JasMoH/Photoacoustic/lock_in_amplifier/photos/20171104_151610.jpg

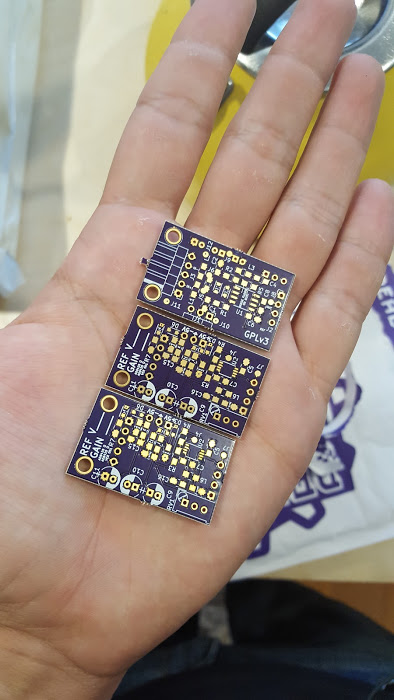
lock_in_amplifier/photos/20171104_151610.jpg
