JasMoH/Photoacoustic/lock_in_amplifier/photos/20171107_141212.jpg

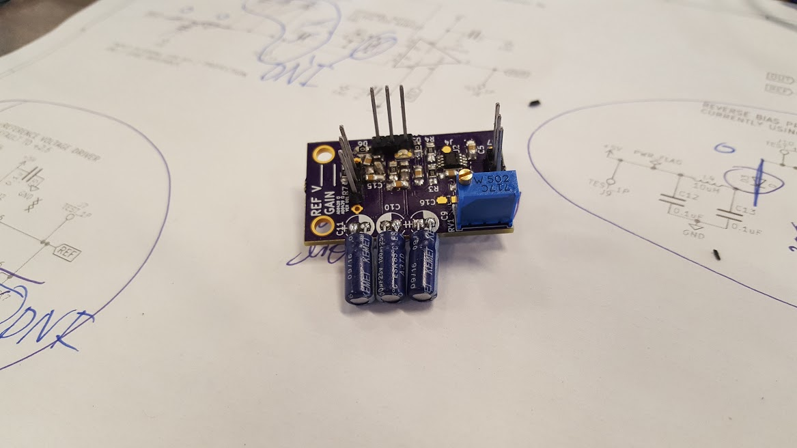
lock_in_amplifier/photos/20171107_141212.jpg
