JasMoH/Photoacoustic/lock_in_amplifier/papers/mosfet_noise.pdf

Noise sources in a MOSFET transistor, 25-01-99, JDS

NIKHEF, Amsterdam.

1. Noise sources in MOSFET transistors.

The noise sources in a MOS transistor are:
thermal noise in the channel,
1/f noise,
Noise in the resistive poly gate,
noise due to the distributed substrate resistance,
shotnoise associated with the leakage current of the drain source reverse diodes.
For normal use, only the first two items are important. The other noise sources must be taken into account for very low noise applications.
1.1. Channel thermal noise.

A MOSFET has in normal working order an inverse resistive channel between the drain and the source. The gate voltage forms with minority carriers the channel. In the extreme case when the drain source voltage
= 0 VDS , the channel can be treated as a homogeneous resistor. The noise in the channel is:

0

2

i | 4 k T g d = ⋅ ⋅ ⋅ | Equation 1.
k | Boltzman constant,
T | Absolute temperature
g0 | channel conductance at zero drain-source voltage.
Normally however the voltage | ≠ 0 VDS | . The VGS is higher as the VGD .
Therefor the channel is more conductive nearby the source, compared to the drain. Conclusion is the channel is not a homogeneous resistor anymore. To calculate the noise it must be split into small parts ( Δx ). The noise must be calculated in every one of those parts and then integrated along the whole channel.
The formula is:
Q (V )dV
L I

W i k T

VDS

n
DS
d | ∫
⋅
⋅

⋅
= ⋅ ⋅ ⋅

0

2
2

2 2
2
4

m
Equation 2.
W | Channel width,
L | Channel length,
μ | Effective channel mobility,
IDS | Drain source current.
The formula for Q (x) n
is:
Q (x) C (V | V (x) V(x)) n | = ox
⋅ GS − T | − | Equation 3.

Cox gate oxide capacitance per unit area,
VT(x) Threshold voltage at position x,
V(x) Channel potential.

In general is the Voltage VT(x) position or channel potential depending. By neglecting this dependency the integral in equation 1 becomes:
( | ) | ( | )
( | )
⋅ | − | −
⋅ | − | ⋅ | − ⋅ | − | −
= ⋅ ⋅ ⋅ ⋅ | ⋅ ⋅
GS | T | DS
GS | T | DS | GS | T | DS
d | ox | V | V | V
V | V V | V | V | V
L
W i | k T | C
2
3 | 3
3

2
4

2 2
2

m

Equation 4.

With the MOSFET we have 3 operation areas: linear region (VDS<VGS-VT), saturation point (VDS=VGS-VT) and saturation region (VDS>VGS-VT).
In the linear region is equation 4 the same as equation 1.
At the saturation point we can simplify the equation to:
( | ) d | ox | GS | T | m V | V | k T | g
L
W i = ⋅k ⋅T ⋅ ⋅ ⋅C ⋅ ⋅ | − | = ⋅ ⋅ ⋅ ⋅
| | 3

2
4
3

2
4

2

m | Equation 5.
gm | The transconductance of the MOSFET.

In the saturation region theoretically its not allowed to use equation 5, however experimentally has been found out that it’s a good approximation, as long as the device shows a good saturation. The reason for this is the fact that the cut-off region nearby the drain is much smaller then the resistive reverse channel which is responsible for the noise.
The expression in equation 5 predicts the thermal noise in the channel without the substrate effect. In practice the thermal noise is higher. This is due to the fact, that VT is depending on the channel potential V(x).
The integral in equation 2 is now hard to solve. In short the result is:
d | m

i = 4⋅ k ⋅T ⋅g ⋅ g
2
Equation 6.

The factor g is a complex function of the basic transistor parameters and bias conditions. To give g a value a numerical approach is required.
For modern CMOS processes with oxide thickness tox in the order of 50 nm and with a lower substrate doping Nb of about 10¹⁵ - 10¹⁶ cm⁻³ the factor g is between 0.67 and 1.

The current noise in the channel also generates noise in the gate through the gate-channel capacitance CoxWL. The gate noise is due to the capacitative coupling frequency depending. (f

2
).The gate noise is about:

( )

2
2 | 2
5
2 | 4
5

1
4
⋅ ⋅ ⋅ | ≈ ⋅ ⋅ ⋅ | ⋅
⋅

≈ ⋅ ⋅

T

m

m

g
f
g | f
f | k T
g
i | k T | p
CGS | gate-source capacitance.

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
The cut off frequency of the MOSFET.

When we compare the gate noise with the drain current noise the only time the gate current noise is important is when the frequency f>fT. Therefore in most practical situations this noise can be neglected.

1.2. 1/f Noise in MOS Transistors.

1/f noise has been observed in all kind of devices, from homogeneous metal film resistors and different kind of resistors to semiconductor devices and even in chemical concentrated cells. Because 1/f noise is well spread over the components, people think that there a fundamental physical mechanism is behind it. Till now such a mechanism is not yet found.
There is a lot of experimental evidence that several mechanisms are involved in generating 1/f noise.
The MOS transistor has the highest 1/f noise of all active semiconductors, due to their surface conduction mechanism.
The result is: several theory's and physical models competing together to explain the 1/f noise in a MOSFET. These theory's and models differ in detail but are all based on the mobility fluctuation model expressed by the Hooge empirical relation, and the carrier density or number fluctuation model first introduced by McWhorter.
1.2.1. The Mobility Fluctuation Model.

When we use the Mobility Fluctuation model we refer to the 1/f noise as Δμ-1/f noise. The model is described by the Hooge empirical equation:

I | N f
i | l
f
⋅

=

a

2

2
Equation 7.
The parameter al is called the Hooge 1/f noise parameter. N is the total number of free carriers in the device and I the short circuit current through the device.
The equation has been checked experimentally with several homogeneous metals and semiconductors (Si and GaAs) and proved to be OK. With all the samples a value of about 2*10⁻³ for al is found. The fact that al almost constant indicates that the Δμ-1/f noise is a fundamental phenomenon.
Theoretical you can derive from Equation 7 the assumption that 1/f noise is caused by N independent free carriers, each generating 1/f noise due to mobility fluctuation.
Experiments proved that only photon scattering rises the 1/f noise.
If in one particular device, for example a MOSFET more than one scattering mechanism exist, impurity scattering, surface scattering, the Hooge 1/f noise parameter a/ should be reduced to:

2
= ⋅

l

eff
l
m

m
a a | Equation 8.

ml is the mobility when only lattice scattering is present and meff is the effective mobility of the device according to Matthiessen's theorem:

= +∑

n

eff | l | i | i

i
m | m | | m
1 | | | 1
Equation 9.

In equation 9 n is the total number of different scattering processes.

Important is the fact, that the Hooge equation is only valid for homogeneous devices. A not homogeneous device the differential form of the equation must be used.

When a MOSFET is used in the linear region, VDS << VSAT = VGS - VT, the inverse channel is almost a homogeneous resistor.

Under strong inversion condition the total number N if the free charge in the inversion channel is given by:

( | ) N Cox W L VGS | VT
q ⋅ = | ⋅ ⋅ ⋅ | − | Equation 10.

The drain source current IDS for very small drain source voltages UDS is:

DS

eff
DS | V
L
q | N
I | ⋅
⋅ | ⋅
= | 2

m
Equation 11.

When we fill these two equations into the Hooge equation (7) the result is:

L f

q I V
i
eff | DS | DS

l

eff
f l
⋅
⋅ | ⋅ | ⋅
⋅
= | 2

2
2

m
m

m
a | Equation 12.

When we check equation 12 with the reality we find a deviation of an order of 10³

- 10⁴
| . Therefore the conclusion is that the Hooge equation is
not valid for the MOS inversion channel.

For a MOSFET in the saturation region, with the drain source voltage VDS is larger than the saturation voltage, the channel is, even in the x direction, not a homogeneous layer. To solve this we divide the channel into a number of small sections Δx. For each section the Hooge equation can be used. By integrating these over the whole channel the total 1/f noise power spectrum can be calculated:
( )

L f

q | V | V I
i
f | GS | T | DS
f | l
⋅
⋅ | − | ⋅
= ⋅
2

2

m
a | Equation 13.

The transconductance of a MOS transistor is related to IDS by:

m | eff | ox | DS I
L

W
g = 2⋅m ⋅C ⋅ ⋅ | Equation 14.

The equivalent input 1/f noise voltage spectrum density is then:

According to equation 15 is the 1/f noise proportional to VGS - VT, and inversely proportional to the gate oxide capacitance per unit area Cox and the gate area WL, provided that meff and mf do not change with to VGS - VT. These proportionalities have been seen in some experiments, the majority of experiments however show a different outcome. These experiments can be declared with the number fluctuation model.
1.2.2. The number fluctuation model.

In the number fluctuation model we call the 1/f noise Δn-1/f noise.
It is believed to be caused by the random trapping and detrapping of the mobile carriers in the trap located at Si-SiO2 interface and within the gate oxide. This causes a signal with a Lorentzian or generation-recombination spectrum. Superposition or a large number of these signals with the proper time constant result in a 1/f-noise spectrum.
According to this model, the Δn-1/f noise is proportional with the effective trap density near the quasi-Fermi level of the inverse carriers. This has been verified by a large number of experiments.
Also explained by this model is the 1/f noise in the weak inversion region. It is observed that the relative 1/f noise current 2 2
i I f

has a
plateau in this region, which can be explained in the model.

In the interface between Si-SiO2 and in the gate oxide (oxide traps) additional energy states exist. These states and traps communicate randomly with the free charges in the channel. This mechanism obeys the Schokley Read Hall statistics. By using this statistics the mean square fluctuation dnt in the number of trapped carriers in a volume DV = (Wdxdy) at a specific position is given by:
nt

⋅ Nt

⋅ f
t

⋅ f

pt ⋅ΔV
+ ⋅

⋅
= | 2 | 2
1

4
w t

t
d | Equation 16

t = trapping time constant [s].
Nt= trap density [cm⁻³].

k T

t | Et Ft
e

f
⋅

−
+
= | ( | )
1

1
= Fraction of filled traps under steady state condition.

Et = trap energy level [eV].
Ft = trap quasi-Fermi level [eV].

The fluctuation dnt causes fluctuations in the channel free carriers dN that in its turn causes fluctuation in the channel current dIDS.
In strong inversion it is shown that dN = dnt.

( )

C W L f

q | V | V
v
eff | ox
f | GS | T
f | l
⋅ | ⋅ | ⋅ ⋅ ⋅
⋅ ⋅ | −
= ⋅
m

m
a
2

2
Equation 15.

The number of free carriers N is:
( ) | ( | ( ))
∫ | ∫
⋅ = ⋅ | = | ⋅ | ⋅ | − −

L

ox | GS | T

L
q N | q n x dx | W C | V | V V x dx
0 | 0

Equation 17.

The drain source current is given by:
( )

( )
dx

dV x
I | q n x DS = ⋅ | ⋅ m ⋅ | Equation 18.

For the fluctuation of the drain current due to fluctuation in trapped carriers in an elementary volume DV is:
( )
( ) | ( | ( ))

( ) 2

2

2
2

2
2
t
ox | SAT
DS | DS
d

n
dx

dV x
L W C | V | V x

q I
N
L n x

I
i f | d

m
d | d | ⋅
⋅ ⋅ | ⋅ | −

⋅
⋅ =
⋅

=

Equation 19.

To calculate the total 1/f noise we have to integrate equation 19 along the channel, over the energy band gap and into the oxide. The general expression is given in equation 20

Equation 20

To evaluate this integral we must first determinate the distribution of Nt(E,y), t(y,E,V) and the function ft(E,V).
When we have a single trap with an uniform distribution into the oxide, Nt(Et,y) = Nt(Et). The distribution of trapping time constant t(y,E,V) based on the SRH statistics and the tunnelling model of McWorter:
( )
y
y e

⋅
= ⋅

a
t | t 0
with | ( | ) 1
0

1
c n n ⋅

s +

t = | Equation 21
α | = 10⁸
cm

-1
, | McWorter tunnelling constant.
( | )
k T

F E
s | i
n | i
n | n e

⋅

−
= ⋅ | The surface carrier concentration.
( | ) k T
F E
i

t i
n n e

⋅

−
= ⋅
1
c | = 10⁻⁸ cm³
/s The electron capture coefficient.

In the practical case t0 = 10⁻¹⁰ s. The traps are distributed into the oxide d = 50 Å, the maximum trapping time constant is tmax = 5 10¹¹
s.
With this information we can work out the integral into the oxide:
( | )
( | )
( ) | [ | ]

( )
f

N E

N E
y E V

y E V

t | t
t | t

d

⋅ ⋅

⋅

⋅ | ⋅ | − | ⋅ | =
⋅
⋅ | ⋅
+ | ⋅

⋅
∫

a

w t | w t
w t | a w

t

4

1

arctan | arctan

1
1 | , ,
4 | , ,
max | 0
0

2 2

( )
( | ( ))
( | )
( | )

N (E y) f (E V ) f (E V )dydEdv y E V

y E V
L C | V | V x

q I
i f
t | t | pt

VDS E

E

d
OX SAT DS
d

c

v

, | , | ,
1 | , ,
4 | , ,
0 | 0
2 | 2

2
2
⋅ | ⋅ | ⋅
+ | ⋅

⋅
⋅
⋅ | ⋅ | −

⋅ ⋅
= ∫ ∫∫ | w t
m | t

for

max | 0

2

1
2

1
p t | | | ⋅p ⋅t

< <
⋅ ⋅
f | Equation 22.

Under the condition of a constant space trap distribution a pure 1/f-noise spectrum is obtained in the frequency range of 10⁻¹³ < f < 10⁹
Hz.
Normally the space trap distribution is not constant, the spectrum shows an 1/fα
spectrum with α <> 1.

The next integral to solve is the integral over the trap distribution in the band gap. The exact trap distribution Nt(E) is of minor importance. The only traps that are effective in noise generation, are the traps around the electron quasi-Fermi level Fn. Therefor a good approximation for the integral over the energy band is given by:
( ) ( ) ( ) | ( ) ( ) ( ) t | pt | t | n | t | n | pt | n

E

E

Nt E f E V f E V dE k T N F f F f F

c

v

⋅ | = ⋅ ⋅ ⋅ | ⋅ | ⋅

∫
, | , | 4

Equation 23.

After solving these integrals equation 20 is reduced to:
( )
( ( ))

N (F ) f (F ) f (F )dV
f | V | V x

k T
L C

q I
i f
t | n | t | n | pt | n

V

OX | SAT

DS
d

DS
⋅ | ⋅ | ⋅
⋅ | −

⋅
⋅
⋅

⋅ ⋅
= | ∫
| 0

2

2
2 | 1
a

m

Equation 24.

The quasi-Fermi level is not a constant along the channel. Due to this the function ftfpt varies as well. The expression using SRH statistics is:
( ) ( )
( | )
2 2 | 2

4

2 s i

s
t | n | pt | n
n | n

n
f F f F
⋅ +
⋅ | = | Equation 25

ns(x) is the surface density of the inversion electrons in the channel which is according to the elementary MOS theory related to the channel potential:
( )

SAT

SAT
s s
V
V | V x
n | n

−
= | ⋅
0 | Equation 26

With the equations 25 and 26 the integral in equation 24 can be solved, provided that Nt(Fn) is known. For the simplest case where Nt(Fn) is uniformly distributed in the energy band or at least around Fn the integral is given by:

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
= 2 | 2 | 2

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
SAT DS

t

ox

DS
d
n

n
V
f | V | V

k T N
L C

q I
i f
a

m

Equation 27

The solution in equation 27 is valid under the conditions that:

The traps are uniformly distributed in the space and energy band, or at least around the electron quasi-Fermi level Fn.

The working area for this formula is the linear region till the saturation point VDS>VSAT=VGS-VT.

In the saturation (VDS>VSAT) area the channel thermal noise saturates as well. If in equation 27 VDS<<VSAT , the second term in the denominator in the ln-function can be ignored. The drain current noise increases with the increase of the drain source voltage. The equation reduces to:
( )
C L f

K I
n

n
f

k T N
L C

q I
i f

ox

F DS

i

t | so

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
= 2 | 2

2
2 | 2
ln
16

1
a

m
Equation 28.

The value of KF is constant if Nt(Fn) and nso do not change that much with the bias condition.

Combining equation 28 with equation 14 gives:

1.2.3. Comparing equation 15 and equation 29, we see two discrepancies between the two models (Δμ-1/f and Δn-1/f).

1)In equation 29 the noise is independent of any dc bias condition, while in equation 15 it is directly proportional to the effective gate voltage (Vgs-VT).

2)In equation 29 the noise is inversely proportional to Cox

2
, while
according to equation 15 it is proportional to Cox.

The two discrepancies between the two models don't mean that one of the models is incorrect. Other parameters like the effective mobility μ may affect the noise dependency on the dc bias condition and the oxide thickness.

Many experiments however show a strong dependence of the 1/f noise in a MOSFET on the state density. They can be fitted in equation 29.

( )
C W L f

K
C W L f

K
v f

ox

f

ox

F
f
⋅ ⋅ ⋅

=
⋅ ⋅ | ⋅ ⋅ ⋅
= | 2 | 2
2
2 m

Equation 29

1.3.Additional Noise Sources.

In very low noise applications some other noise sources can get important. These sources are:
1) the thermal noise associated with the resistive poly-gate Rg,
2) Thermal noise due to the resistive substrate Rb,
3) the shot noise associated with the leakage current of the drain-source inverse diodes.
Because the leakage current is always much smaller then the drain current IDS, it's effect is always negligible. On the other hand, if you don't take special precautions in the layout, the noise due to Rg and Rb can prevail over the channel thermal noise.
1.3.1. Resistive Poly-gate Noise.

To calculate the noise due to the poly-gate we use the same procedures as for calculating the MOS channel thermal noise.

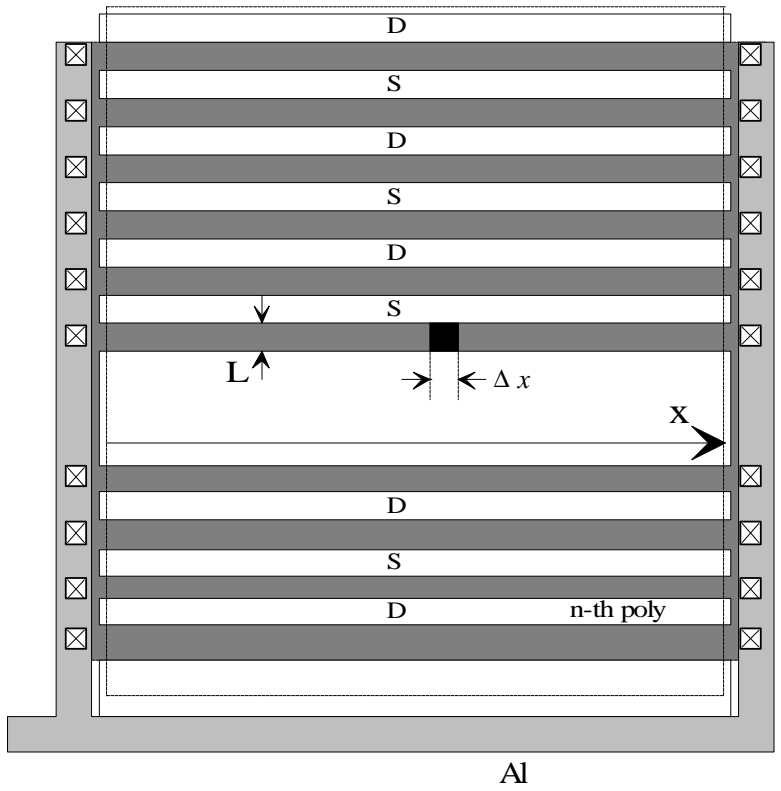
[picture p10: figure]
n-th poly

Figure 1: The finger structure of a MOS transistor.

In practice the finger structure is the most used for a MOS-FET with a large W/L ratio. The advantages of this structure are:
1) Lower CBS and CBD capacitance.
2) More useful in layout to realise.
The total channel width W in this structure is divided into n poly stripes with an equal width of WI = W / n. Both ends of the stripes are connected to aluminium (Al) strips for low noise reasons. The sheet resistance of Al is about 0.05 Ω/sq. and of poly the value is about 25 Ω/sq. The noise contribution of the Al is negligible compared with the contribution of the poly.

The thermal noise of the section Dx is, according to the Nyquist theorem:

L

x
Vx

k T
sq

Δ
Δ = 4⋅ ⋅ ⋅ r ⋅ | Equation 30

rsq is the sheet resistance of the poly gate. The voltage fluctuation dV (x) in the I-th stripe is given by:
( ) | ( ) | x

i

V
W

x
dV x = dV 0 − | ⋅Δ for 0 < x < x0. | Equation 31
( ) | ( ) | x

i

i | V
W

W x
V x | V W | ⋅Δ

−
= −
1
d | d | for x0 < x < wi. | Equation 32

Both ends of a stripe are short-circuited via Al, so dV (0) = dV (Wi). The drain current fluctuations due to the noise voltage are given by:
( ) | ( )
( | )
x | mi

i

W
d | mi | V g
W | x
i | V x g x dx

i

d | d | d | ⋅Δ ⋅d −
Δ | = | ⋅ | = ∫
| | | 2 2 0
| 0

Equation 33

The term dgmi(x) is the transconductance per unit length at position x. We assume that it's constant over the whole stripe Wi.
The drain noise current per stripe is given by:

2

0

2 | 2
12
4 | mi

i

W
d | d | g R
i | i | k T

i
Δ = Δ | | = ⋅ ⋅ ⋅ ⋅

∫
d | Equation 34

In this formula
L

W
R

i

i | sq = r ⋅ | is the resistance and gmi | gmi Wi = d ⋅ is the

transconductance of the i-th stripe. The total noise current is given by simply multiply the expression by n.

2
2
2 | 2
12

4
12
4 | m

g
mi

i
d | g
n

R
g k T

R
i | k T n | ⋅
⋅
Δ = ⋅ ⋅ ⋅ ⋅ ⋅ | = ⋅ ⋅ ⋅ | Equation 35

Rg = nRI is the total gate resistance and gm = ngmi is the total transconductance of the MOSFET.

When we observe equation 35 it's clear that in order to minimise the noise due to the resistive gate the number n should be as large as possible.
A second remark is that if in the finger structure only one side of the gate is connected together with Al, the noise increases with a factor 4.

1.3.2. Substrate resistance noise.

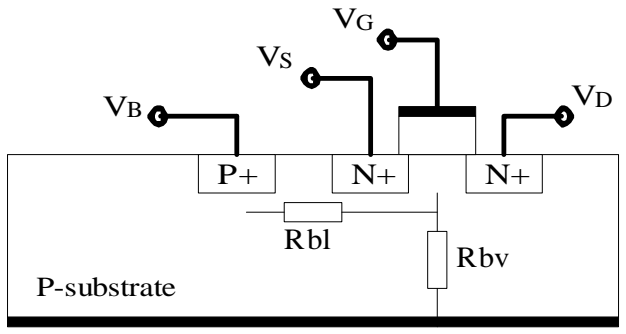
[picture p11: figure]
Rbl; Rbv; P-substrate

Figure 2: The substrate resistors in a nMOS transistor.

In figure 2 the substrate resistors in a nMOS transistor are drawn. The calculation of the noise due to these resistors is more complicated as from the poly gate, because of the distributed nature of the resistors. When we compare both resistors we see that the value of Rbv is much larger as Rbl. Due to this for noise calculations we can neglect Rbv.

The resistor Rbv is proportional to the distance between the bulk contact and the channel and with 1/Wi. The result of the noise in the resistor is the modulation of the channel current due to the bulk transconductance.

f | BS
mb | m
V

K
g g
⋅ ⋅Φ +

= ⋅
2 2
2 | Equation 36.

In this formula K2 is defined before. FF is the difference between the quasi-Fermi level and the intrinsic level.
The total current noise due to the bulk resistor is there for:|
2 | 2 | 2
4 | 4 mbi | mbi

i

dB | g
W

b
g k T B
W

b
i = ⋅ k ⋅T ⋅ n⋅B⋅ ⋅ | = ⋅ ⋅ ⋅ ⋅ | ⋅ | Equation 37.

The only way to reduce the bulk noise is by biasing the bulk to minimise the noise.

Reference: Low-Noise Wide-Band Amplifiers in Bipolar and CMOS Technologies, Zhong Yuan Chang and Willy M.C. Sansen.
