JasMoH/Photoacoustic/lock_in_amplifier/instrumentation amp bob/inst_amp_v1_render.png

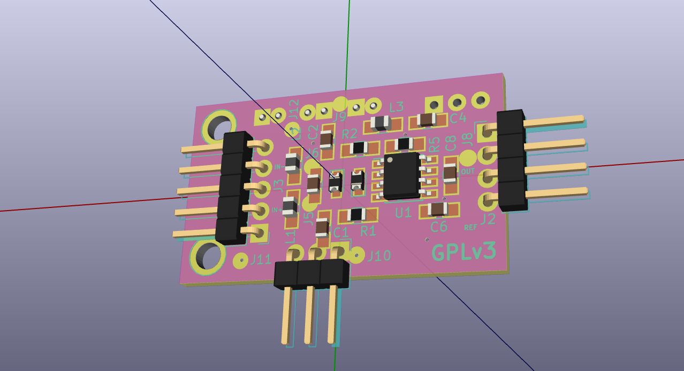
lock_in_amplifier/instrumentation amp bob/inst_amp_v1_render.png
