JasMoH/Photoacoustic/lock_in_amplifier/LIA_Build/dr1 images/lia-design-review.png

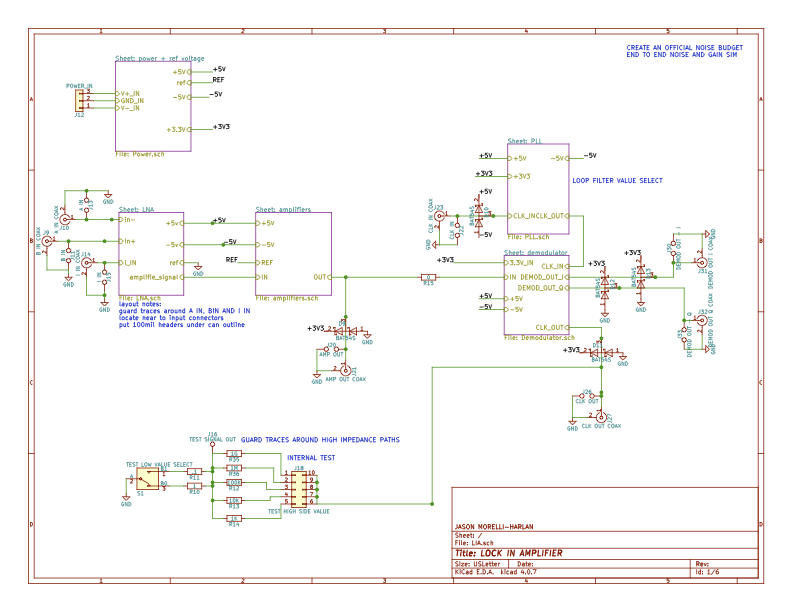
lock_in_amplifier/LIA_Build/dr1 images/lia-design-review.png
