JasMoH/Photoacoustic/lock_in_amplifier/photos/20171109_171020.jpg

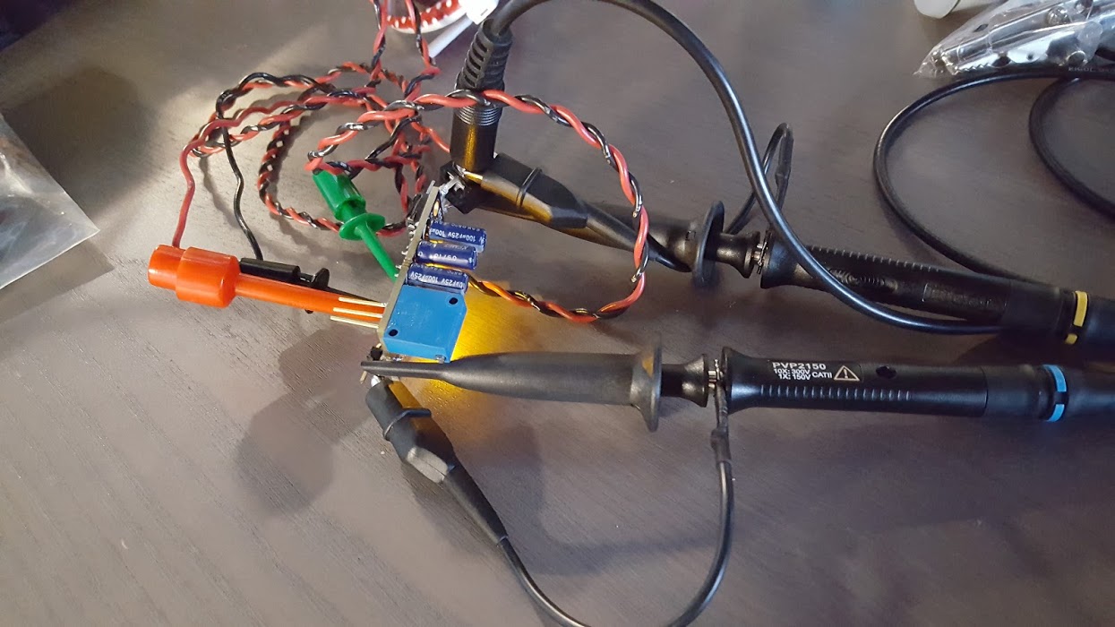
lock_in_amplifier/photos/20171109_171020.jpg
