JasMoH/Photoacoustic/lock_in_amplifier/papers/a_low_noise_laboratory-grade_measurement_preamplifer/low_noise_lab_preamp_BOM_r3.xls

Designator | Quantity | Part Type | Footprint | Description | Manufacturer | Manufacturer Part Number | Mouser Part Number | Comment
C101, C301 | 2 | 1 uF | radial 15 mm | Polypropylene Film Capacitor | Panasonic | ECW-F2105JA | 667-ECW-F2105JA
C102, C108, C109, C202, C203 | 5 | 10 uF | 1206 | Ceramic Capacitor X7R, 25 V | Murata | GRM31CR71E106KA12L | 81-GRM31CR71E106KA12
C103 | 1 | 150 pF | 0805 | Ceramic Capacitor C0G, 50 V | Murata | GRM2165C1H151JA01D | 81-GRM40C151J50D
C104, C107, C303, C304 | 4 | 100 nF | 0805 | Ceramic Capacitor X7R, 50 V | Murata | GCM21BR71H104KA37K | 81-GCM21BR71H104KA37
C105 | 1 | 15 pF | 0805 | Ceramic Capacitor | Murata | GRM2165C1H150JZ01D | 81-GRM40C150J50D
C106 | 1 | 22 pF | 0805 | Ceramic Capacitor | Murata | GRM2165C1H220JZ01D | 81-GRM2165C1H220JZ
C201 | 1 | 220 uF | radial 3.5 mm | Electrolytic Capacitor, 35 V | Panasonic | EEU-FM1V221L | 667-EEU-FM1V221L
C302 | 1 | 1 pF | 0805 | Ceramic Capacitor C0G, 50 V | Murata | GRM2165C1H1R0CD01D | 81-GRM40C010C50D
D101, D202, D203, D204, D205, D301, D302 | 7 | 3.3 V | SOD-123 | Zener Diode | Vishay | BZT52C3V3-V-GS18 | 625-BZT52C3V3-VGS18
D102, D201, D206, D207, D208, D209, D210, D211 | 8 | 1N4148W | SOD-123 | Diode | Vishay | 1N4148W-V-GS18 | 78-1N4148W-VGS18
D212 | 1 |  |  | Light Emitting Diode |  |  |  | Mounted off-board; pick your favourite LED type...
D303, D304 | 2 | 1N4004 | axial 10 mm | Diode | Fairchild Semiconductor | 1N4004 | 512-1N4004
F301, F302 | 2 |  | 1206 | Resettable Fuse, 160 mA | Littelfuse | 1206L016WR | 576-1206L016WR
J101 | 1 |  | 3.81 mm | Connector, 2 Contacts | Phoenix Contact | 1727010 | 651-1727010
J102 | 1 |  | 3.81 mm | Connector, 5 Contacts | Phoenix Contact | 1727049 | 651-1727049
J301 | 1 |  | 3.81 mm | Connector, 3 Contacts | Phoenix Contact | 1727023 | 651-1727023
L101, L102, L103, L104, L105, L106, L107, L108, L109 | 9 | 200 nH | 0805 | Ferrite Bead | Murata | BLM21AG121SH1D | 81-BLM21AG121SH1D
Q101, Q102, Q103, Q104, Q105, Q106, Q107, Q108, Q109 | 9/25 | BF862 | SOT-23 | N-Channel JFET | NXP Semiconductors | BF862,235 | 771-BF862-T/R | Match Q102-Q109 for Vgs @ Id = 1 mA; buy 25 pice
Q301 | 0 | BF862 | SOT-23 | N-Channel JFET |  |  |  | Don't fit; pads used to match Q102-Q109
Q201, Q202, Q205, Q207 | 4 | 2SA1312 | SOT-23 | PNP BJT | Toshiba | 2SA1312GRTE85LF | 757-2SA1312GRTE85LF
Q203 | 1 | MMBF5462 | SOT-23 | P-Channel JFET | Fairchild Semiconductor | MMBF5462 | 512-MMBF5462
Q204, Q206 | 2 | BC850C | SOT-23 | NPN BJT | Fairchild Semiconductor | BC850CMTF | 512-BC850CMTF
R101 | 1 | 10M | MiniMELF | Thin Film Resistor, 1% | Vishay Beyschlag | MMA02040C1005FB300 | 594-MMA02040C1005FB3
R102, R307 | 2 | 15k | MiniMELF | Thin Film Resistor, 1% | Vishay Beyschlag | MMA02040C1502FB300 | 594-MMA02040C1502FB3
R103, R121, R303 | 3 | 100r | MiniMELF | Thin Film Resistor, 1% | Vishay Beyschlag | MMA02040C1000FB300 | 594-MMA02040C1000FB3
R104 | 1 | 200M | axial 15 mm | Metal Oxide Resistor, 1% | Vishay Dale | RNX038200MFKEL | 71-RNX038200MFKEL
R105 | 1 | 1k | MiniMELF | Thin Film Resistor, 0.1% | Vishay Draloric | SMM02040D1001BB300 | 71-SMM02040D1001BB30
R106 | 0 | DNF | MiniMELF | Thin Film Resistor, 1% |  |  |  | Don't fit; used for optional high-accuracy gain trim
R107, R108, R109, R110, R111, R112, R113, R114, R115, R116 | 10 | 10r | 0805 | Thin Film Resistor, 0.1% | Bourns | CRT0805-BY-10R0ELF | 652-CRT0805BY10R0ELF
R117 | 1 | 91r | MiniMELF | Thin Film Resistor, 1% | Vishay Beyschlag | MMA02040C9109FB300 |  | Not stocked by Mouser, order e.g. from Distrelec (713049) or use replacement
R118, R119, R120 | 3 | 51r | MiniMELF | Thin Film Resistor, 1% | Vishay Beyschlag | MMA02040C5109FB300 | 594-MMA02040C5109FB3
R122, R123, R218 | 3 | 10r | MiniMELF | Thin Film Resistor, 1% | Vishay Beyschlag | MMA02040C1009FB300 | 594-MMA02040C1009FB3
R201, R202, R203, R204, R205, R206, R207, R208, R209, R210 | 10 | 130r | MiniMELF | Thin Film Resistor, 1% | Vishay Beyschlag | MMA02040C1300FB300 |  | Not stocked by Mouser, order e.g. from Distrelec (713053) or use replacement
R211, R305 | 2 | 1k5 | MiniMELF | Thin Film Resistor, 1% | Vishay Beyschlag | MMA02040C1501FB300 | 594-MMA02040C1501FB3
R212, R213 | 2 | 10k | MiniMELF | Thin Film Resistor, 1% | Vishay Beyschlag | MMA02040C1002FB300 | 594-MMA02040C1002FB3
R214 | 1 | 110k | MiniMELF | Thin Film Resistor, 1% | Vishay Beyschlag | MMA02040C1103FB300 |  | Not stocked by Mouser, order e.g. from Distrelec (713123) or use replacement
R215 | 1 | 100k | MiniMELF | Thin Film Resistor, 1% | Vishay Beyschlag | MMA02040C1003FB300 | 594-MMA02040C1003FB3
R216 | 1 | 11k | MiniMELF | Thin Film Resistor, 1% | Vishay Beyschlag | MMA02040C1102FB300 | 594-MMA02040C1102FB3
R217 | 1 | 2k7 | MiniMELF | Thin Film Resistor, 1% | Vishay Beyschlag | MMA02040C2701FB300 | 594-MMA02040C2701FB3
R301 | 1 | 1M | MiniMELF | Thin Film Resistor, 1% | Vishay Beyschlag | MMA02040C1004FB300 | 594-MMA02040C1004FB3
R302 | 1 | 750k | MiniMELF | Thin Film Resistor, 1% | Vishay Beyschlag | MMA02040C7503FB300 |  | Not stocked by Mouser, order e.g. from Distrelec (713143) or use replacement
R304 | 1 | 100k | 2.54 mm | Cermet Trimmer | Bourns | 3296Y-1-104LF | 652-3296Y-1-104LF
R306 | 1 | 12k | MiniMELF | Thin Film Resistor, 1% | Vishay Beyschlag | MMA02040C1202FB300 | 594-MMA02040C1202FB3
U101 | 1 | NE5534A | SOIC-8 | Low-Noise Operational Amplifier | Texas Instruments | NE5534AD | 595-NE5534AD
U301 | 1 | TL071 | SOIC-8 | JFET Operational Amplifier | Texas Instruments | TL071CDR | 595-TL071CDR
