JasMoH/Photoacoustic/lock_in_amplifier/LIA_Build/dr1 images/high gain amp.png

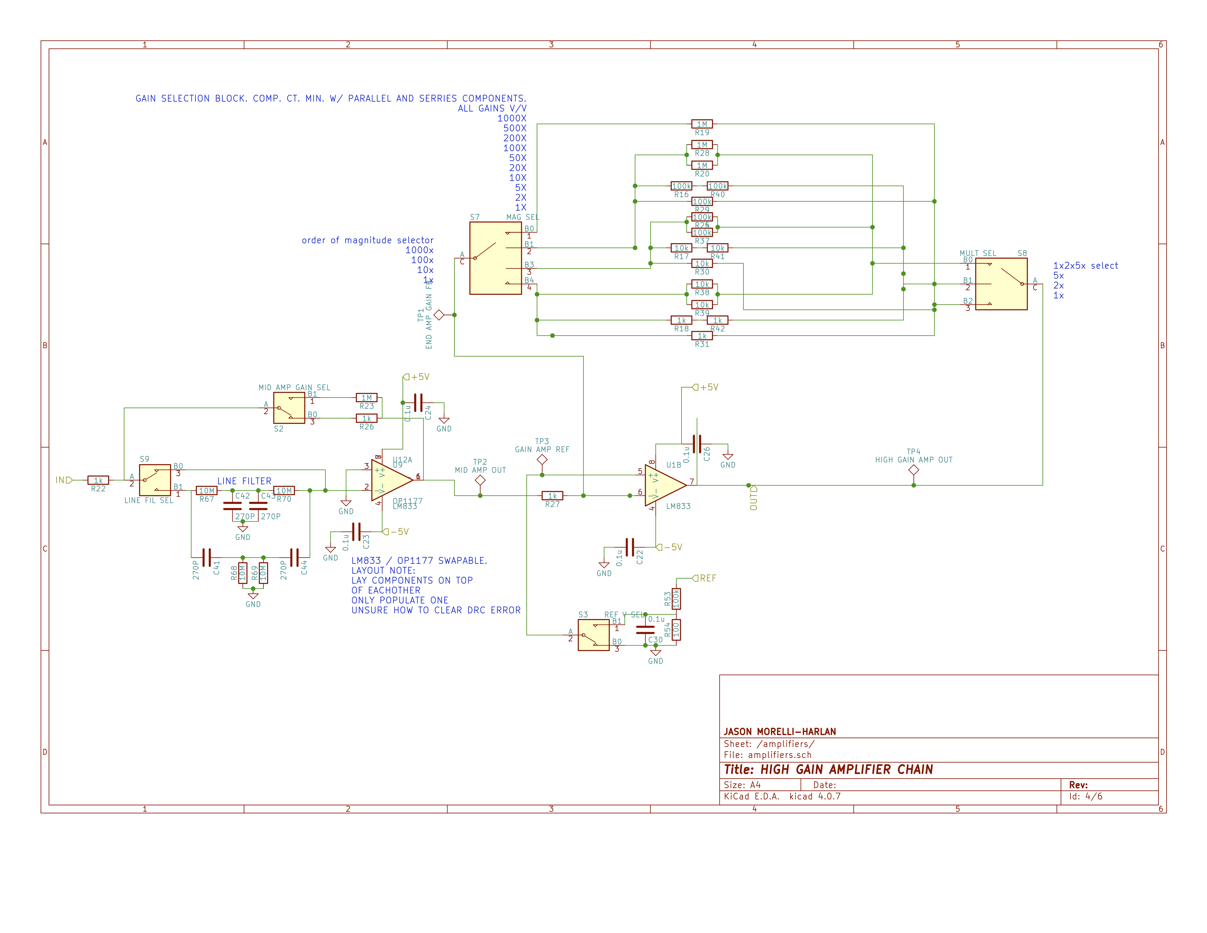
lock_in_amplifier/LIA_Build/dr1 images/high gain amp.png
