JasMoH/Photoacoustic/lock_in_amplifier/LIA_Build/dr1 images/pll.png

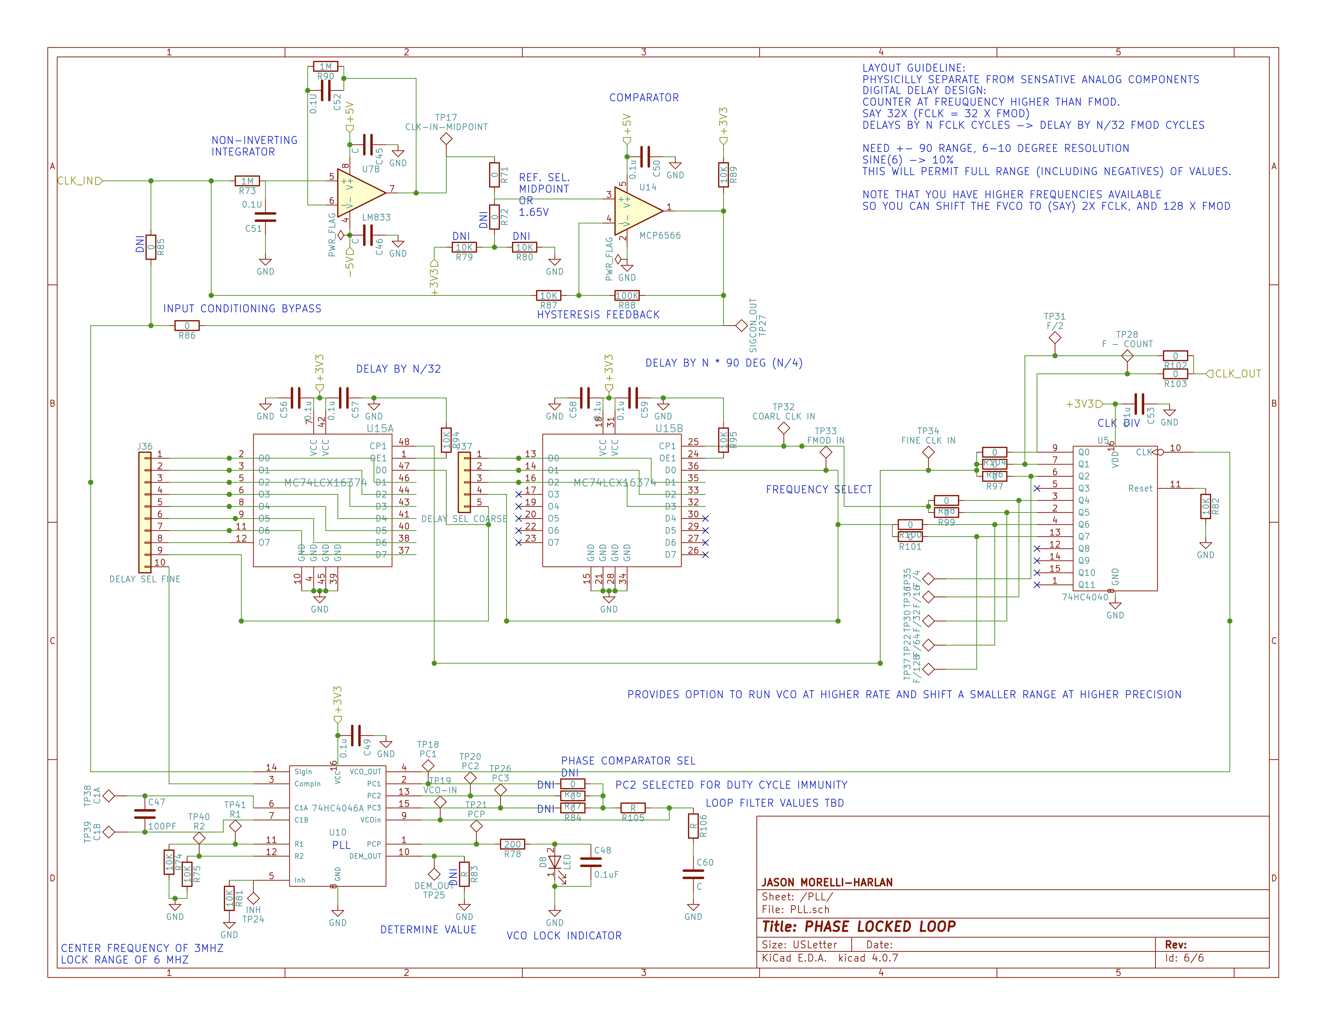
lock_in_amplifier/LIA_Build/dr1 images/pll.png
