JasMoH/Photoacoustic/lock_in_amplifier/LIA_Build/dr1 images/power.png

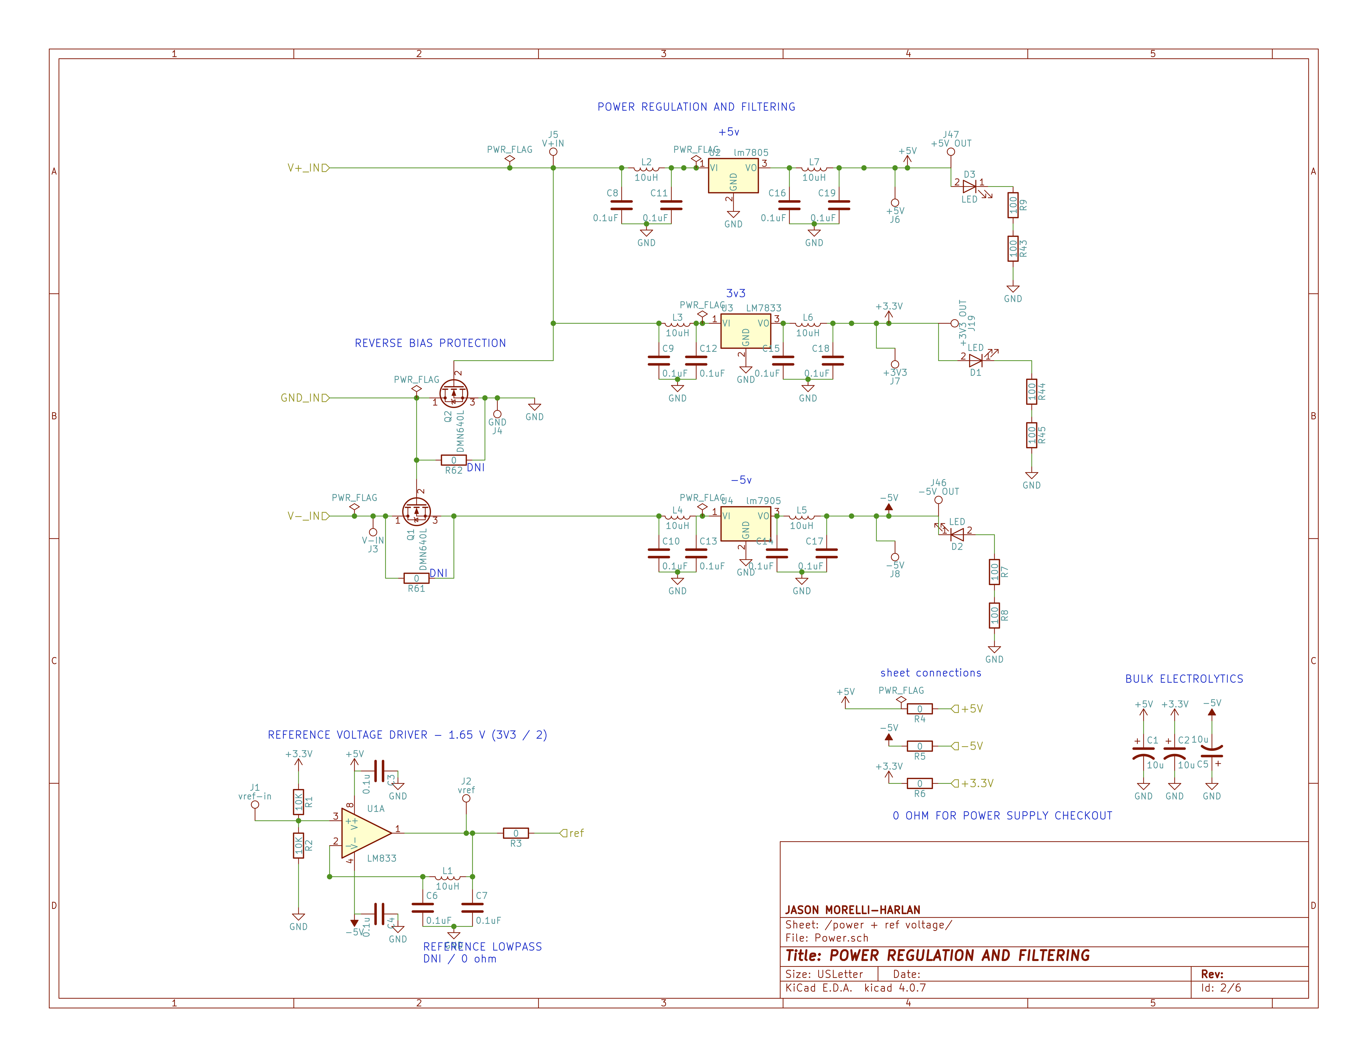
lock_in_amplifier/LIA_Build/dr1 images/power.png
