JasMoH/Photoacoustic/lock_in_amplifier/photos/DS1Z_QuickPrint1.png

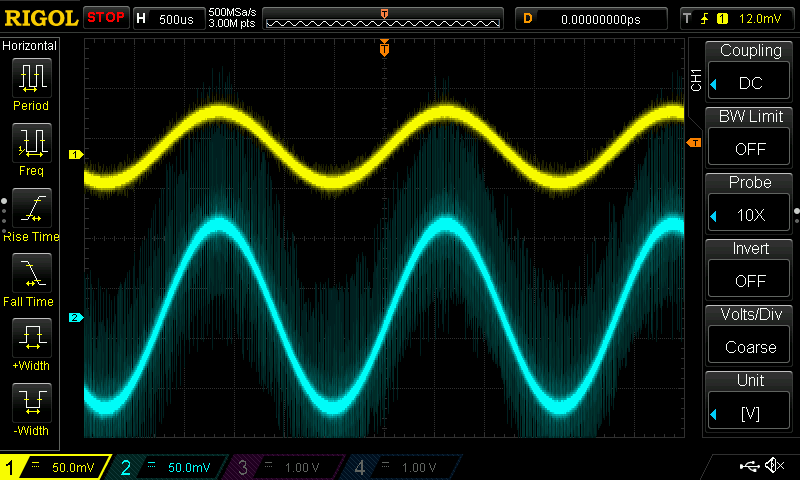
lock_in_amplifier/photos/DS1Z_QuickPrint1.png
