JasMoH/Photoacoustic/(threads)

Thread 1 (2017-12-10):

Sheet 2 - B2

aoberste, 2017-12-10:
Don't put a FET on the ground pin.  It can float your ground relative to system ground due to the voltage loss over the FED substrate diode.

JasMoH, 2017-12-29:
I'll go back to the good old fashioned serries diode for reverse bias protection.

I was pulling from here: http://www.ti.com/lit/an/slva139/slva139.pdf
of course floating your ground wouldn't be an issue for a battery powered device. that's what I get for paying attention.

Thread 2 (2017-12-10):

Sheet 2 - All Regulators

aoberste, 2017-12-10:
Inductors typically aren't required on the inputs/outputs of linear regulators.  The datasheets do not call for them.  I would be wary of including these without simulating, could affect stability.  The linear regulators in use already have noise levels in the uV range, there isn't much benefit to be gained from further filtering.

JasMoH, 2018-01-09:
Marked DNI/0 ohm jumpers, leaving footprint on for now in case I need to tweak.

Pull off of version 2 if unused.

Closed 2018-01-09.

Thread 3 (2017-12-10):

Reference Voltage

aoberste, 2017-12-10:
Your reference voltage will vary with R1 and R2 over initial tolerance and temperature swings.  Why use an op amp?  Can just drop in an linear regulator made for 1.65 reference gen for ~$1.

Thread 4 (2017-12-10):

Check LED current

aoberste, 2017-12-10:
You're using the same series resistance for 3.3V and 5V LEDs.  Without a parts list (using PDF), I can't tell if that's appropriate.  Check currents to prevent damage.

Thread 5 (2017-12-10):

RF Split

aoberste, 2017-12-10:
On sheet 3, it looks like you are splitting an RF input into two demodulators by simply "tee-ing" the trace, or tapping along the way.  This will cause issue.  Research a Wilkinson divider, it can generally be implemented with a few passives.

JasMoH, 2018-01-09:
I'm targeting sub 10 MHz for an initial design, and I'm honestly expecting to be sub 100 kHz for most of it. That's analog, not digital clock rate, so I'm not super concerned with harmonics.

Thanks for the tip though, that's a great design, and I have a soft spot for distributed microwave circuitry.

Closed 2018-01-09.

Thread 7 (2017-12-10):

Demod Outputs

aoberste, 2017-12-10:
On one demod, you've used the positive output.  On the Q you used the negative.  Is this right?

Also, you may need to terminate the unused leg.  Check the datasheet, it depends what type of driver is in the IC.

aoberste, 2017-12-10:
Correction, datasheet says to leave unused outputs floating.  However, it does say to decouple unused inputs to mid voltage.  Look into that.
