JasMoH/Photoacoustic/lock_in_amplifier/LIA_Build/lia-design-review.pdf

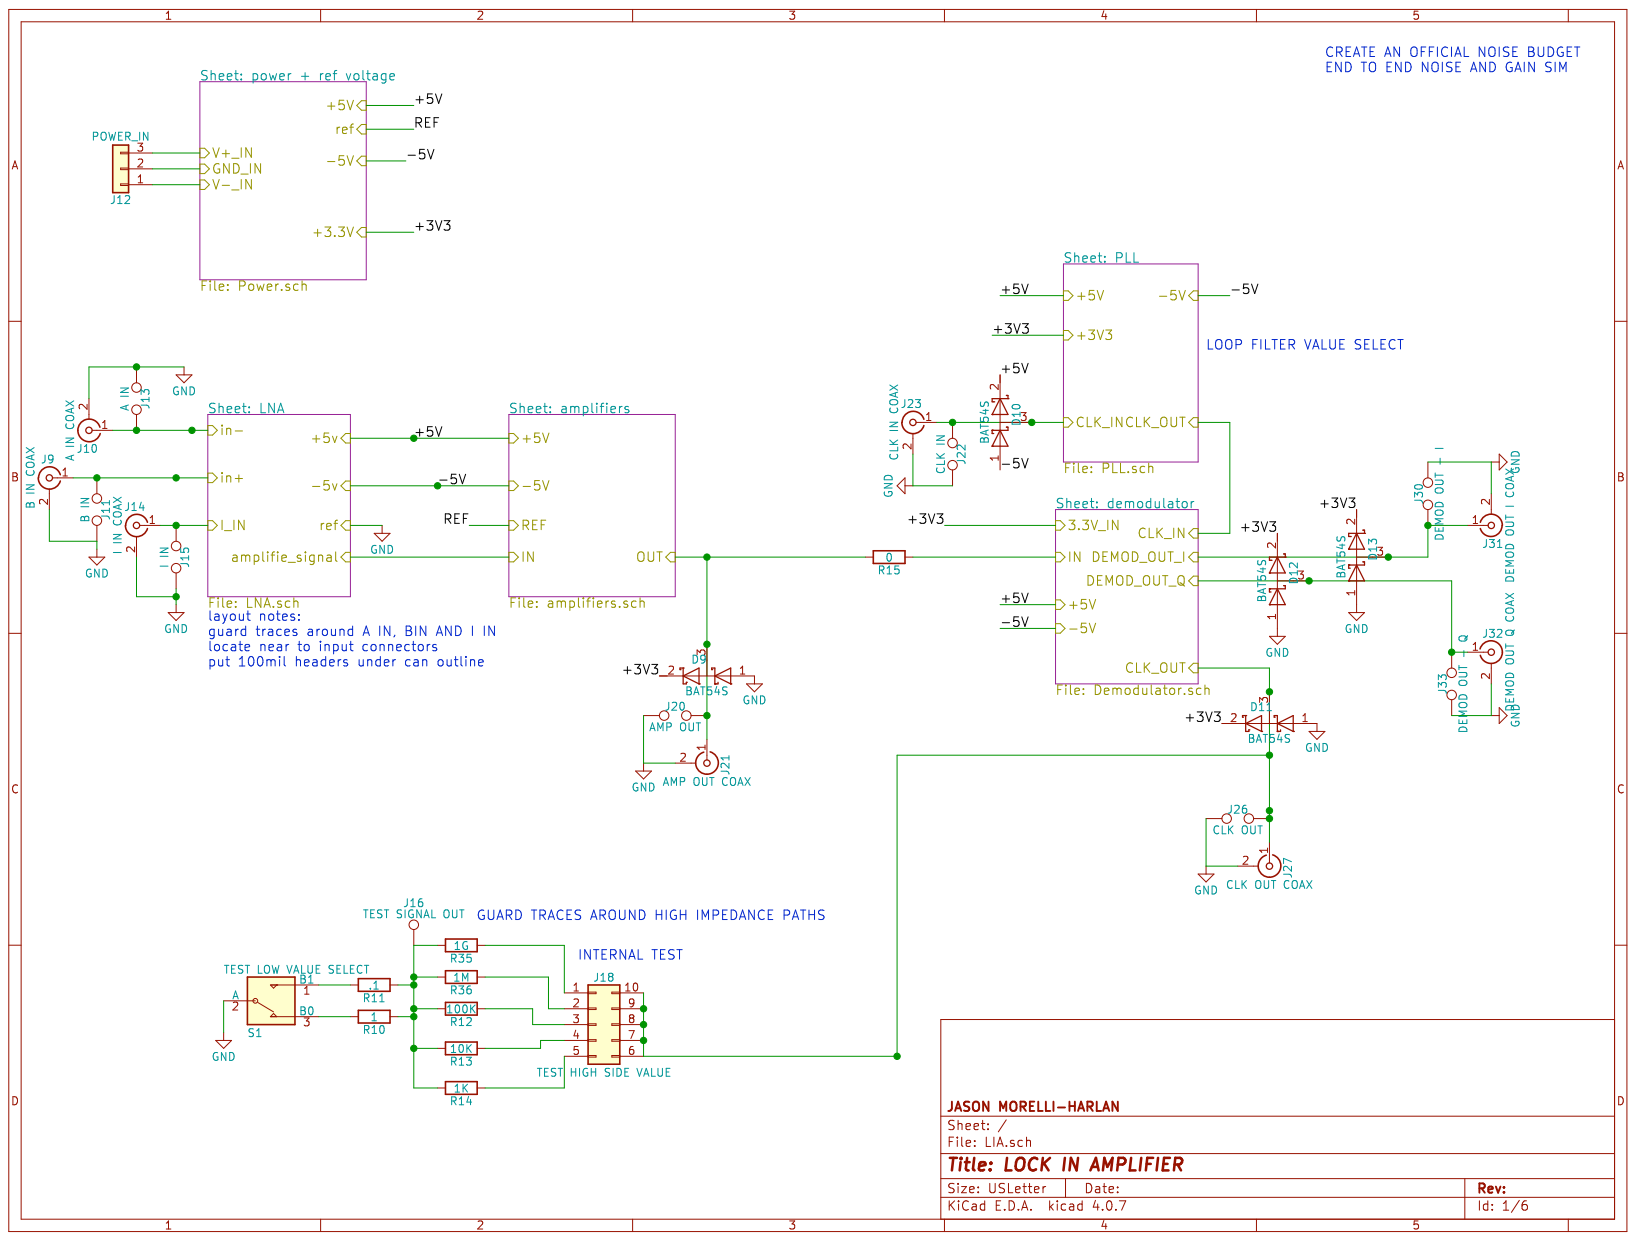
[picture p22: page 1]

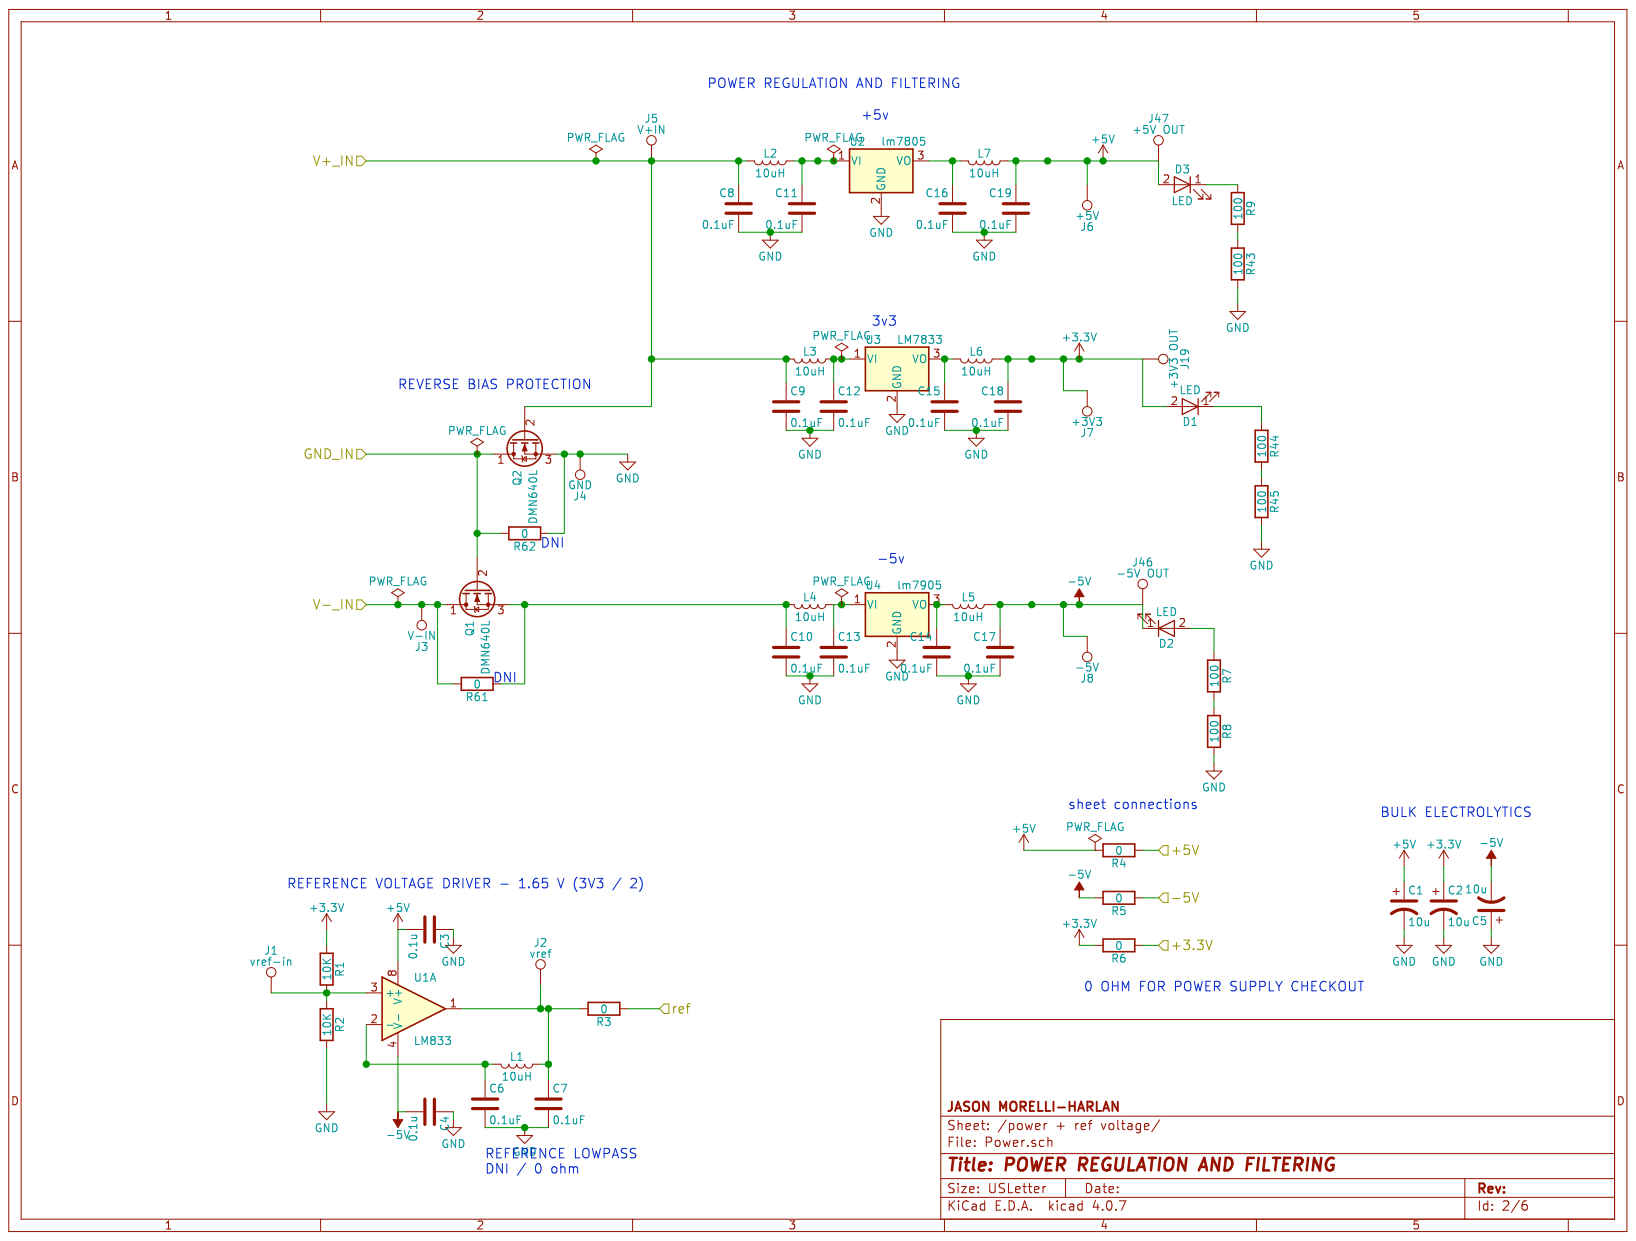
[picture p23: page 2]

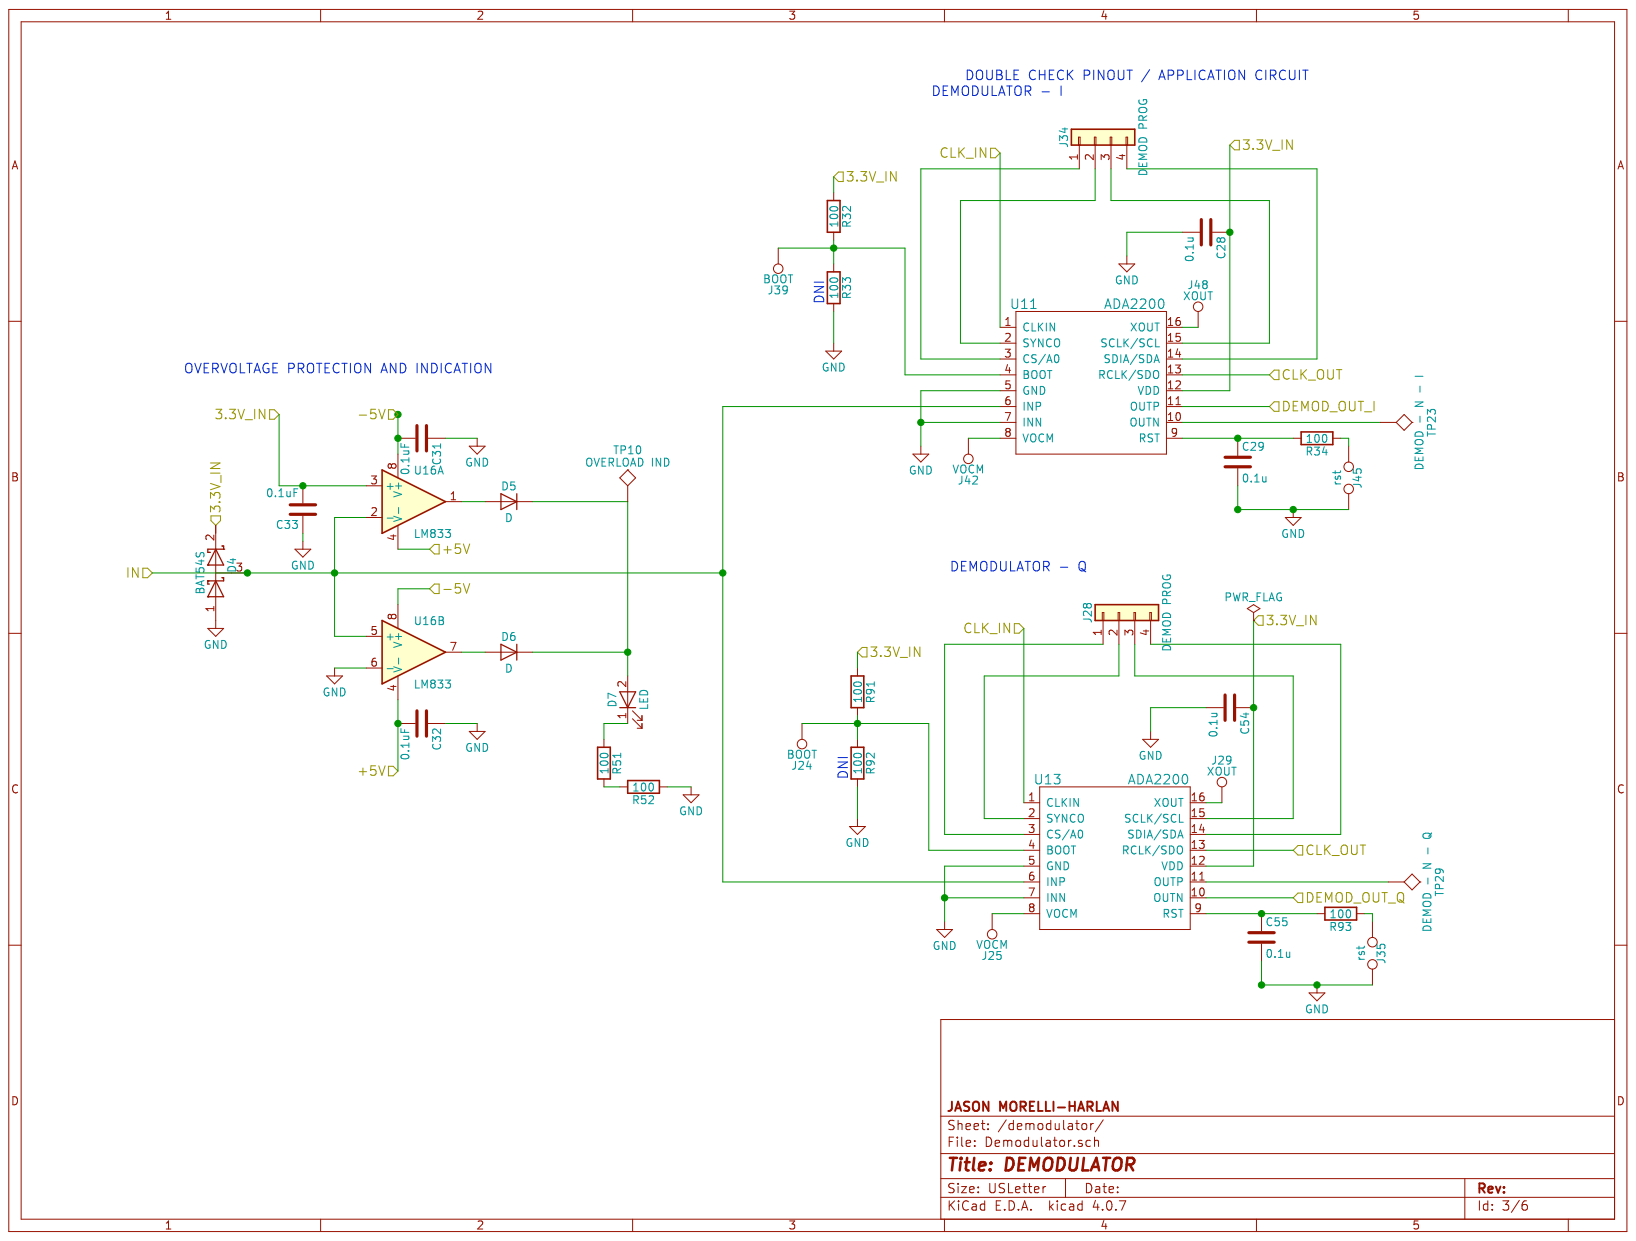
[picture p24: page 3]

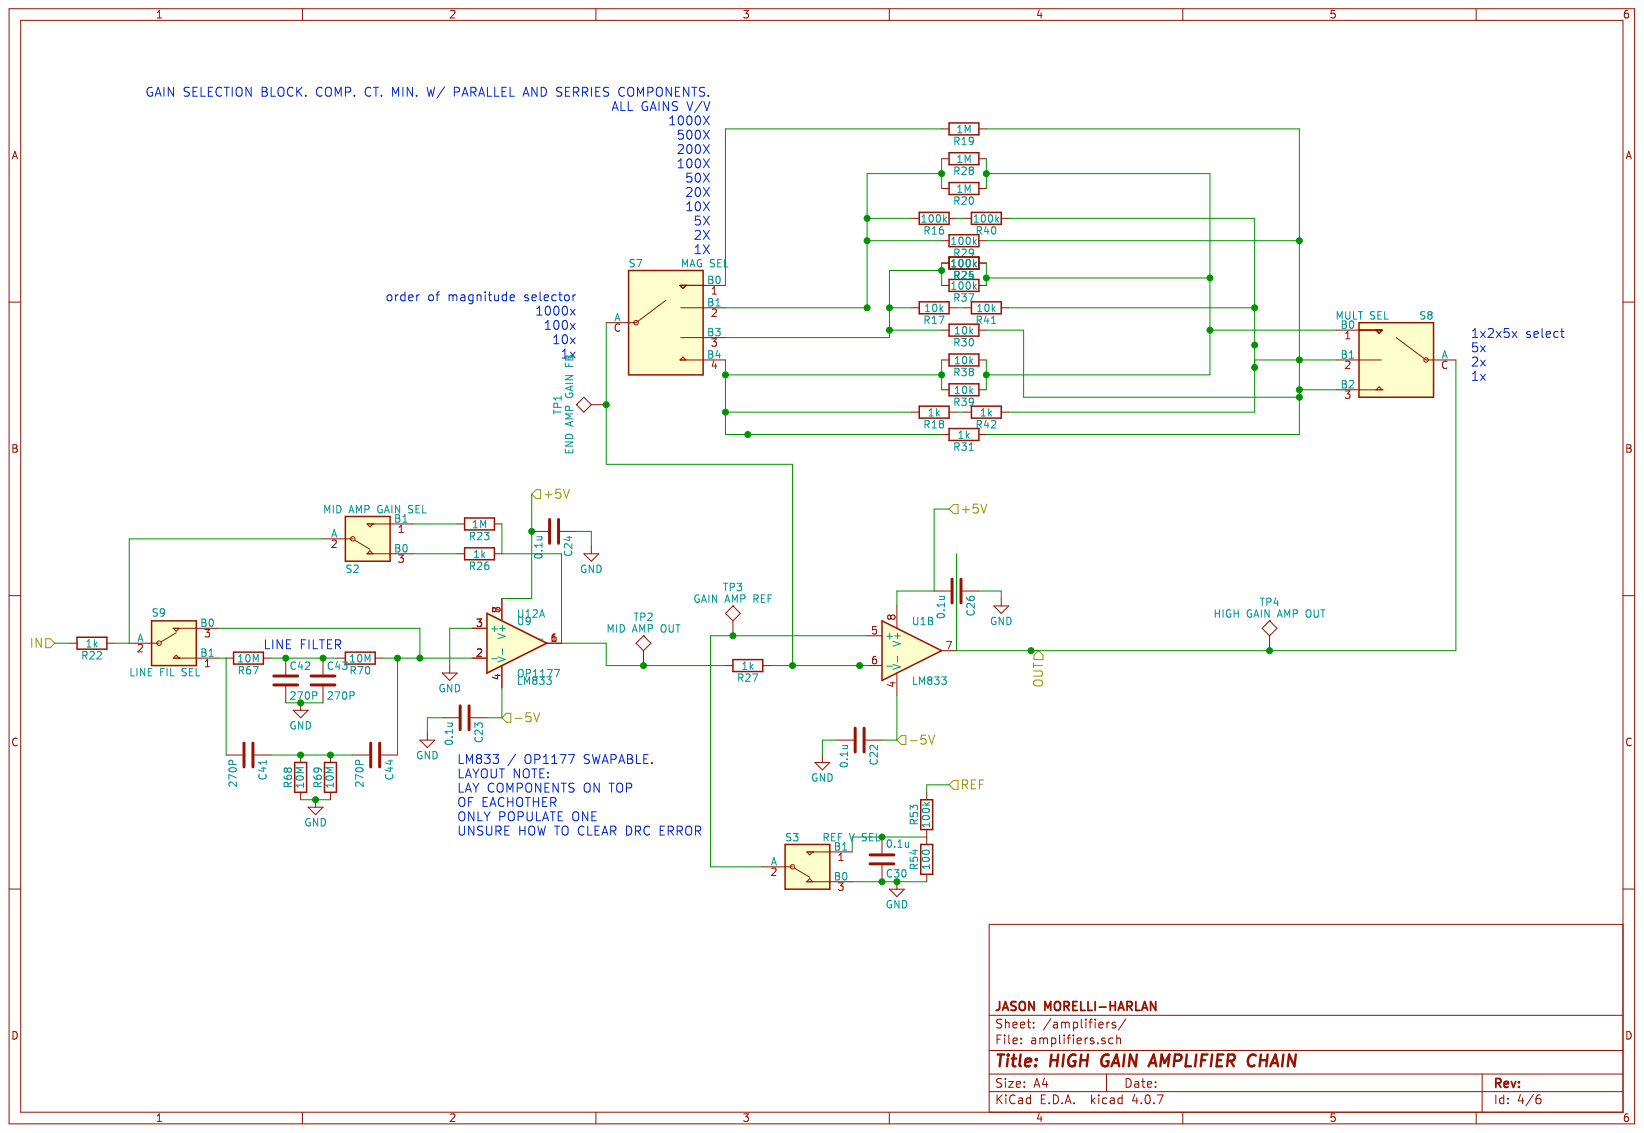
[picture p25: page 4]

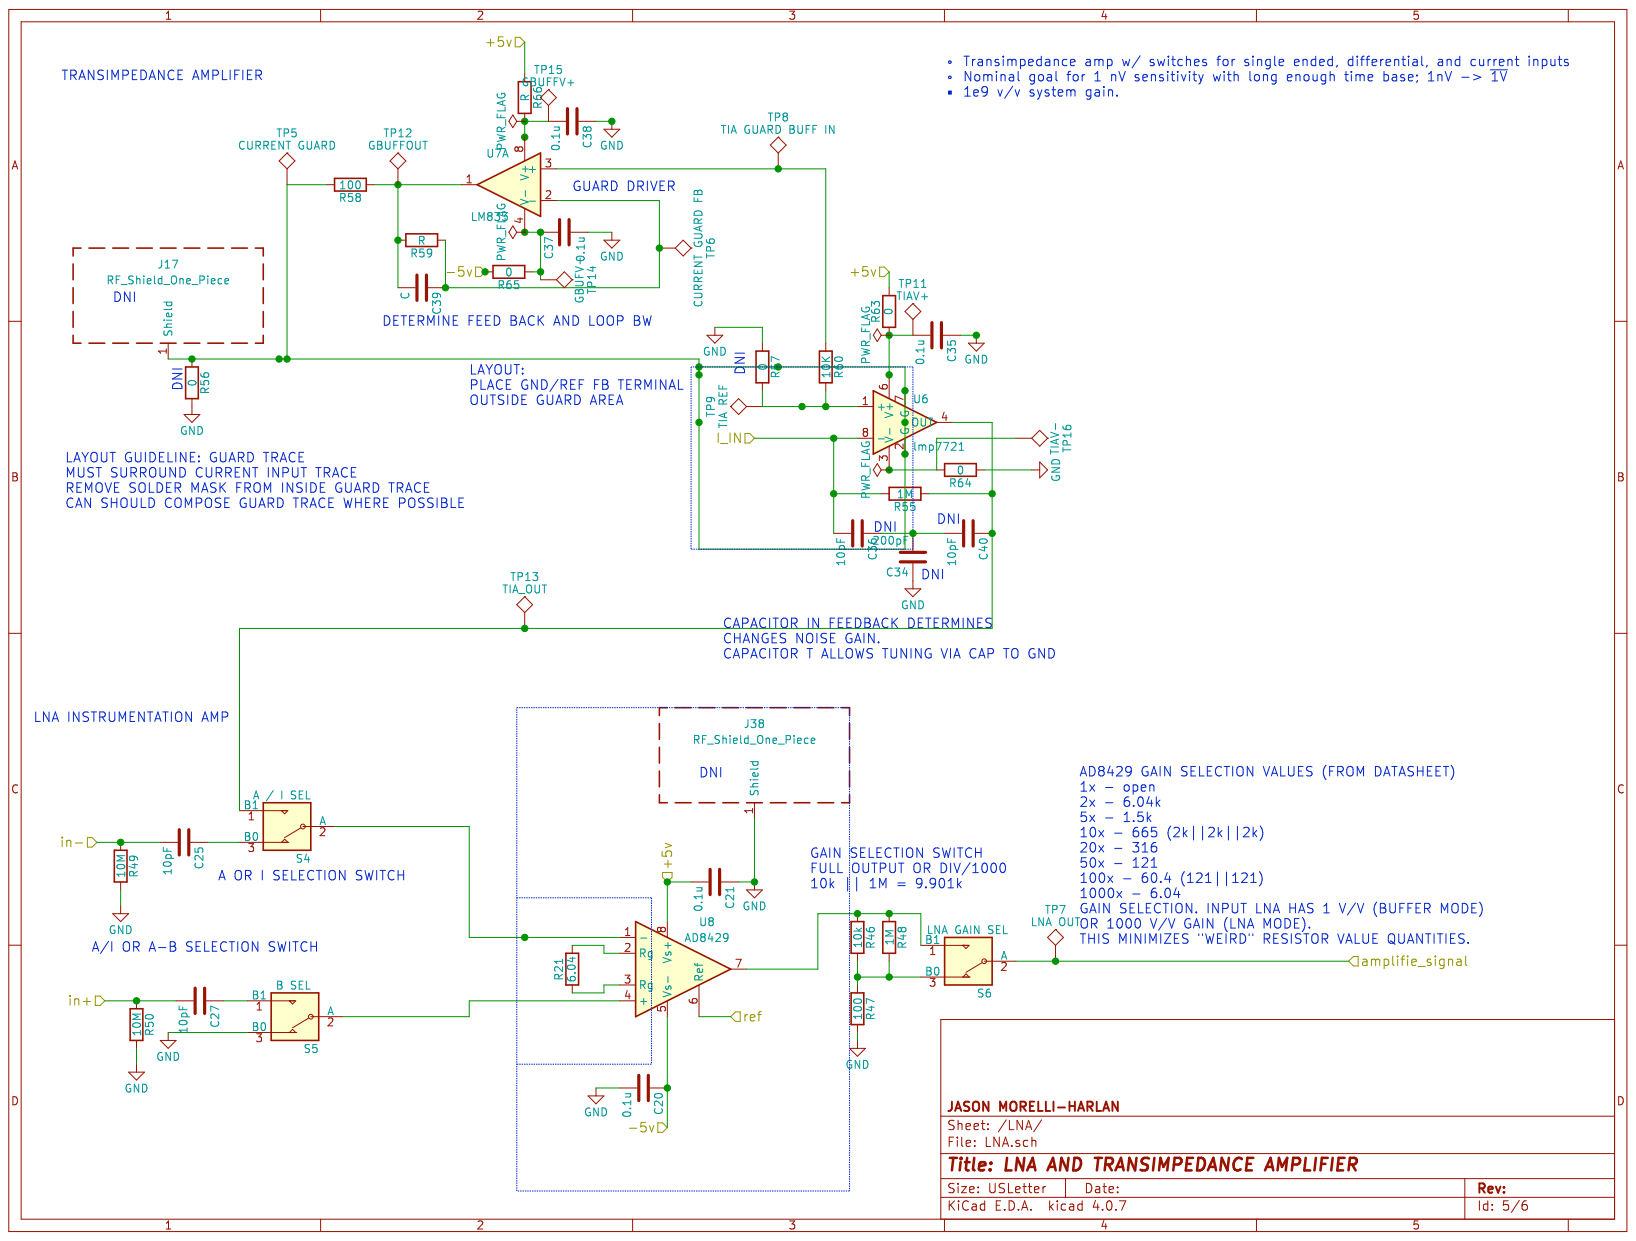
[picture p26: page 5]

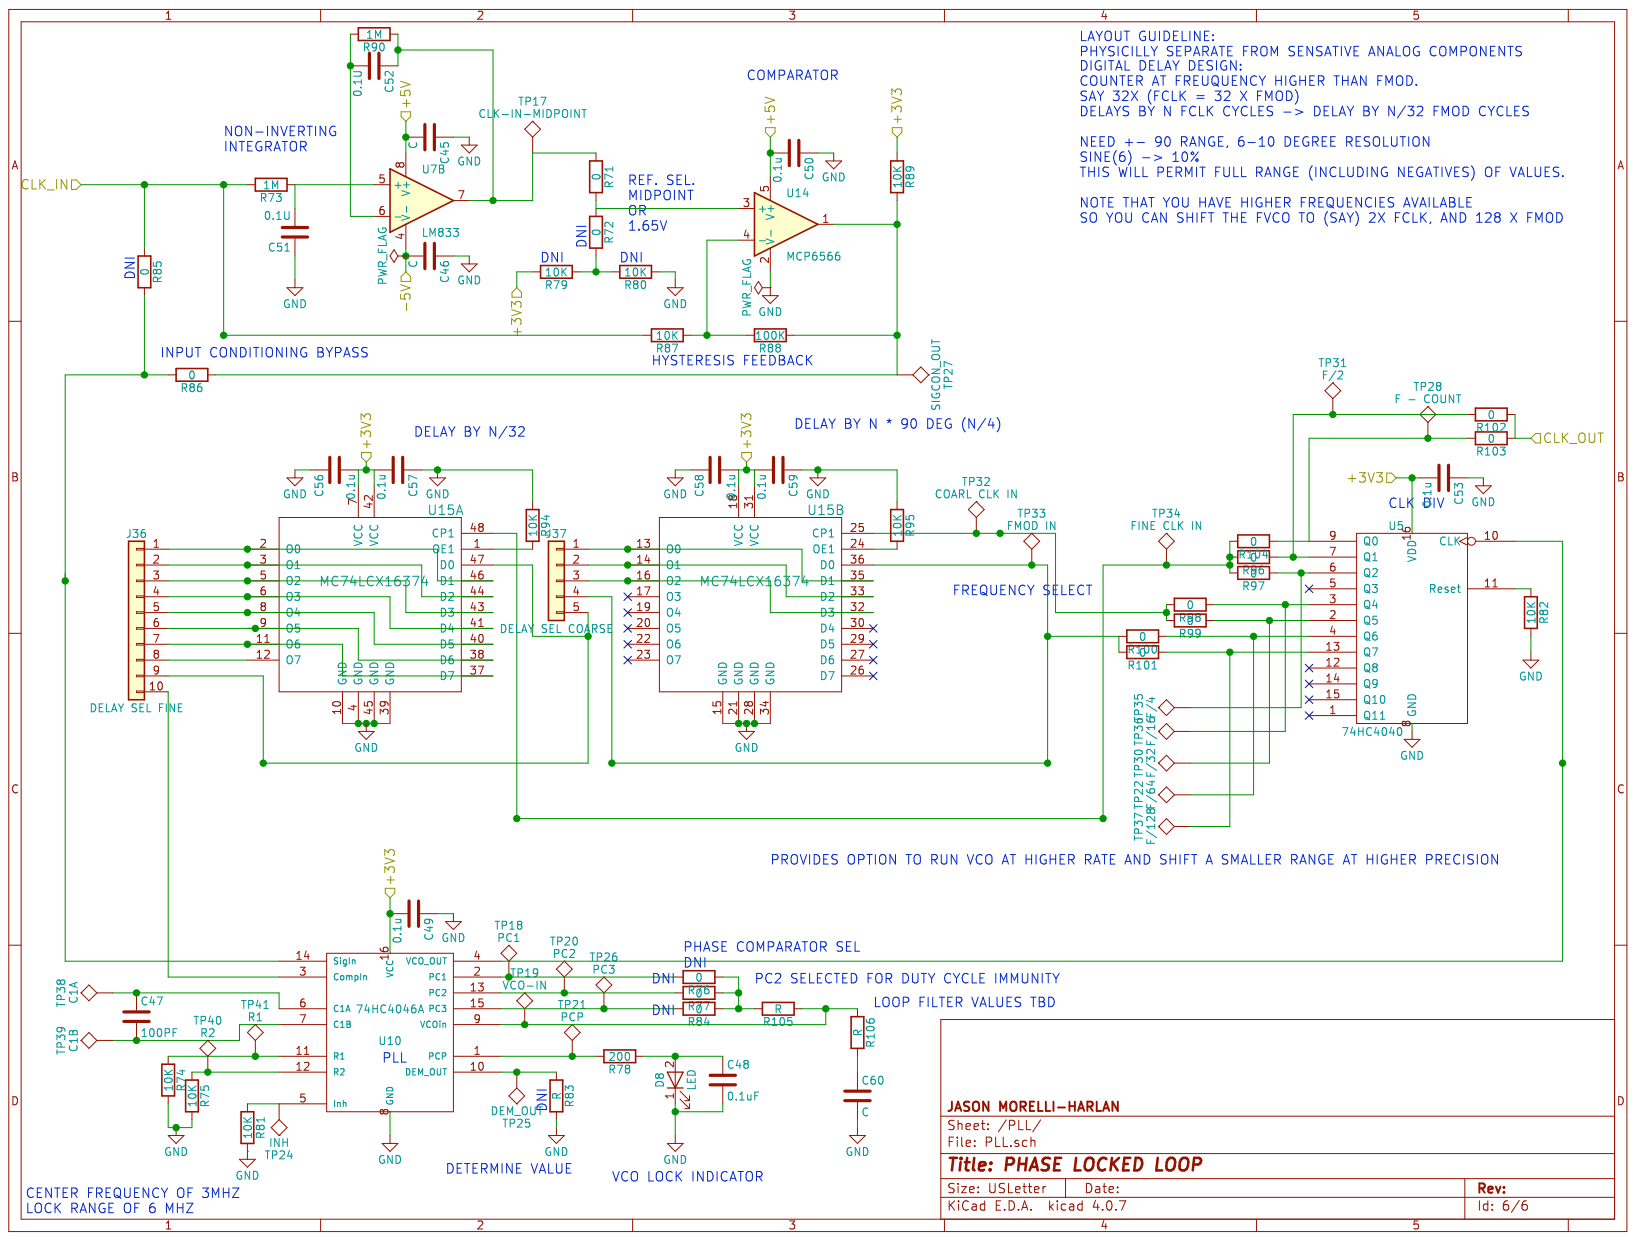
[picture p27: page 6]
