JasMoH/Photoacoustic/lock_in_amplifier/spice/integrating_schmidt.asc

C1: cap; 0.1µ
C2: cap; 0.1µ
R1: res; 1meg
R2: res; 1meg
R3: res; 10K
U1: OP07
U4: OP07
V1: voltage; -5
V2: voltage; 5
V3: voltage; 15
V4: voltage; -15
V5: voltage; 1
V6: voltage; SINE(0 1 {F})
V7: voltage; SINE(0 .33 300)
V8: voltage; SINE(0 0.5 500)
Named nets: +5, -5, 0, +15, -15, VOUT, vin
supply rails
.TRAN 0.1 0.2 0.1
.param f=100
