JasMoH/Photoacoustic/lock_in_amplifier/spice/line_Filter.asc

C1: cap; 540p
C2: cap; 270p
C3: cap; 270p
R1: res; 10K
R2: res; 10meg
R3: res; 10meg
R4: res; 5meg
R5: res; 1meg
R6: res; 1k
R7: res; {r}
R8: res; {r2}
U1: OP07
V1: voltage; -5
V2: voltage; 5
V3: voltage; 15
V4: voltage; -15
V6: voltage; ac 1
Named nets: +5, -5, 0, +15, -15, VOUT, vin
supply rails
.ac dec 1k 1 100k
.step param r list 1e-10 1e30
.step param r2 list 1e-10 1e30
