JasMoH/Photoacoustic/lock_in_amplifier/spice/PLL_CONDITIONING.asc

C1: cap; 0.1µ
C2: cap; 0.1µ
D1: diode; 1N4148
D2: diode; 1N4148
R1: res; 1MEG
R2: res; 1MEG
R3: res; 10K
R4: res; 10meg
R5: res; 10meg
U1: OP07
U2: OP07
U3: OP07
U4: OP07
U5: OP07
V1: voltage; -5
V2: voltage; 5
V3: voltage; 15
V4: voltage; -15
V5: voltage; 0.5
V6: voltage; SINE(0 1 {F})
V7: voltage; SINE(0 .33 3*{F})
V8: voltage; SINE(0 0.2 5*{F})
Named nets: +5, -5, 0, +15, -15, VMID, VPH, VPL, VIN, VOUT
supply rails
.TRAN 0.1 0.15 0.1
.param f=100
