JasMoH/Photoacoustic/lock_in_amplifier/spice/power_pi.asc

C1: cap; 0.1µ
C2: cap; 0.1µ
C3: cap; 100µ
L1: ind; 10µ
R1: res; 100
R2: res; 1
U1: LT1086-5
V1: voltage; ac 1
V2: voltage; 8
Named nets: 0
.ac dec 1k 1 100Meg
