JasMoH/Photoacoustic/lock_in_amplifier/SWITCHTEST/SWTEST.kicad_pcb

## KiCad design lock_in_amplifier/SWITCHTEST/SWTEST.kicad_pcb (2018-01-04)

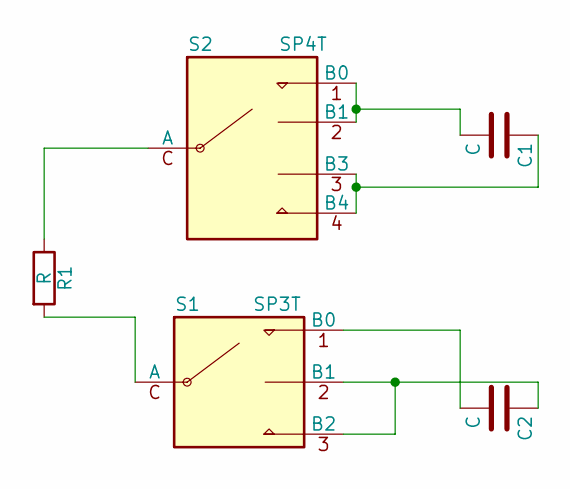
[picture p28: schematic SWTEST.sch]

Parts:
C1, C2: C; C_0201
R1: R; R_0201
S1: SP3T; SP3T_CK_SS-14D0839-VG
S2: SP4T; SP4T_C&K_SS-14D0839-VG

Connections:
unnamed: C1.1, S2.3 (B3), S2.4 (B4)
unnamed: C1.2, S2.1 (B0), S2.2 (B1)
unnamed: C2.1, S1.2 (B1), S1.3 (B2)
unnamed: C2.2, S1.1 (B0)
unnamed: R1.1, S2.C (A)
unnamed: R1.2, S1.C (A)

Board: 2 copper layers, 5 parts (0 on the bottom side), 6 nets, no tracks yet.
