JasMoH/Photoacoustic/lock_in_amplifier/LNA_test/LNA_test.kicad_pcb

## KiCad design lock_in_amplifier/LNA_test/LNA_test.kicad_pcb (2018-01-04)

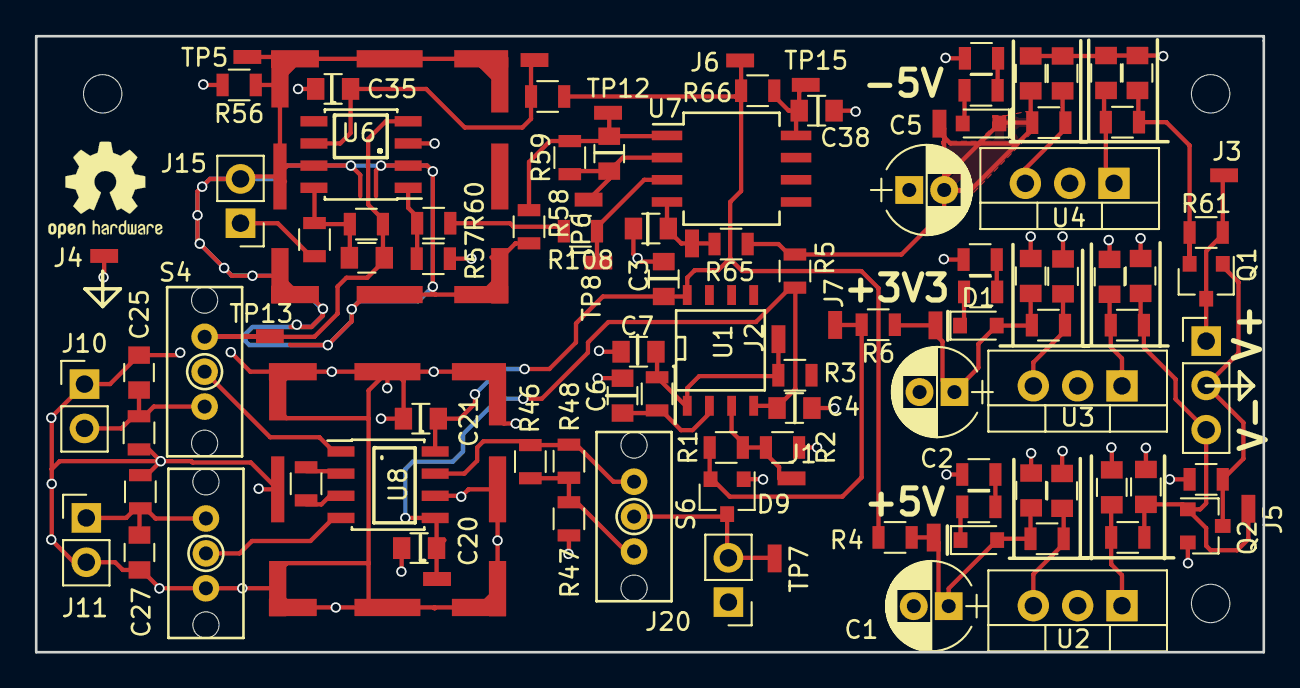
[picture p29: board LNA_test.kicad_pcb from above]

Board: 2 copper layers, 70.4 x 35.3 mm, 109 parts (0 on the bottom side), 44 nets.

Parts:
C1, C2, C5: 10u; CP_Radial_D5.0mm_P2.00mm
C3, C4, C20, C21, C35, C37, C38: 0.1u; C_0805
C6, C7, C8, C9, C10, C11, C12, C13, C14, C15, C16, C17, C18, C19: 0.1uF; C_0805
C25, C27, C36: 10pF; C_0805
C39: C; C_0805
D1, D2, D3: LED; D_0805
D9: BAT54S; SOT-23
J1: vref-in; tyco_RCU_0603_Probe_Pad
J2: vref; tyco_RCU_0603_Probe_Pad
J3: V-IN; tyco_RCU_0603_Probe_Pad
J4: GND; tyco_RCU_0603_Probe_Pad
J5: V+IN; tyco_RCU_0603_Probe_Pad
J6: +5V; tyco_RCU_0603_Probe_Pad
J7: +3V3; tyco_RCU_0603_Probe_Pad
J8: -5V; tyco_RCU_0603_Probe_Pad
J10: A IN; Pin_Header_Straight_1x02_Pitch2.54mm
J11: B IN; Pin_Header_Straight_1x02_Pitch2.54mm
J12: POWER_IN; Pin_Header_Straight_1x03_Pitch2.54mm
J15: I IN; Pin_Header_Straight_1x02_Pitch2.54mm
J17, J38: RF_Shield_One_Piece; SMS-201
J19: +3V3 OUT; tyco_RCU_0603_Probe_Pad
J20: AMP OUT; Pin_Header_Straight_1x02_Pitch2.54mm
J46: -5V OUT; tyco_RCU_0603_Probe_Pad
J47: +5V OUT; tyco_RCU_0603_Probe_Pad
L1, L2, L3, L4, L5, L6, L7: 10uH; L_0805
Q1, Q2: DMN640L; SOT-23
R1, R2, R60: 10K; R_0805
R3, R4, R5, R6, R56, R57, R61, R62, R63, R65, R108: 0; R_0805
R7, R8, R9, R43, R44, R45, R47, R58, R64: 100; R_0805
R21: 6.04; R_0805
R46: 10k; R_0805
R48: 1M; R_0805
R49, R50: 10M; R_0805
R55: 100M; R_0805
R59, R66: R; R_0805
S4: A / I SEL; SPDT_OS102011MS2QN1
S5: B SEL; SPDT_OS102011MS2QN1
S6: LNA GAIN SEL; SPDT_OS102011MS2QN1
TP5: CURRENT GUARD; tyco_RCU_0603_Probe_Pad
TP6: CURRENT GUARD FB; tyco_RCU_0603_Probe_Pad
TP7: LNA OUT; tyco_RCU_0603_Probe_Pad
TP8: TIA GUARD BUFF IN; tyco_RCU_0603_Probe_Pad
TP11: TIAV+; tyco_RCU_0603_Probe_Pad
TP12: GBUFFOUT; tyco_RCU_0603_Probe_Pad
TP13: TIA_OUT; tyco_RCU_0603_Probe_Pad
TP14: GBUFV-; tyco_RCU_0603_Probe_Pad
TP15: GBUFFV+; tyco_RCU_0603_Probe_Pad
U1: LM833; SOIC-8-N
U2: lm7805; TO-220-3_Vertical
U3: LM7833; TO-220-3_Vertical
U4: lm7905; TO-220-3_Vertical
U6: lmp7721; SOIC-8_3.9x4.9mm_Pitch1.27mm
U7: LM833; SO-8_5.3x6.2mm_Pitch1.27mm
U8: AD8429; SOIC-8_3.9x4.9mm_Pitch1.27mm

Connections:
+3V3: C2.1, C18.1, D1.2, D9.2, J7.1, J19.1, L6.2, R1.1, R6.1, R6.2
+5V: C1.1, C3.2, C19.1, C21.2, D3.2, J6.1, J47.1, L7.2, R4.1, R4.2, R63.2, R66.1, U1.8, U8.8
-5V: C4.2, C5.2, C17.1, C20.1, D2.1, J8.1, J46.1, L5.2, R5.1, R5.2, R65.2, U1.4, U8.5
/sheet5A330121/GND_IN: J12.2, Q1.1, Q2.3, R62.2
/sheet5A330121/V+_IN: C8.1, C9.1, J5.1, J12.3, L2.1, L3.2, Q2.1
/sheet5A330121/V-_IN: J3.1, J12.1, Q1.3, R61.2
/sheet5A330123/GUARD: J15.2, J17.1, R56.1, R58.2, TP5.1, U6.2, U6.7
/sheet5A330123/I_IN: J15.1, R64.2
/sheet5A330123/amplifie_signal: D9.3, J20.2, S6.2, TP7.1
/sheet5A330123/in+: C27.2, J11.1, R50.1, S5.1
/sheet5A330123/in-: C25.2, J10.2, R49.1, S4.3
GND: C1.2, C2.2, C3.1, C4.1, C5.1, C6.2, C7.2, C8.2, C9.2, C10.2, C11.2, C12.2, C13.2, C14.2, C15.2, C16.2, C17.2, C18.2, C19.2, C20.2, C21.1, C25.1, C27.1, C35.1, C37.2, C38.1, D9.1, J4.1, J10.1, J11.2, J20.1, J38.1, Q2.2, R2.2, R8.2, R43.2, R45.2, R47.2, R49.2, R50.2, R56.2, R57.1, R62.1, S5.3, U2.2, U3.2, U4.2, U6.3, U8.6
unnamed: C6.1, L1.2, U1.2
unnamed: C7.1, J2.1, L1.1, R3.2, U1.1
unnamed: C10.1, L4.2, Q1.2, R61.1
unnamed: C11.1, L2.2, U2.1
unnamed: C12.1, L3.1, U3.1
unnamed: C13.1, L4.1, U4.1
unnamed: C14.1, L5.1, U4.3
unnamed: C15.1, L6.1, U3.3
unnamed: C16.1, L7.1, U2.3
unnamed: C35.2, R63.1, TP11.1, U6.6
unnamed: C36.1, R55.1, S4.1, TP13.1, U6.4
unnamed: C36.2, R55.2, R64.1, U6.8
unnamed: C37.1, R65.1, TP14.1, U7.4
unnamed: C38.2, R66.2, TP15.1, U7.8
unnamed: C39.1, R59.1, TP6.1, U7.2
unnamed: C39.2, R58.1, R59.2, TP12.1, U7.1
unnamed: D1.1, R44.1
unnamed: D2.2, R7.1
unnamed: D3.1, R9.1
unnamed: J1.1, R1.2, R2.1, U1.3
unnamed: R7.2, R8.1
unnamed: R21.1, U8.3
unnamed: R21.2, U8.2
unnamed: R9.2, R43.1
unnamed: R44.2, R45.1
unnamed: R46.1, R48.1, S6.1, U8.7
unnamed: R46.2, R47.1, R48.2, S6.3
unnamed: R57.2, R60.2, U6.1
unnamed: R108.1, TP8.1, U7.3
unnamed: R60.1, R108.2
unnamed: S4.2, U8.1
unnamed: S5.2, U8.4
