JasMoH/Photoacoustic/lock_in_amplifier/pll_test/pll_test.kicad_pcb

## KiCad design lock_in_amplifier/pll_test/pll_test.kicad_pcb (2018-01-04)

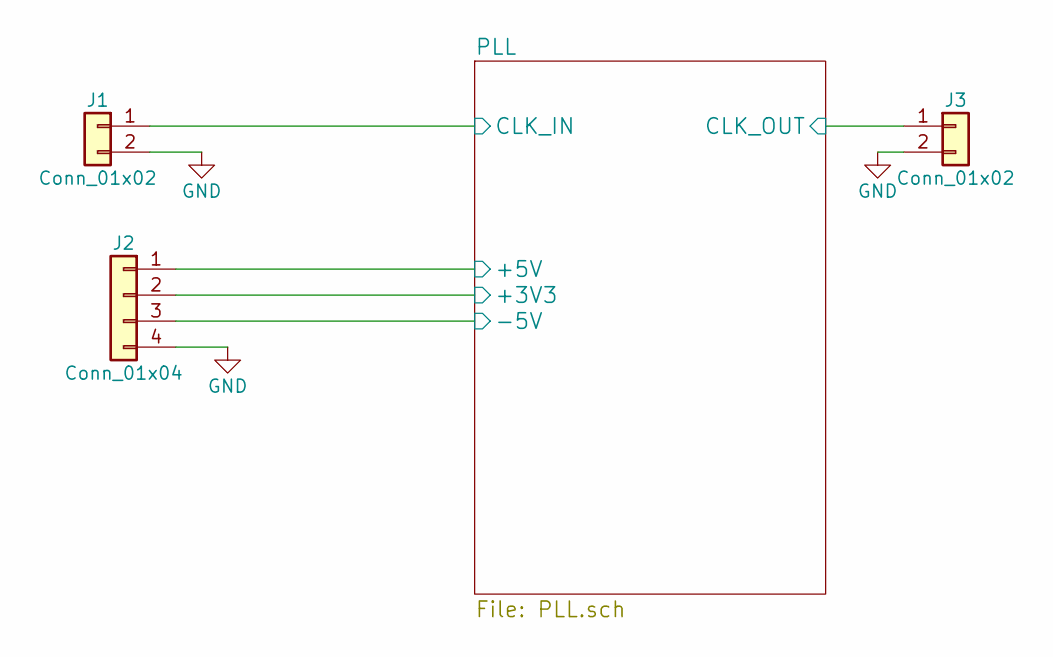
[picture p30: schematic pll_test.sch]

Parts:
J1, J3: Conn_01x02; Pin_Header_Straight_1x02_Pitch2.54mm
J2: Conn_01x04; Pin_Header_Straight_1x04_Pitch2.54mm

Connections:
/PLL/+3V3: J2.2; also elsewhere on the board
/PLL/+5V: J2.1; also elsewhere on the board
/PLL/-5V: J2.3; also elsewhere on the board
/PLL/CLK_IN: J1.1; also elsewhere on the board
/PLL/CLK_OUT: J3.1; also elsewhere on the board
GND: J1.2, J2.4, J3.2; also elsewhere on the board

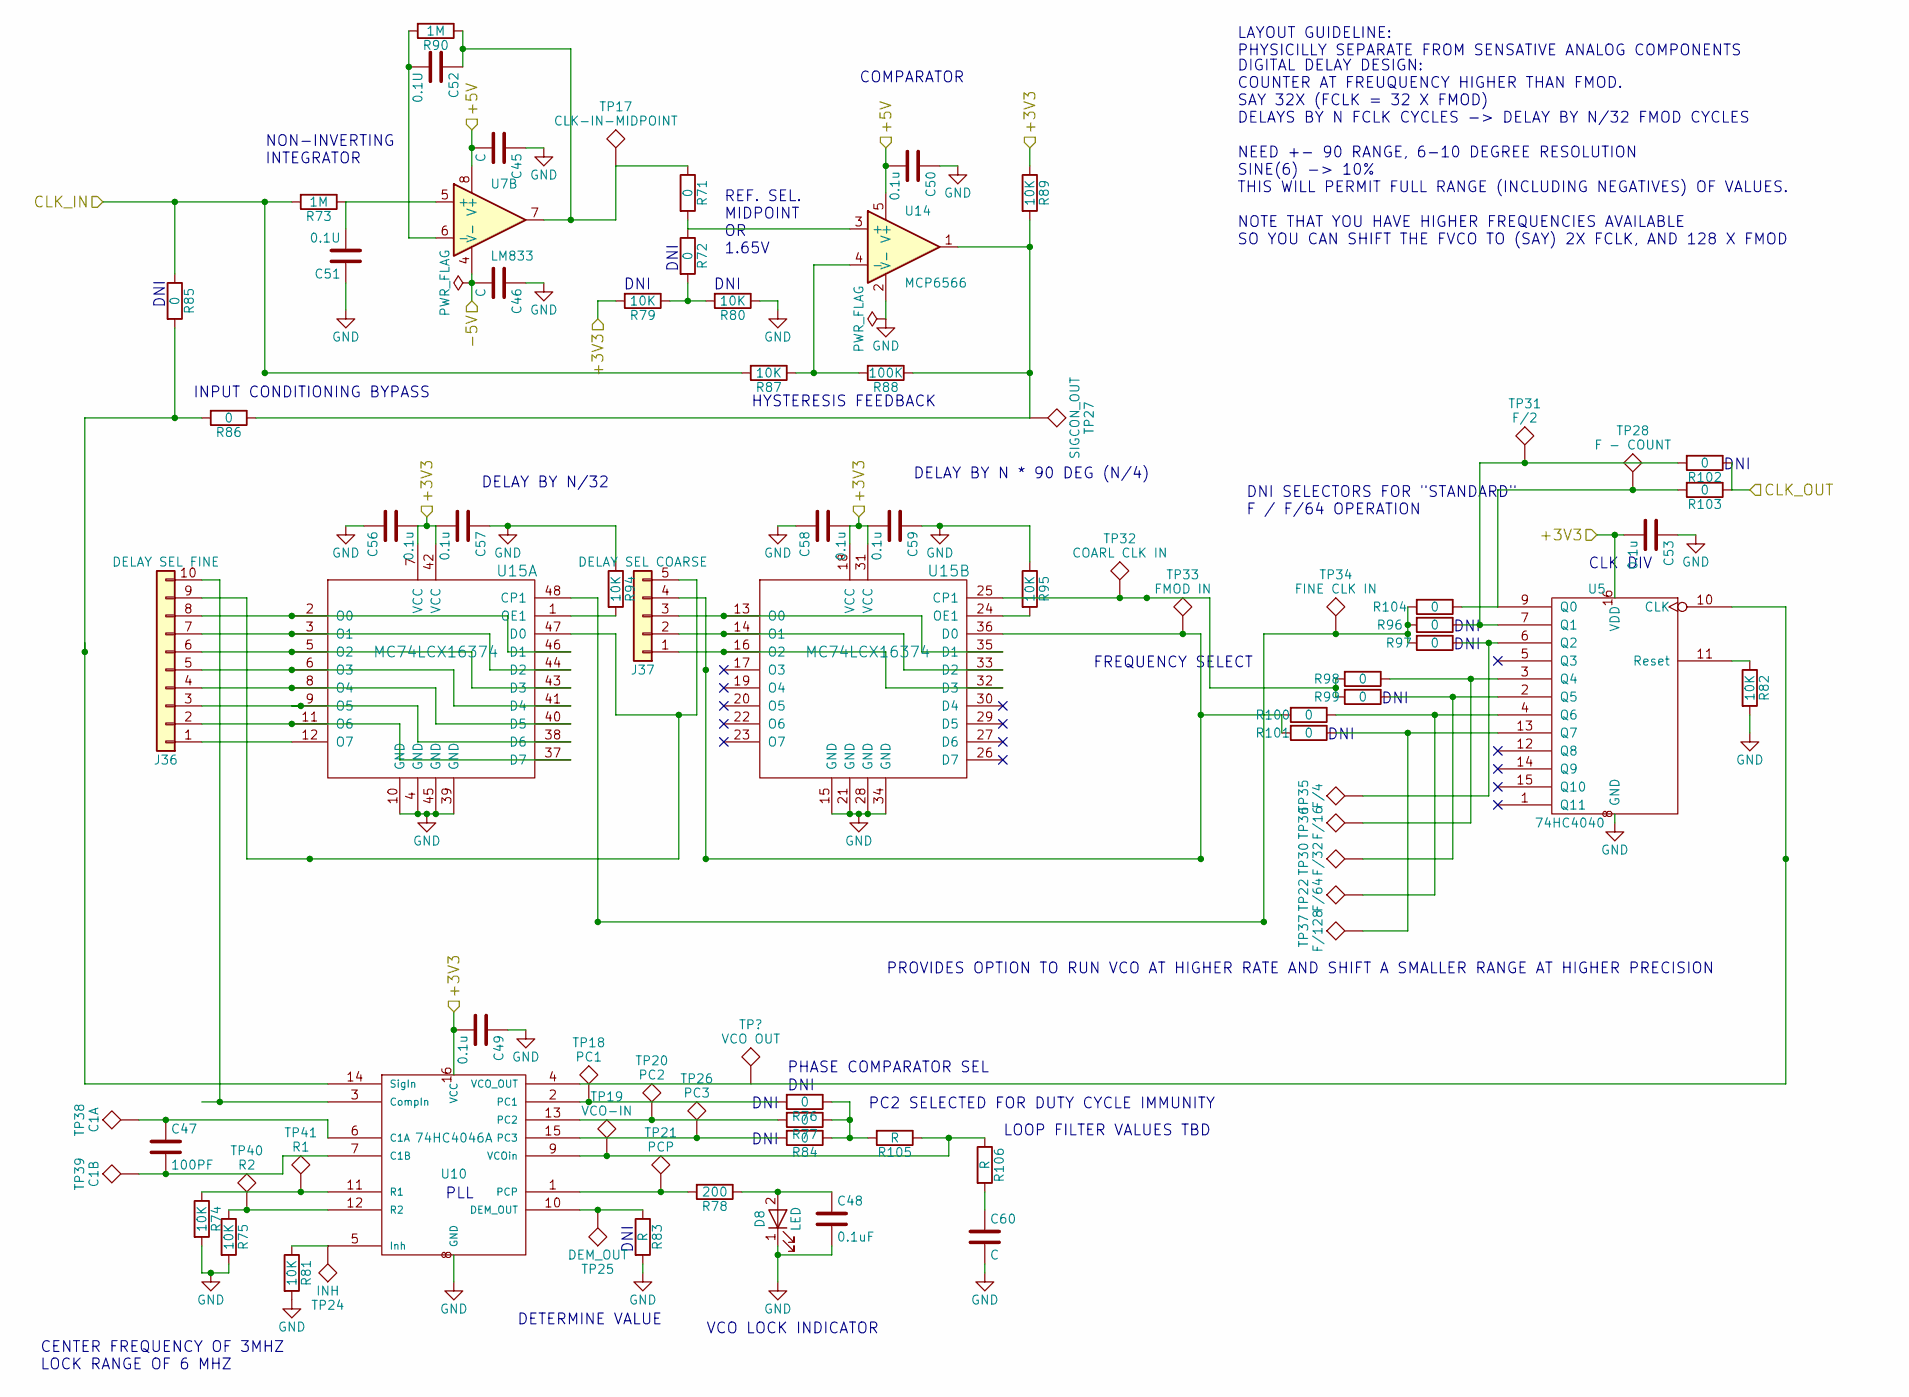
[picture p31: schematic PLL.sch, PHASE LOCKED LOOP]

Parts:
C45, C46, C60: C; C_0805
C47: 100PF; C_0805
C48: 0.1uF; C_0805
C49, C50, C53, C56, C57, C58, C59: 0.1u; C_0805
C51, C52: 0.1U; C_0805
D8: LED; LED_0805
J36: DELAY SEL FINE; Pin_Header_Straight_1x10_Pitch2.54mm
J37: DELAY SEL COARSE; Pin_Header_Straight_1x05_Pitch2.54mm
R71, R72, R76, R77, R84, R85, R86, R96, R97, R98, R99, R100, R101, R102, R103, R104: 0; R_0805
R73, R90: 1M; R_0805
R74, R75, R79, R80, R81, R82, R87, R89, R94, R95: 10K; R_0805
R78: 200; R_0805
R83, R105, R106: R; R_0805
R88: 100K; R_0805
TP17: CLK-IN-MIDPOINT; tyco_RCU_0603_Probe_Pad
TP18: PC1; tyco_RCU_0603_Probe_Pad
TP19: VCO-IN; tyco_RCU_0603_Probe_Pad
TP20: PC2; tyco_RCU_0603_Probe_Pad
TP21: PCP; tyco_RCU_0603_Probe_Pad
TP22: F/64; tyco_RCU_0603_Probe_Pad
TP24: INH; tyco_RCU_0603_Probe_Pad
TP25: DEM_OUT; tyco_RCU_0603_Probe_Pad
TP26: PC3; tyco_RCU_0603_Probe_Pad
TP27: SIGCON_OUT; tyco_RCU_0603_Probe_Pad
TP28: F - COUNT; tyco_RCU_0603_Probe_Pad
TP30: F/32; tyco_RCU_0603_Probe_Pad
TP31: F/2; tyco_RCU_0603_Probe_Pad
TP32: COARL CLK IN; tyco_RCU_0603_Probe_Pad
TP33: FMOD IN; tyco_RCU_0603_Probe_Pad
TP34: FINE CLK IN; tyco_RCU_0603_Probe_Pad
TP35: F/4; tyco_RCU_0603_Probe_Pad
TP36: F/16; tyco_RCU_0603_Probe_Pad
TP37: F/128; tyco_RCU_0603_Probe_Pad
TP38: C1A; tyco_RCU_0603_Probe_Pad
TP39: C1B; tyco_RCU_0603_Probe_Pad
TP40: R2; tyco_RCU_0603_Probe_Pad
TP41: R1; tyco_RCU_0603_Probe_Pad
U5: 74HC4040; TSSOP-16_4.4x5mm_Pitch0.65mm
U7: LM833; SOIC-8_3.9x4.9mm_Pitch1.27mm
U10: 74HC4046A; SOIC-16_3.9x9.9mm_Pitch1.27mm
U14: MCP6566; SOT-23-5
U15: MC74LCX16374; TSSOP-48_6.1x12.5mm_Pitch0.5mm

Connections:
/PLL/+3V3: C49.2, C53.2, C56.2, C57.2, C58.2, C59.2, R79.2, R89.1, U5.16 (VDD), U10.16 (VCC), U15.7 (VCC), U15.18 (VCC), U15.31 (VCC), U15.42 (VCC); also elsewhere on the board
/PLL/+5V: C45.2, C50.2, U7.8 (V+), U14.5 (V+); also elsewhere on the board
/PLL/-5V: C46.2, U7.4 (V-); also elsewhere on the board
/PLL/CLK_IN: R73.2, R85.1, R87.2; also elsewhere on the board
/PLL/CLK_OUT: R102.1, R103.1; also elsewhere on the board
GND: C45.1, C46.1, C48.2, C49.1, C50.1, C51.1, C53.1, C56.1, C57.1, C58.1, C59.1, C60.2, D8.1 (K), R74.2, R75.2, R80.1, R81.2, R82.2, R83.2, R94.1, R95.1, U5.8 (GND), U10.8 (GND), U14.2 (V-), U15.4 (GND), U15.10 (GND), U15.15 (GND), U15.21 (GND), U15.28 (GND), U15.34 (GND), U15.39 (GND), U15.45 (GND); also elsewhere on the board
unnamed: C47.1, TP38.1, U10.6 (C1A)
unnamed: C47.2, TP39.1, U10.7 (C1B)
unnamed: C48.1, D8.2 (A), R78.1
unnamed: C51.2, R73.1, U7.5 (+)
unnamed: C52.1, R71.1, R90.1, TP17.1, U7.7
unnamed: C52.2, R90.2, U7.6 (-)
unnamed: C60.1, R106.2
unnamed: J36.1, U15.12 (O7)
unnamed: J36.2, U15.11 (O6), U15.37 (D7)
unnamed: J36.3, U15.9 (O5), U15.38 (D6)
unnamed: J36.4, U15.8 (O4), U15.40 (D5)
unnamed: J36.5, U15.6 (O3), U15.41 (D4)
unnamed: J36.6, U15.5 (O2), U15.43 (D3)
unnamed: J36.7, U15.3 (O1), U15.44 (D2)
unnamed: J36.8, U15.2 (O0), U15.46 (D1)
unnamed: J36.9, J37.5, U15.47 (D0)
unnamed: J36.10, U10.3 (CompIn)
unnamed: J37.1, U15.16 (O2), U15.32 (D3)
unnamed: J37.2, U15.14 (O1), U15.33 (D2)
unnamed: J37.3, U15.13 (O0), U15.35 (D1)
unnamed: J37.4, R100.2, R101.2, TP33.1, U15.36 (D0)
unnamed: R71.2, R72.1, U14.3 (+)
unnamed: R72.2, R79.1, R80.2
unnamed: R74.1, TP41.1, U10.11 (R1)
unnamed: R75.1, TP40.1, U10.12 (R2)
unnamed: R76.2, TP18.1, U10.2 (PC1)
unnamed: R77.2, TP20.1, U10.13 (PC2)
unnamed: R78.2, TP21.1, U10.1 (PCP)
unnamed: R81.1, TP24.1, U10.5 (Inh)
unnamed: R82.1, U5.11 (Reset)
unnamed: R83.1, TP25.1, U10.10 (DEM_OUT)
unnamed: R84.2, TP26.1, U10.15 (PC3)
unnamed: R85.2, R86.2, U10.14 (SigIn)
unnamed: R86.1, R88.1, R89.2, TP27.1, U14.1
unnamed: R87.1, R88.2, U14.4 (-)
unnamed: R94.2, U15.1 (OE1)
unnamed: R95.2, U15.24 (OE1)
unnamed: R97.1, TP35.1, U5.6 (Q2)
unnamed: R98.1, TP36.1, U5.3 (Q4)
unnamed: R98.2, R99.2, TP32.1, U15.25 (CP1)
unnamed: R99.1, TP30.1, U5.2 (Q5)
unnamed: R100.1, TP22.1, U5.4 (Q6)
unnamed: R101.1, TP37.1, U5.13 (Q7)
unnamed: R96.1, R102.2, TP31.1, U5.7 (Q1)
unnamed: R103.2, R104.1, TP28.1, U5.9 (Q0)
unnamed: R96.2, R97.2, R104.2, TP34.1, U15.48 (CP1)
unnamed: R105.1, R106.1, TP19.1, U10.9 (VCOin)
unnamed: R76.1, R77.1, R84.1, R105.2
unnamed: U5.10 (CLK), U10.4 (VCO_OUT)

Notes on the sheet:
PLL
CLK DIV
LAYOUT GUIDELINE: PHYSICILLY SEPARATE FROM SENSATIVE ANALOG COMPONENTS
NON-INVERTING INTEGRATOR
COMPARATOR
REF. SEL. MIDPOINT OR 1.65V
FREQUENCY SELECT
DNI
PHASE COMPARATOR SEL
VCO LOCK INDICATOR
DETERMINE VALUE
INPUT CONDITIONING BYPASS
HYSTERESIS FEEDBACK
DIGITAL DELAY DESIGN: COUNTER AT FREUQUENCY HIGHER THAN FMOD. SAY 32X (FCLK = 32 X FMOD) DELAYS BY N FCLK CYCLES -> DELAY BY N/32 FMOD CYCLES NEED +- 90 RANGE, 6-10 DEGREE RESOLUTION SINE(6) -> 10% THIS WILL PERMIT FULL RANGE (INCLUDING NEGATIVES) OF VALUES. NOTE THAT YOU HAVE HIGHER FREQUENCIES AV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
DELAY BY N * 90 DEG (N/4)
DELAY BY N/32
PROVIDES OPTION TO RUN VCO AT HIGHER RATE AND SHIFT A SMALLER RANGE AT HIGHER PRECISION
CENTER FREQUENCY OF 3MHZ LOCK RANGE OF 6 MHZ
PC2 SELECTED FOR DUTY CYCLE IMMUNITY
LOOP FILTER VALUES TBD
DNI SELECTORS FOR "STANDARD" F / F/64 OPERATION

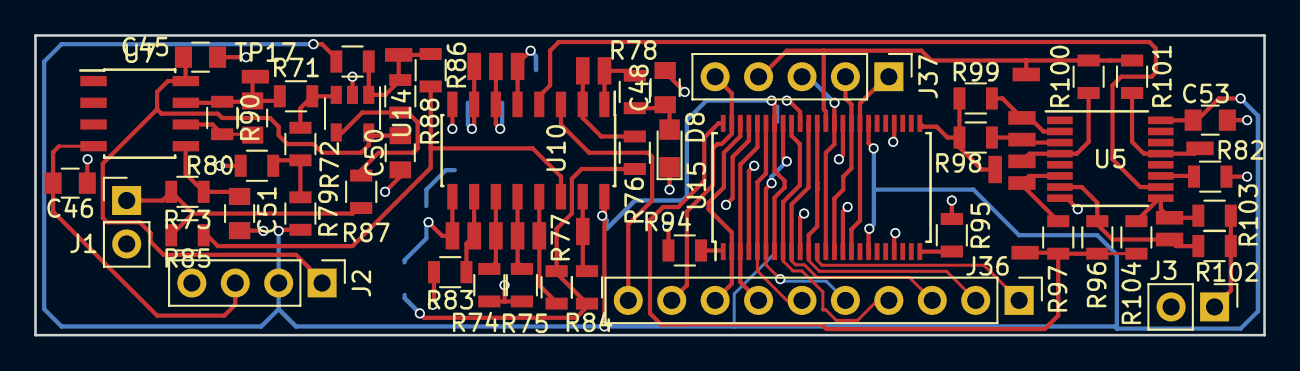
[picture p32: board pll_test.kicad_pcb from above]

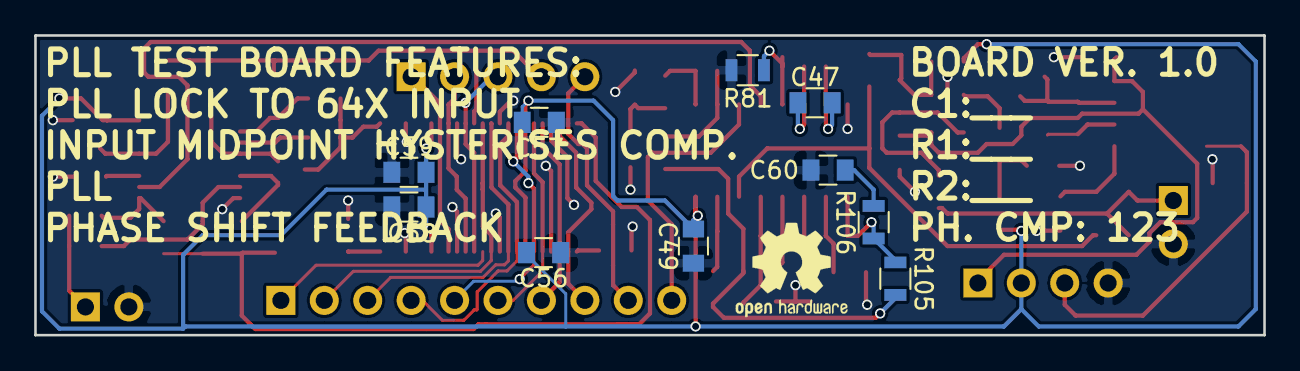
[picture p33: board pll_test.kicad_pcb from below]

Board: 2 copper layers, 71.9 x 17.5 mm, 81 parts (10 on the bottom side), 55 nets.
