JasMoH/Photoacoustic/lock_in_amplifier/LIA_Build/LIA.kicad_pcb

## KiCad design lock_in_amplifier/LIA_Build/LIA.kicad_pcb (2017-12-15)

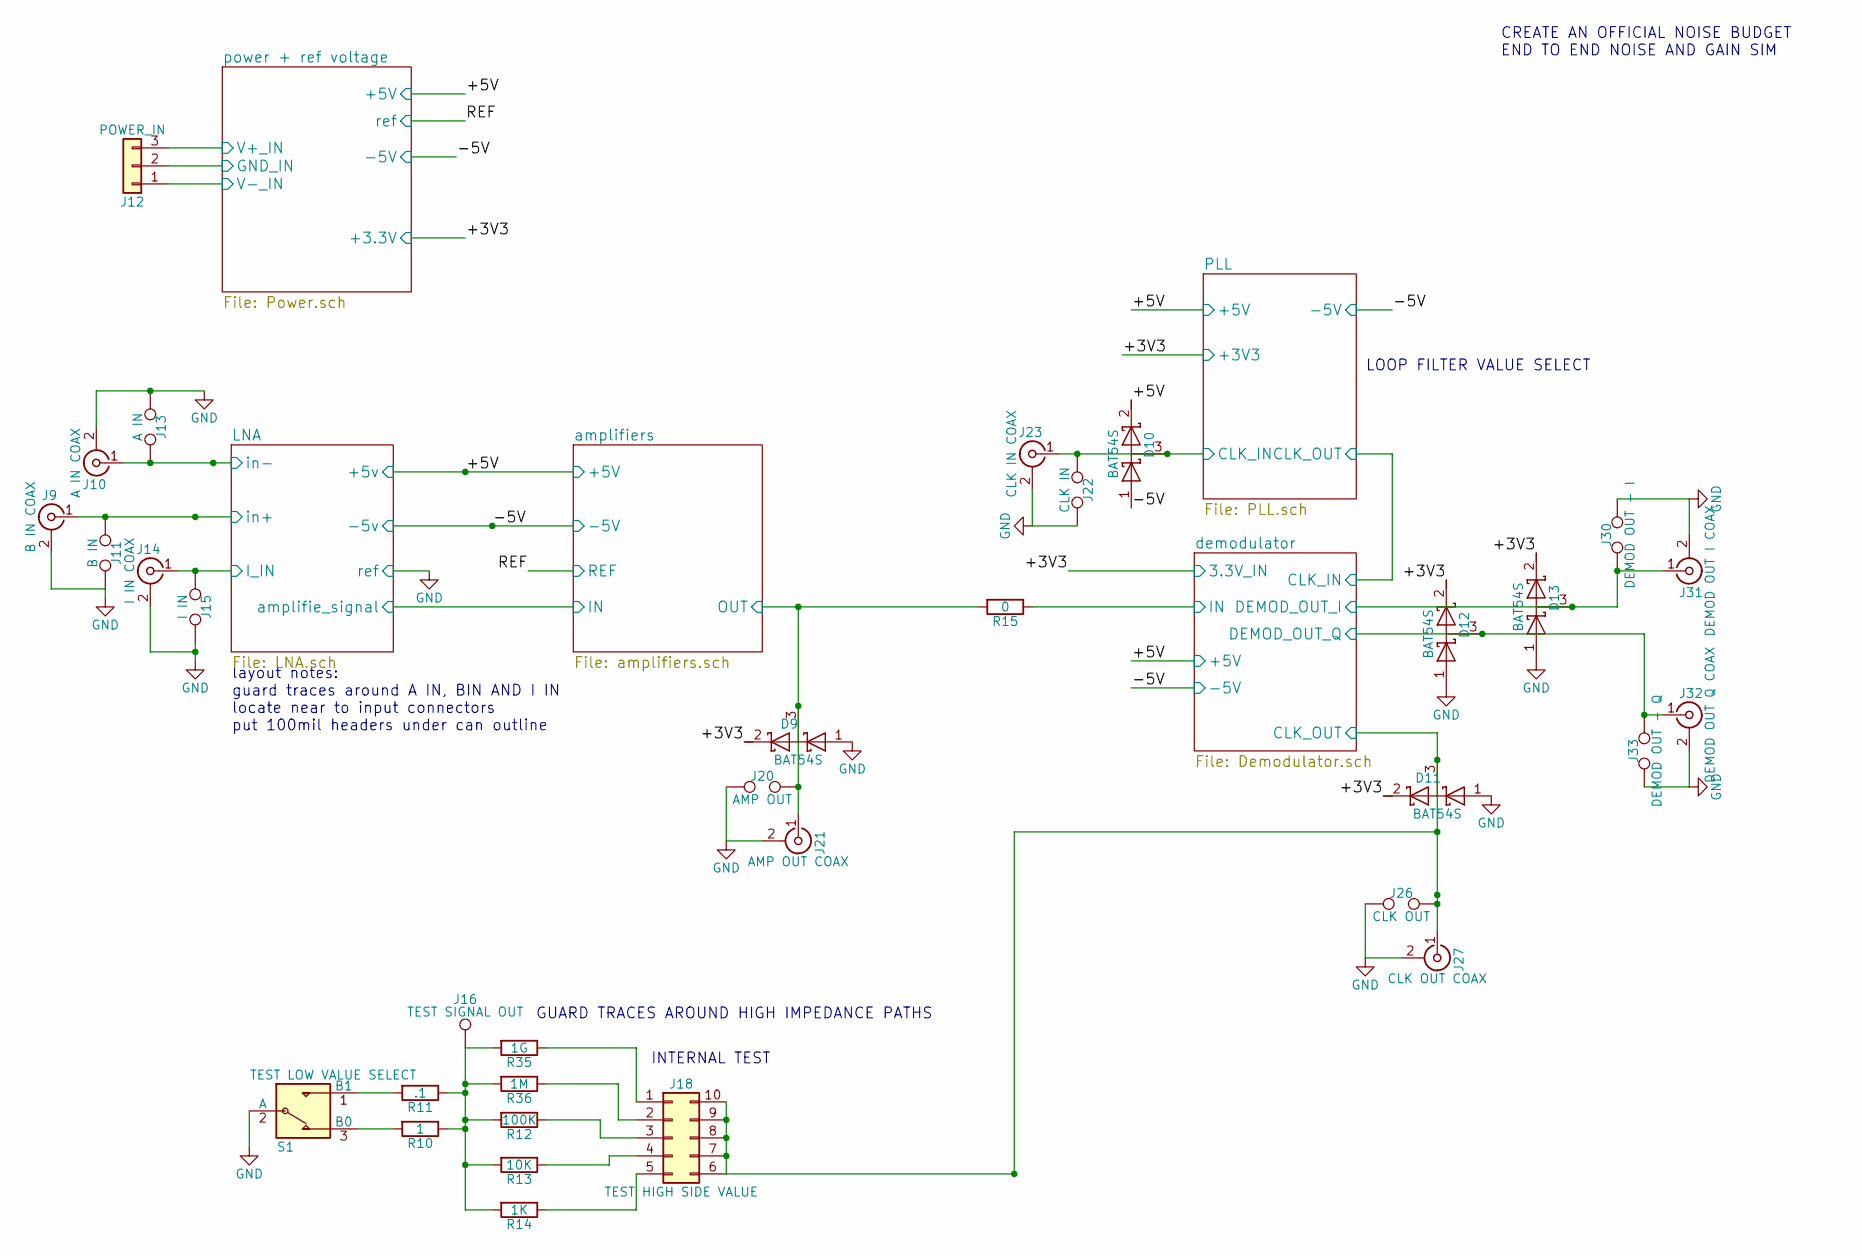
[picture p34: schematic LIA.sch, LOCK IN AMPLIFIER]

Parts:
D9, D10, D11, D12, D13: BAT54S; SOT-23
J9: B IN COAX; SMA_THT_Jack_Straight
J10: A IN COAX; SMA_THT_Jack_Straight
J11: B IN; Pin_Header_Straight_1x02_Pitch2.54mm
J12: POWER_IN; Pin_Header_Straight_1x03_Pitch2.54mm
J13: A IN; Pin_Header_Straight_1x02_Pitch2.54mm
J14: I IN COAX; SMA_THT_Jack_Straight
J15: I IN; Pin_Header_Straight_1x02_Pitch2.54mm
J16: TEST SIGNAL OUT; Pin_Header_Straight_1x01_Pitch1.00mm
J18: TEST HIGH SIDE VALUE; Pin_Header_Straight_2x05_Pitch2.54mm
J20: AMP OUT; Pin_Header_Straight_1x02_Pitch2.54mm
J21: AMP OUT COAX; SMA_THT_Jack_Straight
J22: CLK IN; Pin_Header_Straight_1x02_Pitch2.54mm
J23: CLK IN COAX; SMA_THT_Jack_Straight
J26: CLK OUT; Pin_Header_Straight_1x02_Pitch2.54mm
J27: CLK OUT COAX; SMA_THT_Jack_Straight
J30: DEMOD OUT - I; Pin_Header_Straight_1x02_Pitch2.54mm
J31: DEMOD OUT I COAX; SMA_THT_Jack_Straight
J32: DEMOD OUT Q COAX; SMA_THT_Jack_Straight
J33: DEMOD OUT - Q; Pin_Header_Straight_1x02_Pitch2.54mm
R10: 1; R_0805
R11: .1; R_0805
R12: 100K; R_0805
R13: 10K; R_0805
R14: 1K; R_0805
R15: 0; R_0805
R35: 1G; R_Axial_DIN0414_L11.9mm_D4.5mm_P15.24mm_Horizontal
R36: 1M; R_0805
S1: TEST LOW VALUE SELECT; Pin_Header_Straight_1x03_Pitch2.54mm

Connections:
+3V3: D9.2 (K), D11.2 (K), D12.2 (K), D13.2 (K); also elsewhere on the board
/LNA/I_IN: J14.1 (In), J15.1; also elsewhere on the board
/LNA/in+: J9.1 (In), J11.1; also elsewhere on the board
/LNA/in-: J10.1 (In), J13.2; also elsewhere on the board
/PLL/CLK_IN: D10.3 (common), J22.2, J23.1 (In); also elsewhere on the board
/amplifiers/OUT: D9.3 (common), J20.2, J21.1 (In), R15.2; also elsewhere on the board
/demodulator/CLK_OUT: D11.3 (common), J18.6, J18.7, J18.8, J18.9, J18.10, J26.2, J27.1 (In); also elsewhere on the board
/demodulator/DEMOD_OUT_I: D13.3 (common), J30.2, J31.1 (In); also elsewhere on the board
/demodulator/DEMOD_OUT_Q: D12.3 (common), J32.1 (In), J33.1; also elsewhere on the board
/demodulator/IN: R15.1; also elsewhere on the board
/power + ref voltage/GND_IN: J12.2; also elsewhere on the board
/power + ref voltage/V+_IN: J12.3; also elsewhere on the board
/power + ref voltage/V-_IN: J12.1; also elsewhere on the board
GND: D9.1 (A), D11.1 (A), D12.1 (A), D13.1 (A), J9.2 (Ext), J10.2 (Ext), J11.2, J13.1, J14.2 (Ext), J15.2, J20.1, J21.2 (Ext), J22.1, J23.2 (Ext), J26.1, J27.2 (Ext), J30.1, J31.2 (Ext), J32.2 (Ext), J33.2, S1.2 (A); also elsewhere on the board
unnamed: J16.1, R10.1, R11.1, R12.2, R13.2, R14.2, R35.2, R36.2
unnamed: J18.1, R35.1
unnamed: J18.2, R36.1
unnamed: J18.3, R12.1
unnamed: J18.4, R13.1
unnamed: J18.5, R14.1
unnamed: R10.2, S1.3 (B0)
unnamed: R11.2, S1.1 (B1)

Notes on the sheet:
CREATE AN OFFICIAL NOISE BUDGET END TO END NOISE AND GAIN SIM
layout notes: guard traces around A IN, BIN AND I IN locate near to input connectors put 100mil headers under can outline
INTERNAL TEST
GUARD TRACES AROUND HIGH IMPEDANCE PATHS
LOOP FILTER VALUE SELECT

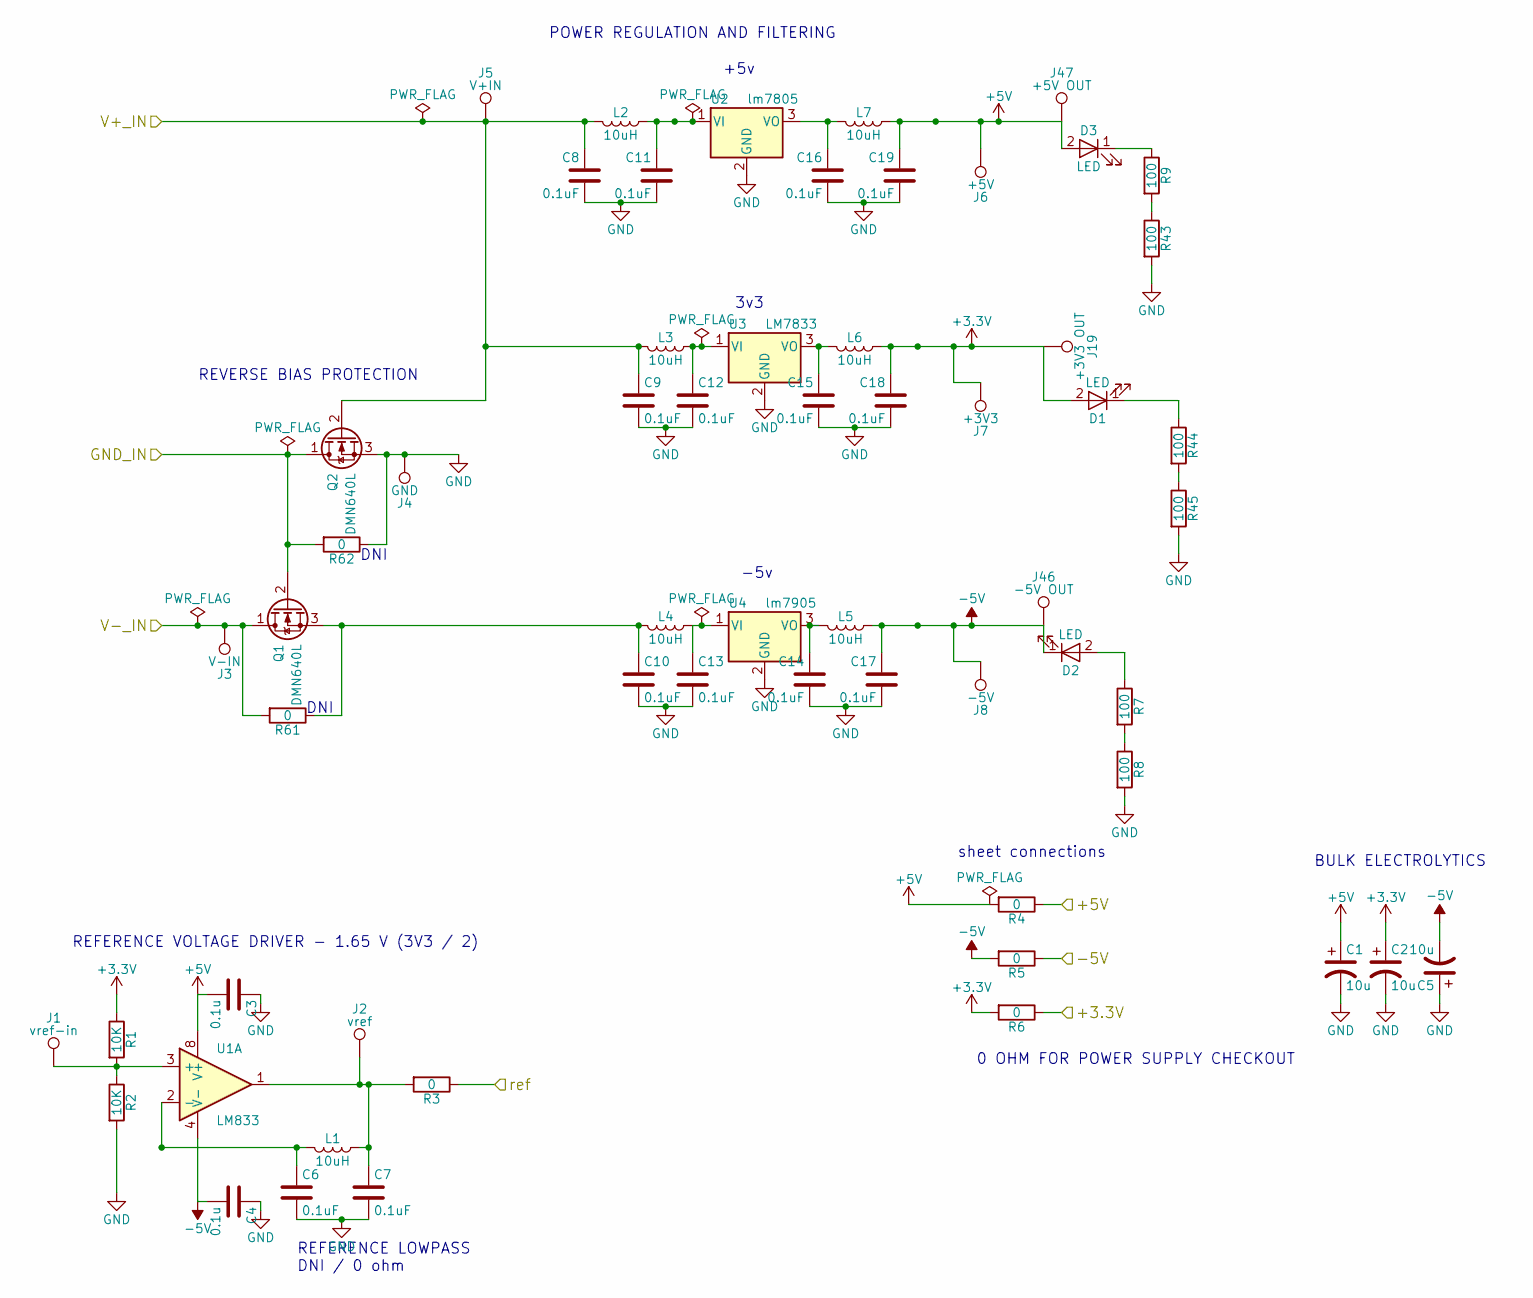
[picture p35: schematic Power.sch, POWER REGULATION AND FILTERING]

Parts:
C1, C2, C5: 10u; CP_Radial_D5.0mm_P2.00mm
C3, C4: 0.1u; C_0805
C6, C7, C8, C9, C10, C11, C12, C13, C14, C15, C16, C17, C18, C19: 0.1uF; C_0805
D1, D2, D3: LED; D_0805
J1: vref-in; tyco_RCU_0603_Probe_Pad
J2: vref; tyco_RCU_0603_Probe_Pad
J3: V-IN; tyco_RCU_0603_Probe_Pad
J4: GND; tyco_RCU_0603_Probe_Pad
J5: V+IN; tyco_RCU_0603_Probe_Pad
J6: +5V; tyco_RCU_0603_Probe_Pad
J7: +3V3; tyco_RCU_0603_Probe_Pad
J8: -5V; tyco_RCU_0603_Probe_Pad
J19: +3V3 OUT; tyco_RCU_0603_Probe_Pad
J46: -5V OUT; tyco_RCU_0603_Probe_Pad
J47: +5V OUT; tyco_RCU_0603_Probe_Pad
L1, L2, L3, L4, L5, L6, L7: 10uH; L_0805_HandSoldering
Q1, Q2: DMN640L; SOT-23
R1, R2: 10K; R_0805
R3, R4, R5, R6: 0; R_0805
R7, R8, R9, R43, R44, R45: 100; R_0805
R61, R62: 0
U1: LM833; SOIC-8-N
U2: lm7805; TO-220_Vertical
U3: LM7833; TO-220_Vertical
U4: lm7905; TO-220_Vertical

Connections:
+3V3: C2.1, C18.1, D1.2 (A), J7.1, J19.1, L6.2, R1.1, R6.1, R6.2; also elsewhere on the board
/REF: R3.1; also elsewhere on the board
/power + ref voltage/GND_IN: Q1.2 (G), Q2.1 (D), R62.2; also elsewhere on the board
/power + ref voltage/V+_IN: C8.1, C9.1, J5.1, L2.1, L3.2, Q2.2 (G); also elsewhere on the board
/power + ref voltage/V-_IN: J3.1, Q1.1 (D), R61.2; also elsewhere on the board
GND: C1.2, C2.2, C3.1, C4.1, C5.1, C6.2, C7.2, C8.2, C9.2, C10.2, C11.2, C12.2, C13.2, C14.2, C15.2, C16.2, C17.2, C18.2, C19.2, J4.1, Q2.3 (S), R2.2, R8.2, R43.2, R45.2, R62.1, U2.2 (GND), U3.2 (GND), U4.2 (GND); also elsewhere on the board
unnamed: C6.1, L1.2, U1.2 (-)
unnamed: C7.1, J2.1, L1.1, R3.2, U1.1
unnamed: C10.1, L4.2, Q1.3 (S), R61.1
unnamed: C11.1, L2.2, U2.1 (VI)
unnamed: C12.1, L3.1, U3.1 (VI)
unnamed: C13.1, L4.1, U4.1 (VI)
unnamed: C14.1, L5.1, U4.3 (VO)
unnamed: C15.1, L6.1, U3.3 (VO)
unnamed: C16.1, L7.1, U2.3 (VO)
unnamed: D1.1 (K), R44.1
unnamed: D2.2 (A), R7.1
unnamed: D3.1 (K), R9.1
unnamed: J1.1, R1.2, R2.1, U1.3 (+)
unnamed: R7.2, R8.1
unnamed: R9.2, R43.1
unnamed: R44.2, R45.1

Notes on the sheet:
REFERENCE VOLTAGE DRIVER - 1.65 V (3V3 / 2)
REFERENCE LOWPASS DNI / 0 ohm
BULK ELECTROLYTICS
3v3
+5v
-5v
sheet connections
0 OHM FOR POWER SUPPLY CHECKOUT
POWER REGULATION AND FILTERING
DNI
REVERSE BIAS PROTECTION

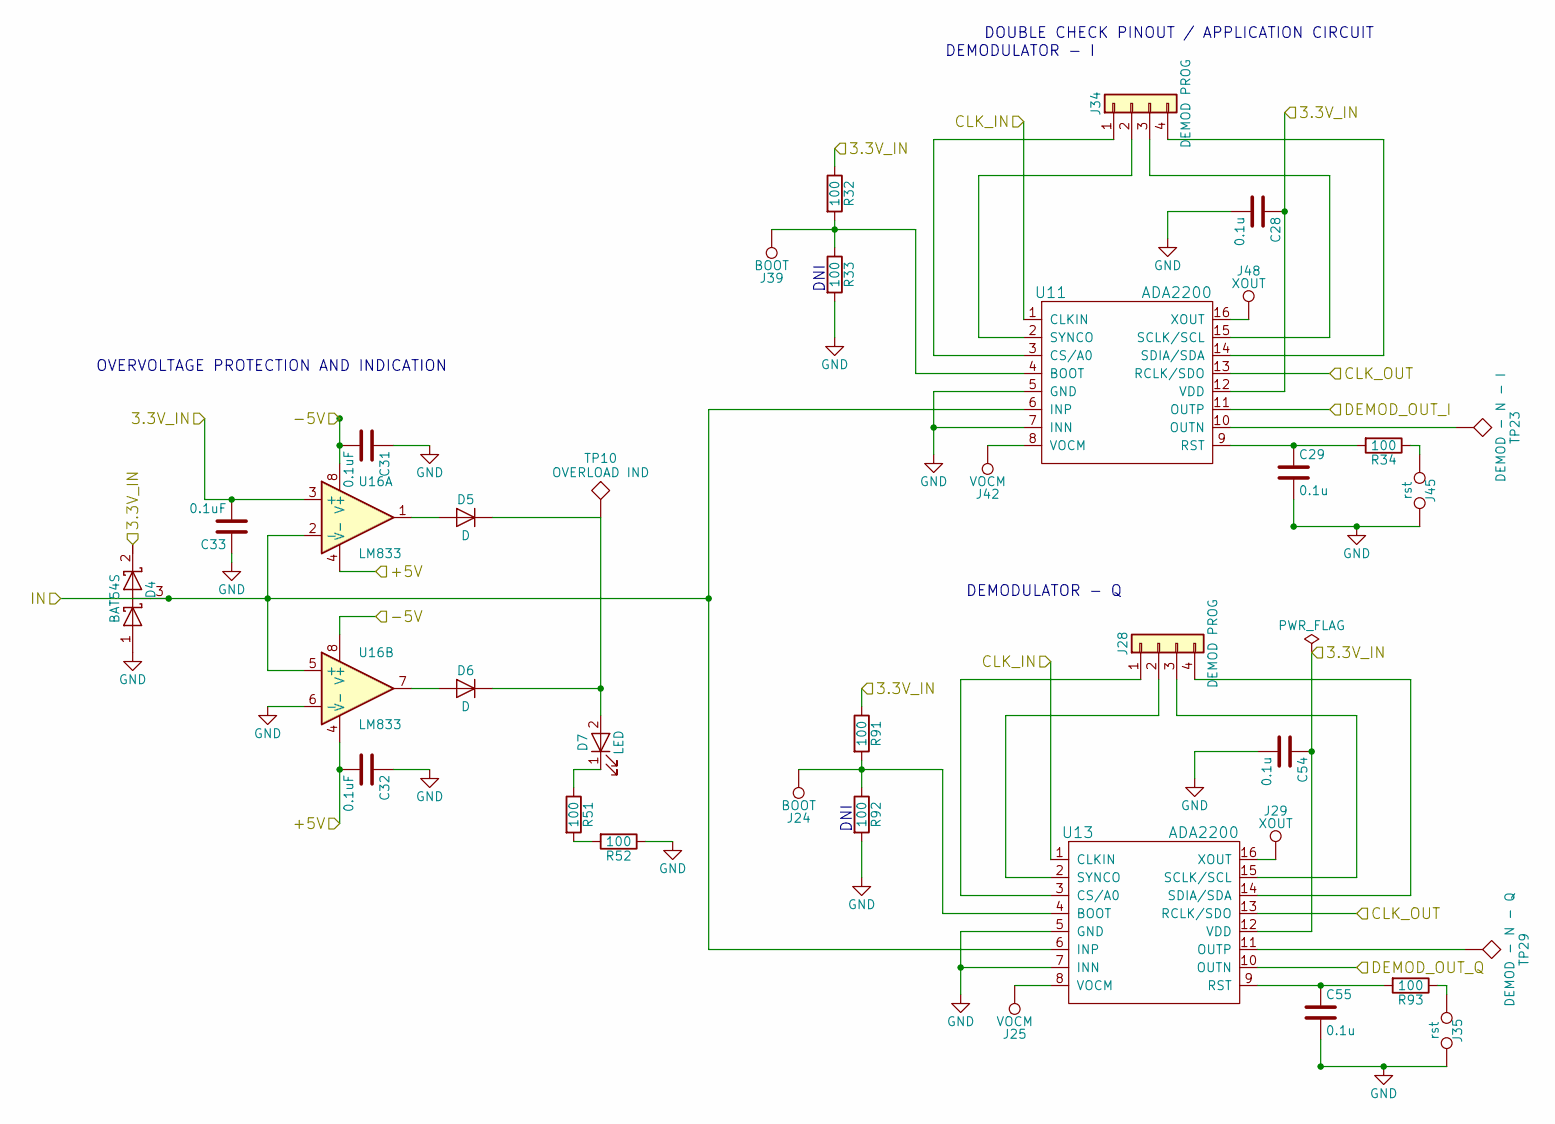
[picture p36: schematic Demodulator.sch]

Parts:
C28, C29, C54, C55: 0.1u; C_0805
C31, C32, C33: 0.1uF; C_0805
D4: BAT54S; SOT-23
D5, D6: D; D_0805
D7: LED; LED_0805
J24, J39: BOOT; tyco_RCU_0603_Probe_Pad
J25, J42: VOCM; tyco_RCU_0603_Probe_Pad
J28, J34: DEMOD PROG; Pin_Header_Straight_1x04_Pitch2.54mm
J29, J48: XOUT; tyco_RCU_0603_Probe_Pad
J35, J45: rst; Pin_Header_Straight_1x02_Pitch2.54mm
R32, R33, R34, R51, R52, R91, R92, R93: 100; R_0805
TP10: OVERLOAD IND; tyco_RCU_0603_Probe_Pad
TP23: DEMOD - N - I; tyco_RCU_0603_Probe_Pad
TP29: DEMOD - N - Q; tyco_RCU_0603_Probe_Pad
U11, U13: ADA2200; TSSOP-20_4.4x6.5mm_Pitch0.65mm
U16: LM833; SO-8_5.3x6.2mm_Pitch1.27mm

Connections:
+3V3: C28.1, C33.2, C54.1, D4.2 (K), R32.1, R91.1, U11.12 (VDD), U13.12 (VDD), U16.3 (+); also elsewhere on the board
/demodulator/CLK_IN: U11.1 (CLKIN), U13.1 (CLKIN); also elsewhere on the board
/demodulator/CLK_OUT: U11.13 (RCLK/SDO), U13.13 (RCLK/SDO); also elsewhere on the board
/demodulator/DEMOD_OUT_I: U11.11 (OUTP); also elsewhere on the board
/demodulator/DEMOD_OUT_Q: U13.10 (OUTN); also elsewhere on the board
/demodulator/IN: D4.3 (common), U11.6 (INP), U13.6 (INP), U16.2 (-), U16.5 (+); also elsewhere on the board
GND: C28.2, C29.2, C31.1, C32.1, C33.1, C54.2, C55.2, D4.1 (A), J35.2, J45.2, R33.2, R52.1, R92.2, U11.5 (GND), U11.7 (INN), U13.5 (GND), U13.7 (INN), U16.6 (-); also elsewhere on the board
unnamed: C29.1, R34.2, U11.9 (RST)
unnamed: C55.1, R93.2, U13.9 (RST)
unnamed: D5.1 (K), D6.1 (K), D7.2 (A), TP10.1
unnamed: D5.2 (A), U16.1
unnamed: D6.2 (A), U16.7
unnamed: D7.1 (K), R51.1
unnamed: J24.1, R91.2, R92.1, U13.4 (BOOT)
unnamed: J25.1, U13.8 (VOCM)
unnamed: J28.1, U13.3 (CS/A0)
unnamed: J28.2, U13.2 (SYNCO)
unnamed: J28.3, U13.15 (SCLK/SCL)
unnamed: J28.4, U13.14 (SDIA/SDA)
unnamed: J29.1, U13.16 (XOUT)
unnamed: J34.1, U11.3 (CS/A0)
unnamed: J34.2, U11.2 (SYNCO)
unnamed: J34.3, U11.15 (SCLK/SCL)
unnamed: J34.4, U11.14 (SDIA/SDA)
unnamed: J35.1, R93.1
unnamed: J39.1, R32.2, R33.1, U11.4 (BOOT)
unnamed: J42.1, U11.8 (VOCM)
unnamed: J45.1, R34.1
unnamed: J48.1, U11.16 (XOUT)
unnamed: R51.2, R52.2
unnamed: TP23.1, U11.10 (OUTN)
unnamed: TP29.1, U13.11 (OUTP)

Notes on the sheet:
DNI
DOUBLE CHECK PINOUT / APPLICATION CIRCUIT
DEMODULATOR - I
OVERVOLTAGE PROTECTION AND INDICATION
DEMODULATOR - Q
