JasMoH/Photoacoustic/lock_in_amplifier/LIA_Build/LIA.kicad_pcb

## KiCad design lock_in_amplifier/LIA_Build/LIA.kicad_pcb (continued)

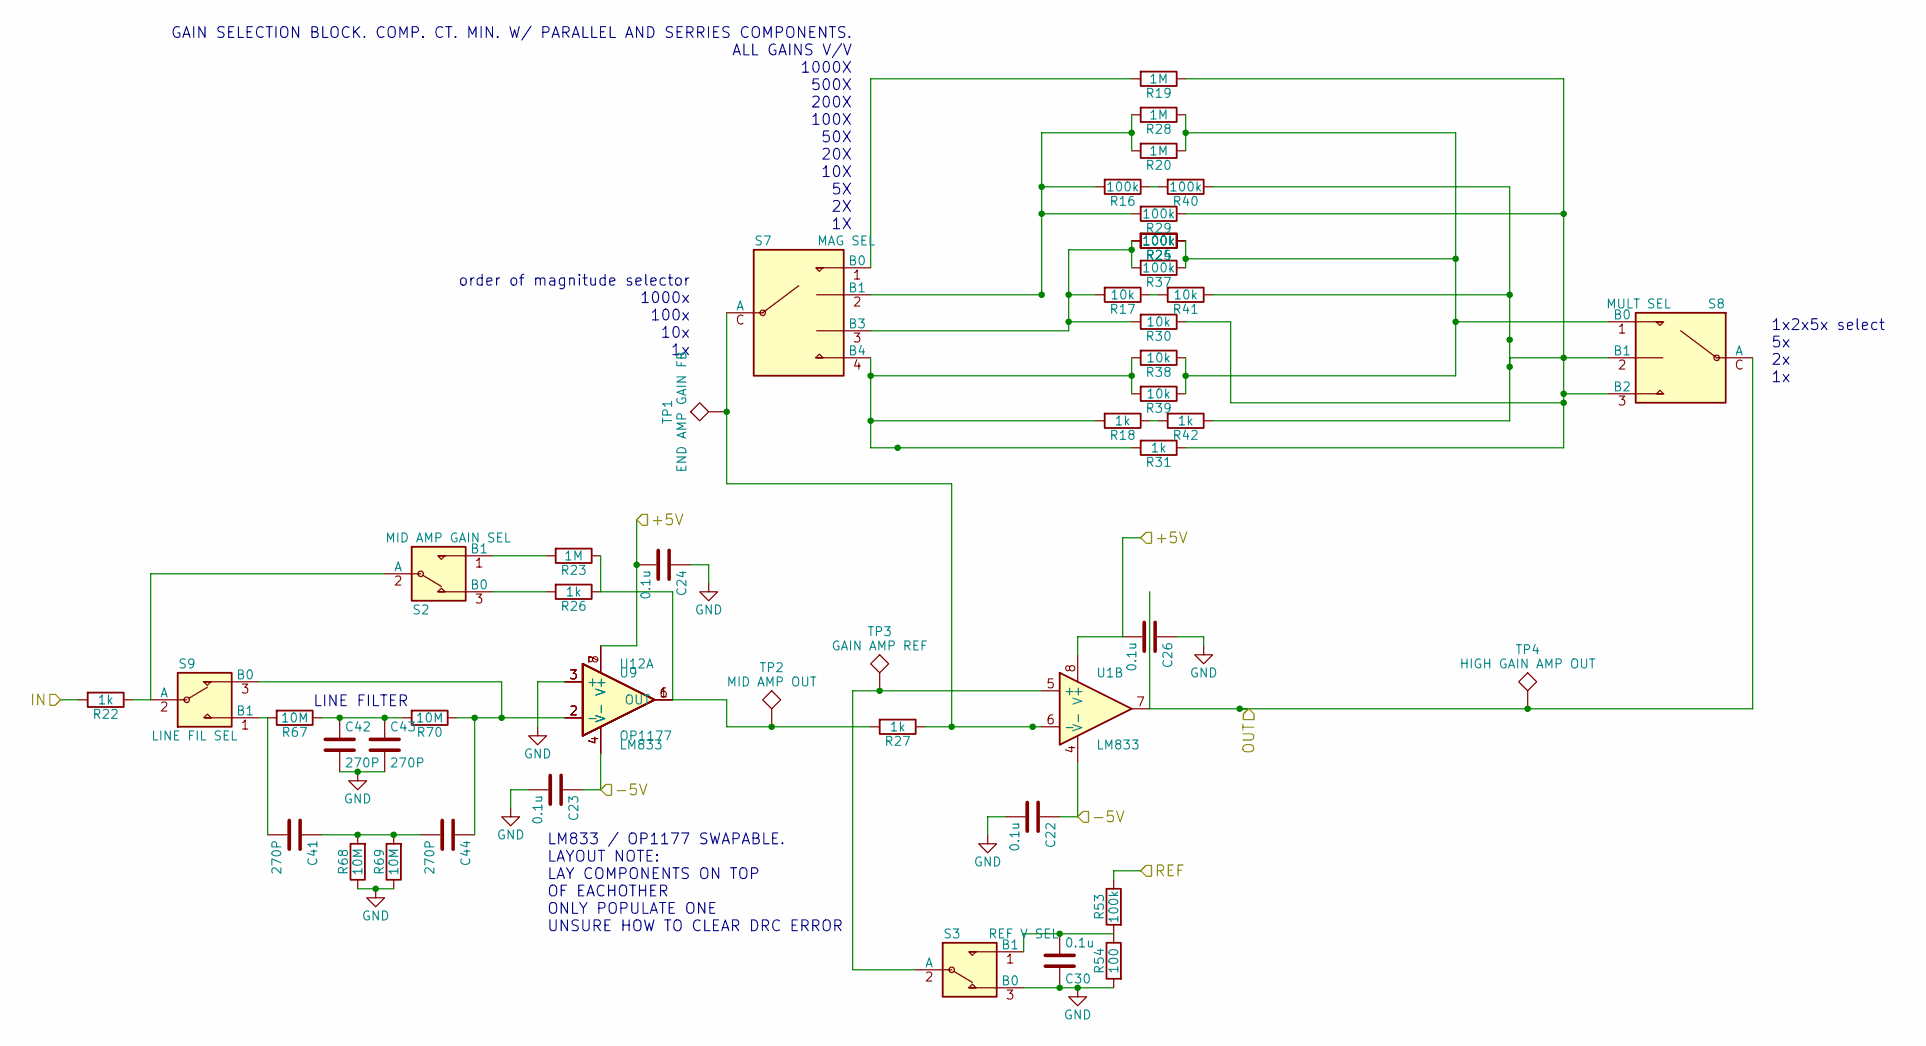
[picture p37: schematic amplifiers.sch, HIGH GAIN AMPLIFIER CHAIN]

Parts:
C22, C23, C24, C26, C30: 0.1u; C_0805
C41, C42, C43, C44: 270P; C_0805
R16, R24, R25, R29, R37, R40, R53: 100k; R_0805
R17, R30, R38, R39, R41: 10k; R_0805
R18, R22, R26, R27, R31, R42: 1k; R_0805
R19, R20, R23, R28: 1M; R_0805
R54: 100; R_0805
R67, R68, R69, R70: 10M; R_0805
S2: MID AMP GAIN SEL; SPDT_OS102011MS2QN1
S3: REF V SEL; SPDT_OS102011MS2QN1
S7: MAG SEL; SP4T_C&K_SS-14D0839-VG
S8: MULT SEL; SP3T_CK_SS-14D0839-VG
S9: LINE FIL SEL; SPDT_OS102011MS2QN1
TP1: END AMP GAIN FB; tyco_RCU_0603_Probe_Pad
TP2: MID AMP OUT; tyco_RCU_0603_Probe_Pad
TP3: GAIN AMP REF; tyco_RCU_0603_Probe_Pad
TP4: HIGH GAIN AMP OUT; tyco_RCU_0603_Probe_Pad
U1: LM833; SOIC-8-N
U9: OP1177; MSOP-8-1EP_3x3mm_Pitch0.65mm
U12: LM833; SO-8_5.3x6.2mm_Pitch1.27mm

Connections:
/REF: R53.1; also elsewhere on the board
/amplifiers/IN: R22.2; also elsewhere on the board
/amplifiers/OUT: S8.C (A), TP4.1, U1.7; also elsewhere on the board
GND: C22.2, C23.2, C24.1, C26.1, C30.1, C42.2, C43.2, R54.2, R68.1, R69.1, S3.3 (B0), U9.3 (+), U12.3 (+); also elsewhere on the board
unnamed: C30.2, R53.2, R54.1, S3.1 (B1)
unnamed: C41.1, C44.2, R68.2, R69.2
unnamed: C41.2, R67.2, S9.1 (B1)
unnamed: C42.1, C43.1, R67.1, R70.2
unnamed: C44.1, R70.1, S9.3 (B0), U9.2 (-), U12.2 (-)
unnamed: R16.1, R40.2
unnamed: R16.2, R20.2, R28.2, R29.2, S7.2 (B1)
unnamed: R17.1, R41.2
unnamed: R17.2, R24.2, R25.2, R30.2, R37.2, S7.3 (B3)
unnamed: R18.1, R42.2
unnamed: R18.2, R31.2, R38.2, R39.2, S7.4 (B4)
unnamed: R19.1, R29.1, R30.1, R31.1, R40.1, R41.1, R42.1, S8.2 (B1), S8.3 (B2)
unnamed: R19.2, S7.1 (B0)
unnamed: R20.1, R24.1, R25.1, R28.1, R37.1, R38.1, R39.1, S8.1 (B0)
unnamed: R22.1, S2.2 (A), S9.2 (A)
unnamed: R23.1, R26.1, R27.2, TP2.1, U9.6 (OUT), U12.1
unnamed: R23.2, S2.1 (B1)
unnamed: R26.2, S2.3 (B0)
unnamed: R27.1, S7.C (A), TP1.1, U1.6 (-)
unnamed: S3.2 (A), TP3.1, U1.5 (+)

Notes on the sheet:
GAIN SELECTION BLOCK. COMP. CT. MIN. W/ PARALLEL AND SERRIES COMPONENTS. ALL GAINS V/V 1000X 500X 200X 100X 50X 20X 10X 5X 2X 1X
1x2x5x select 5x 2x 1x
order of magnitude selector 1000x 100x 10x 1x
LINE FILTER
LM833 / OP1177 SWAPABLE. LAYOUT NOTE: LAY COMPONENTS ON TOP OF EACHOTHER ONLY POPULATE ONE UNSURE HOW TO CLEAR DRC ERROR

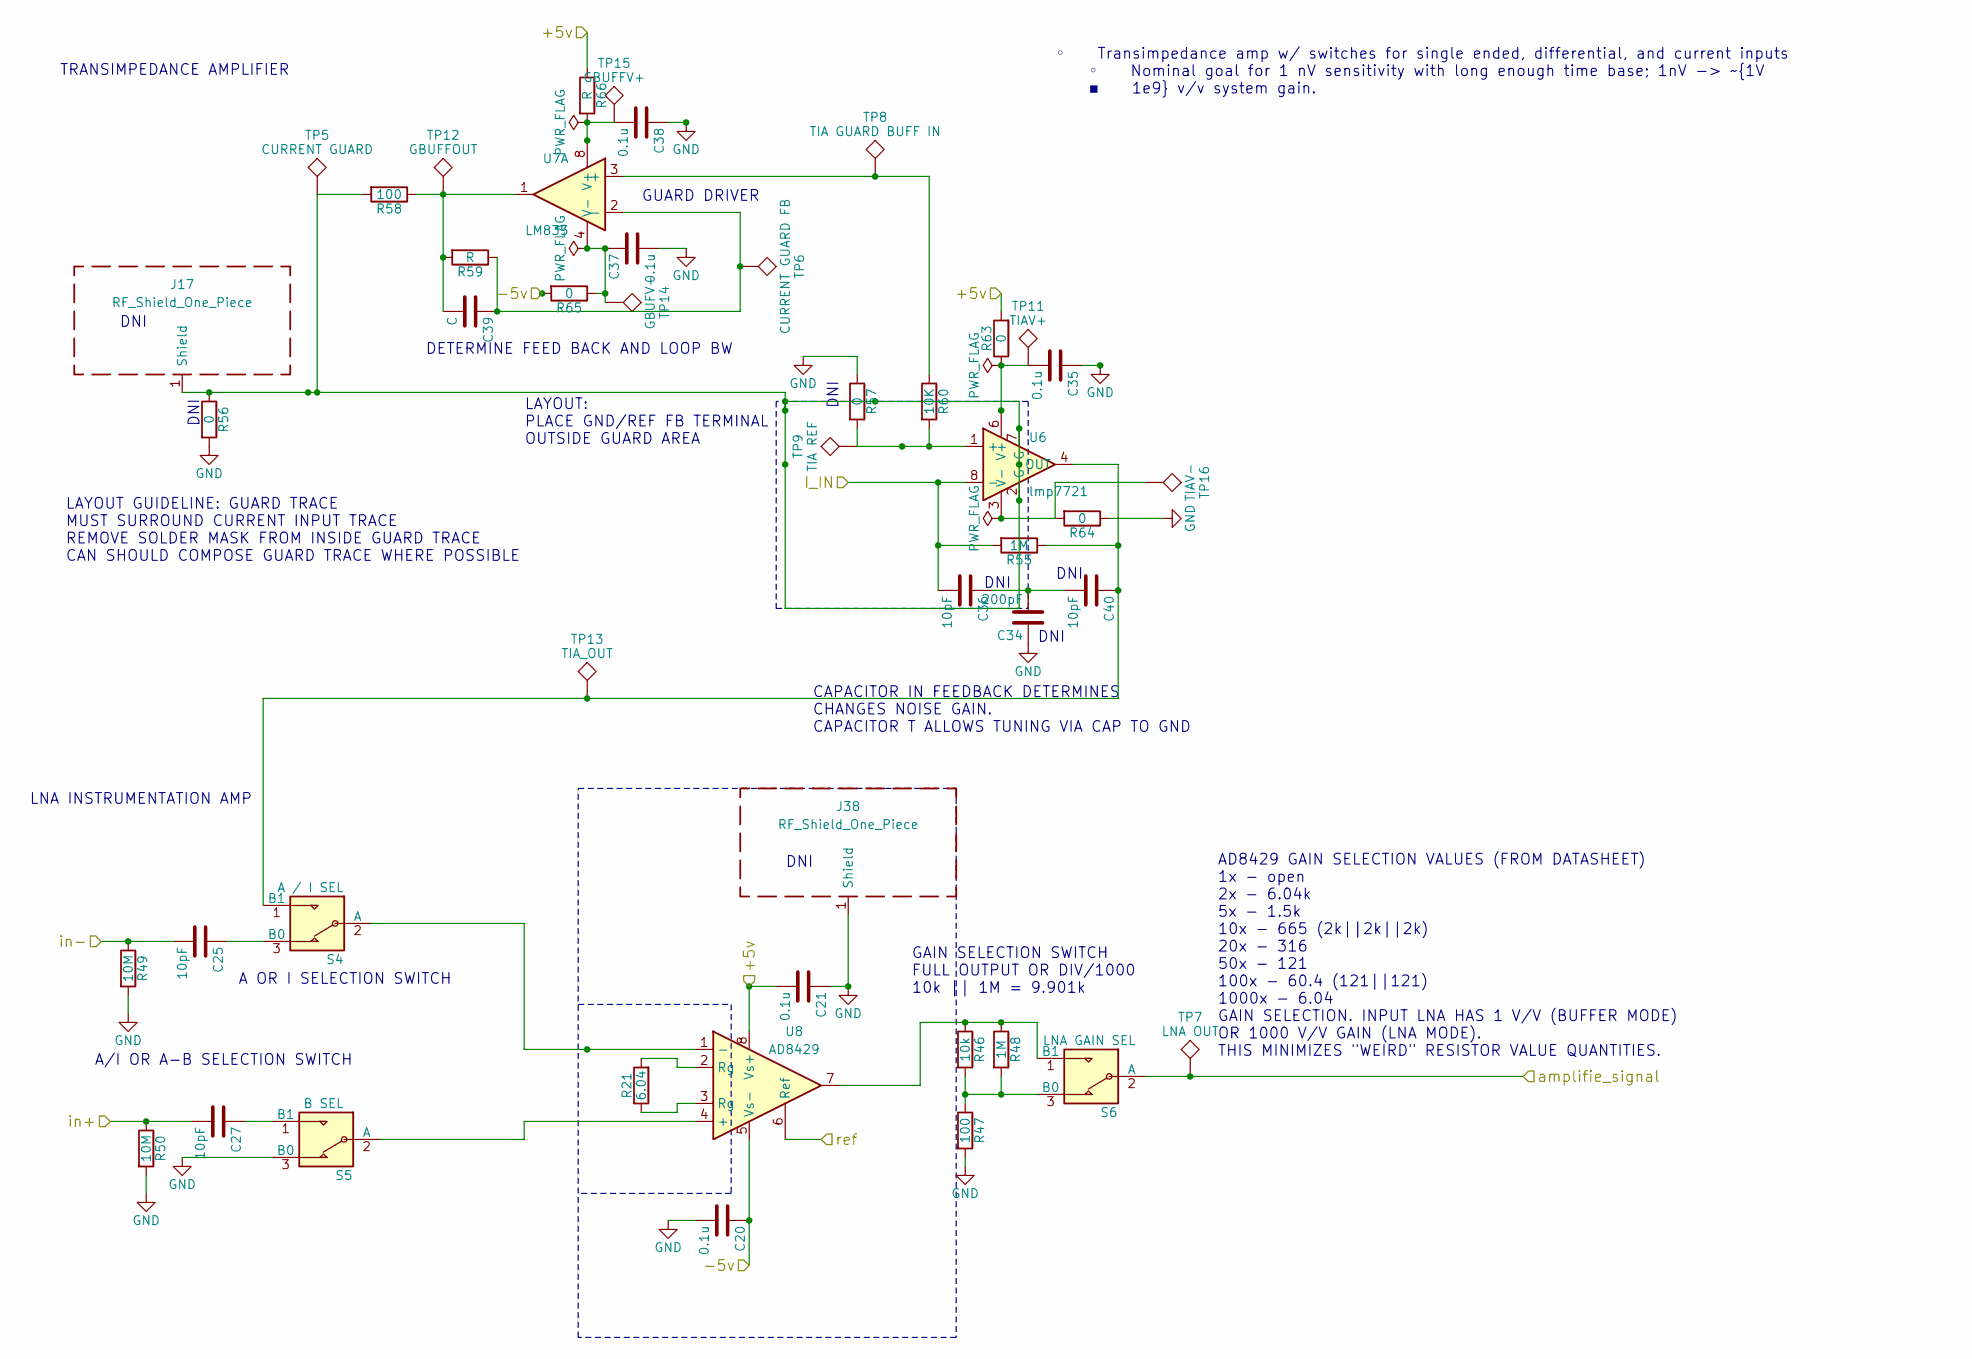
[picture p38: schematic LNA.sch, LNA AND TRANSIMPEDANCE AMPLIFIER]

Parts:
C20, C21, C35, C37, C38: 0.1u; C_0805
C25, C27, C36, C40: 10pF
C34: 200pF
C39: C
J17, J38: RF_Shield_One_Piece; SMS-201
R21: 6.04; R_0805
R46: 10k
R47, R58: 100
R48, R55: 1M
R49, R50: 10M
R56, R57, R63, R64, R65: 0
R59, R66: R
R60: 10K
S4: A / I SEL; SPDT_OS102011MS2QN1
S5: B SEL; SPDT_OS102011MS2QN1
S6: LNA GAIN SEL; SPDT_OS102011MS2QN1
TP5: CURRENT GUARD
TP6: CURRENT GUARD FB
TP7: LNA OUT
TP8: TIA GUARD BUFF IN
TP9: TIA REF
TP11: TIAV+
TP12: GBUFFOUT
TP13: TIA_OUT
TP14: GBUFV-
TP15: GBUFFV+
TP16: TIAV-
U6: lmp7721; MSOP-8-1EP_3x3mm_Pitch0.65mm
U7: LM833
U8: AD8429; SOIC-8_3.9x4.9mm_Pitch1.27mm

Connections:
/LNA/I_IN: C36.2, R55.2, U6.8 (-); also elsewhere on the board
/LNA/in+: C27.2, R50.1; also elsewhere on the board
/LNA/in-: C25.2, R49.1; also elsewhere on the board
/amplifiers/IN: S6.2 (A), TP7.1; also elsewhere on the board
GND: C20.2, C21.1, C34.1, C35.1, C37.2, C38.1, J38.1, R47.2, R49.2, R50.2, R56.2, R57.1, R64.1, S5.3 (B0), U8.6 (Ref); also elsewhere on the board
unnamed: C25.1, S4.3 (B0)
unnamed: C27.1, S5.1 (B1)
unnamed: C34.2, C36.1, C40.2
unnamed: C35.2, R63.1, TP11.1, U6.6 (V+)
unnamed: C39.1, R59.1, TP6.1, U7.2 (-)
unnamed: C39.2, R58.1, R59.2, TP12.1, U7.1
unnamed: C40.1, R55.1, S4.1 (B1), TP13.1, U6.4 (OUT)
unnamed: J17.1, R56.1, R58.2, TP5.1, U6.2 (G), U6.7 (G)
unnamed: R21.1, U8.3 (Rg)
unnamed: R21.2, U8.2 (Rg)
unnamed: R46.1, R48.1, S6.1 (B1), U8.7
unnamed: R46.2, R47.1, R48.2, S6.3 (B0)
unnamed: R57.2, R60.2, TP9.1, U6.1 (+)
unnamed: R60.1, TP8.1, U7.3 (+)
unnamed: R64.2, TP16.1, U6.3 (V-)
unnamed: S4.2 (A), U8.1 (-)
unnamed: S5.2 (A), U8.4 (+)

Notes on the sheet:
LNA INSTRUMENTATION AMP
◦ Transimpedance amp w/ switches for single ended, differential, and current inputs ◦ Nominal goal for 1 nV sensitivity with long enough time base; 1nV -> ~1V ▪ 1e9 v/v system gain.
AD8429 GAIN SELECTION VALUES (FROM DATASHEET) 1x - open 2x - 6.04k 5x - 1.5k 10x - 665 (2k||2k||2k) 20x - 316 50x - 121 100x - 60.4 (121||121) 1000x - 6.04 GAIN SELECTION. INPUT LNA HAS 1 V/V (BUFFER MODE) OR 1000 V/V GAIN (LNA MODE). THIS MINIMIZES "WEIRD" RESISTOR VALUE QUANTITIES.
TRANSIMPEDANCE AMPLIFIER
A OR I SELECTION SWITCH
A/I OR A-B SELECTION SWITCH
GAIN SELECTION SWITCH FULL OUTPUT OR DIV/1000 10k || 1M = 9.901k
LAYOUT GUIDELINE: GUARD TRACE MUST SURROUND CURRENT INPUT TRACE REMOVE SOLDER MASK FROM INSIDE GUARD TRACE CAN SHOULD COMPOSE GUARD TRACE WHERE POSSIBLE
GUARD DRIVER
DNI
LAYOUT: PLACE GND/REF FB TERMINAL OUTSIDE GUARD AREA
DETERMINE FEED BACK AND LOOP BW
CAPACITOR IN FEEDBACK DETERMINES CHANGES NOISE GAIN. CAPACITOR T ALLOWS TUNING VIA CAP TO GND

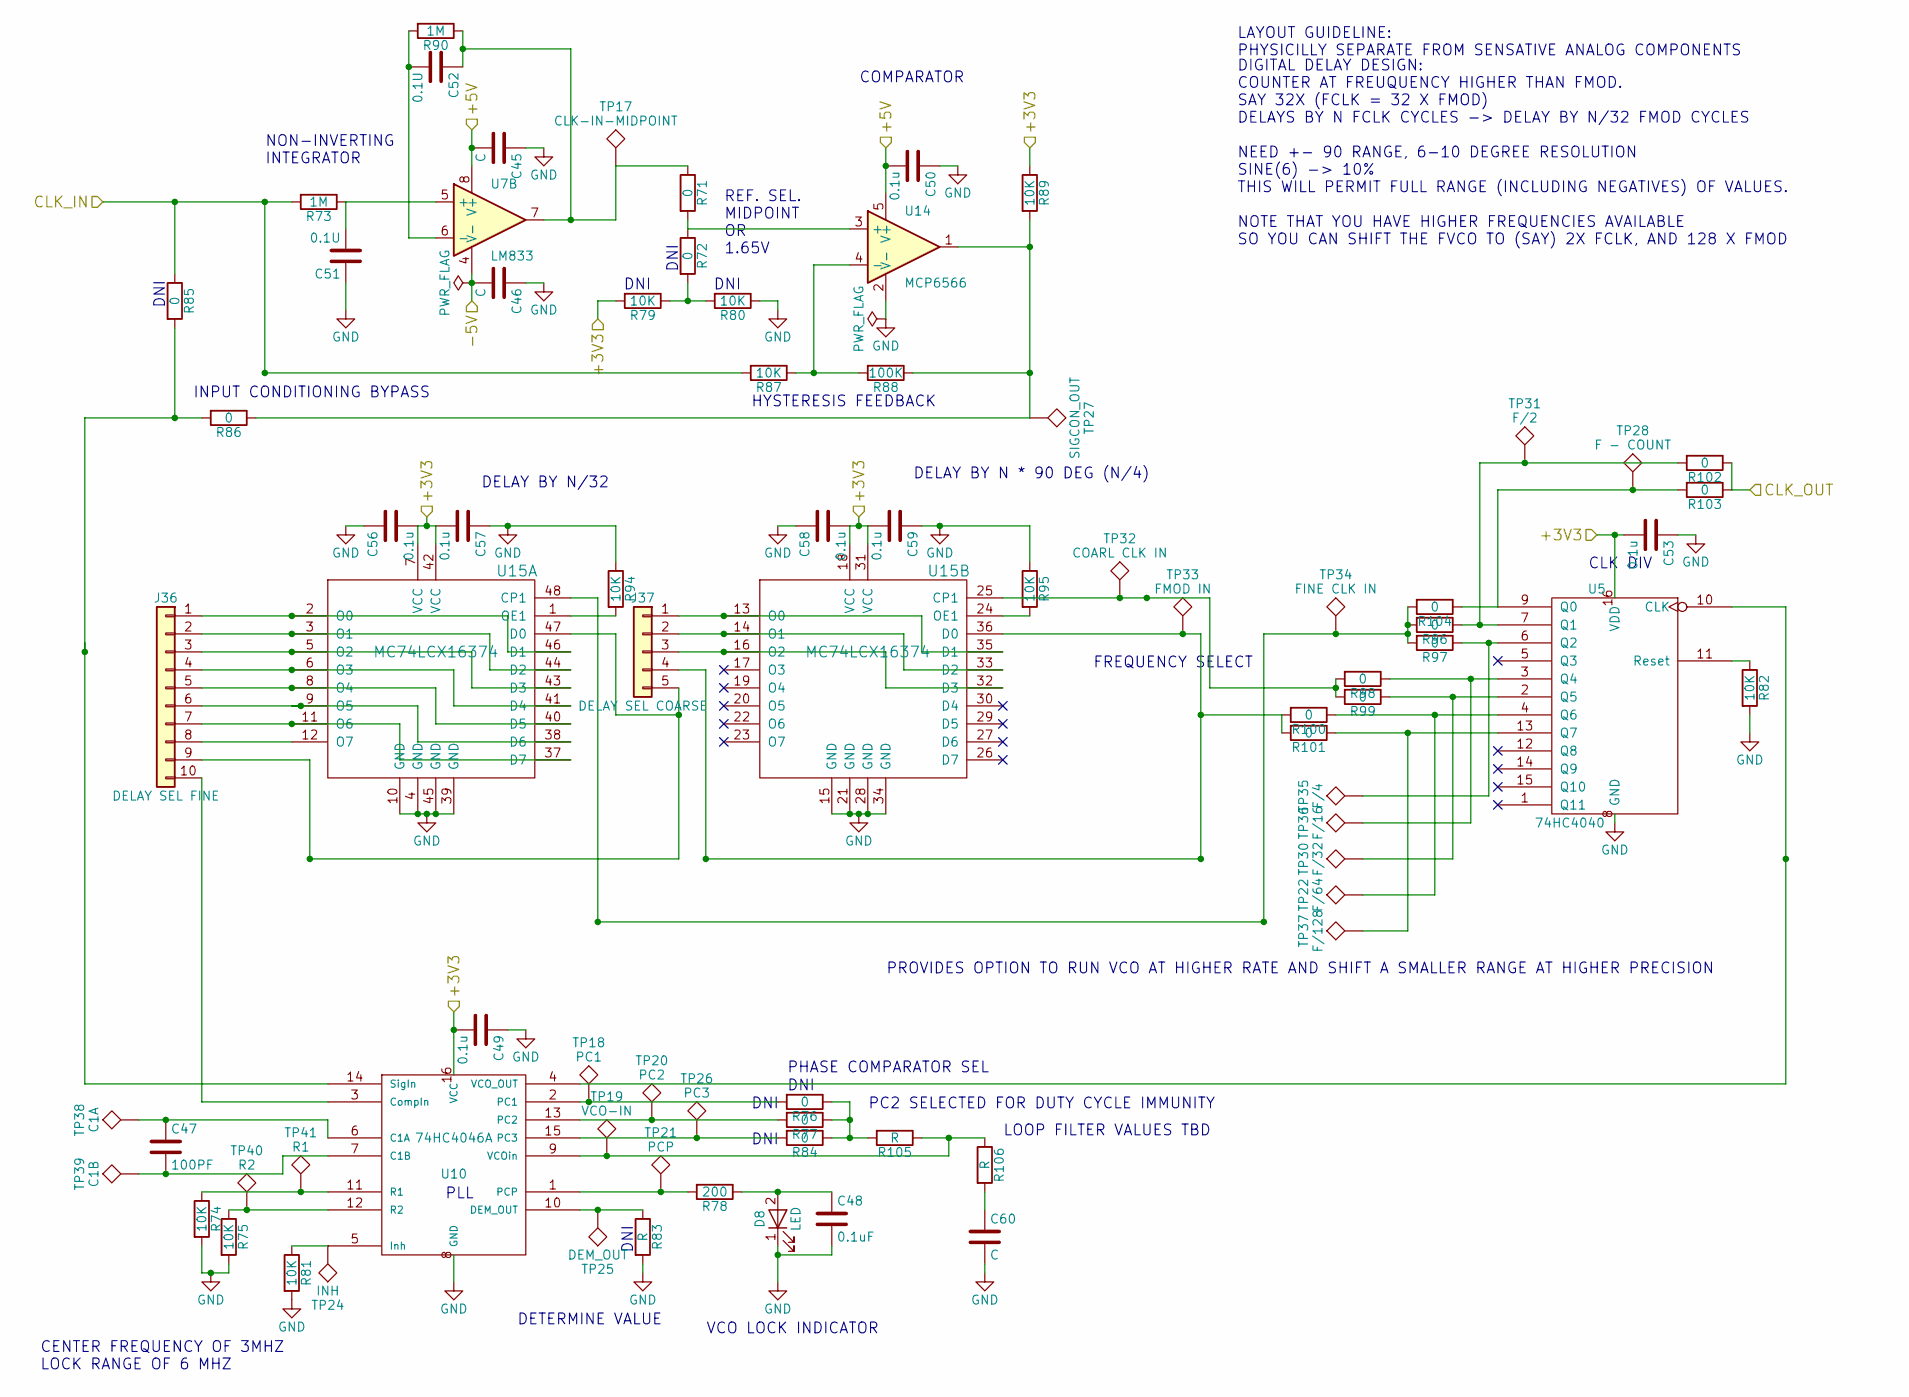
[picture p39: schematic PLL.sch, PHASE LOCKED LOOP]

Parts:
C45, C46, C60: C; C_0805
C47: 100PF; C_0805
C48: 0.1uF; C_0805
C49, C50, C53, C56, C57, C58, C59: 0.1u; C_0805
C51, C52: 0.1U; C_0805
D8: LED; LED_0805
J36: DELAY SEL FINE; Pin_Header_Straight_1x10_Pitch2.54mm
J37: DELAY SEL COARSE; Pin_Header_Straight_1x05_Pitch2.54mm
R71, R72, R76, R77, R84, R85, R86, R96, R97, R98, R99, R100, R101, R102, R103, R104: 0; R_0805
R73, R90: 1M; R_0805
R74, R75, R79, R80, R81, R82, R87, R89, R94, R95: 10K; R_0805
R78: 200; R_0805
R83, R105, R106: R; R_0805
R88: 100K; R_0805
TP17: CLK-IN-MIDPOINT; tyco_RCU_0603_Probe_Pad
TP18: PC1; tyco_RCU_0603_Probe_Pad
TP19: VCO-IN; tyco_RCU_0603_Probe_Pad
TP20: PC2; tyco_RCU_0603_Probe_Pad
TP21: PCP; tyco_RCU_0603_Probe_Pad
TP22: F/64; tyco_RCU_0603_Probe_Pad
TP24: INH; tyco_RCU_0603_Probe_Pad
TP25: DEM_OUT; tyco_RCU_0603_Probe_Pad
TP26: PC3; tyco_RCU_0603_Probe_Pad
TP27: SIGCON_OUT; tyco_RCU_0603_Probe_Pad
TP28: F - COUNT; tyco_RCU_0603_Probe_Pad
TP30: F/32; tyco_RCU_0603_Probe_Pad
TP31: F/2; tyco_RCU_0603_Probe_Pad
TP32: COARL CLK IN; tyco_RCU_0603_Probe_Pad
TP33: FMOD IN; tyco_RCU_0603_Probe_Pad
TP34: FINE CLK IN; tyco_RCU_0603_Probe_Pad
TP35: F/4; tyco_RCU_0603_Probe_Pad
TP36: F/16; tyco_RCU_0603_Probe_Pad
TP37: F/128; tyco_RCU_0603_Probe_Pad
TP38: C1A; tyco_RCU_0603_Probe_Pad
TP39: C1B; tyco_RCU_0603_Probe_Pad
TP40: R2; tyco_RCU_0603_Probe_Pad
TP41: R1; tyco_RCU_0603_Probe_Pad
U5: 74HC4040; TSSOP-16_4.4x5mm_Pitch0.65mm
U7: LM833; SO-8_5.3x6.2mm_Pitch1.27mm
U10: 74HC4046A; SOIC-16_3.9x9.9mm_Pitch1.27mm
U14: MCP6566; SOT-23-5
U15: MC74LCX16374; TSSOP-48_6.1x12.5mm_Pitch0.5mm

Connections:
+3V3: C49.2, C53.2, C56.2, C57.2, C58.2, C59.2, R79.2, R89.1, U5.16 (VDD), U10.16 (VCC), U15.7 (VCC), U15.18 (VCC), U15.31 (VCC), U15.42 (VCC); also elsewhere on the board
/PLL/CLK_IN: R73.2, R85.1, R87.2; also elsewhere on the board
/demodulator/CLK_IN: R102.1, R103.1; also elsewhere on the board
GND: C45.1, C46.1, C48.2, C49.1, C50.1, C51.1, C53.1, C56.1, C57.1, C58.1, C59.1, C60.2, D8.1 (K), R74.2, R75.2, R80.1, R81.2, R82.2, R83.2, R94.1, R95.1, U5.8 (GND), U10.8 (GND), U14.2 (V-), U15.4 (GND), U15.10 (GND), U15.15 (GND), U15.21 (GND), U15.28 (GND), U15.34 (GND), U15.39 (GND), U15.45 (GND); also elsewhere on the board
unnamed: C47.1, TP38.1, U10.6 (C1A)
unnamed: C47.2, TP39.1, U10.7 (C1B)
unnamed: C48.1, D8.2 (A), R78.1
unnamed: C51.2, R73.1, U7.5 (+)
unnamed: C52.1, R71.1, R90.1, TP17.1, U7.7
unnamed: C52.2, R90.2, U7.6 (-)
unnamed: C60.1, R106.2
unnamed: J36.1, U15.2 (O0), U15.46 (D1)
unnamed: J36.2, U15.3 (O1), U15.44 (D2)
unnamed: J36.3, U15.5 (O2), U15.43 (D3)
unnamed: J36.4, U15.6 (O3), U15.41 (D4)
unnamed: J36.5, U15.8 (O4), U15.40 (D5)
unnamed: J36.6, U15.9 (O5), U15.38 (D6)
unnamed: J36.7, U15.11 (O6), U15.37 (D7)
unnamed: J36.8, U15.12 (O7)
unnamed: J36.9, J37.5, U15.47 (D0)
unnamed: J36.10, U10.3 (CompIn)
unnamed: J37.1, U15.13 (O0), U15.35 (D1)
unnamed: J37.2, U15.14 (O1), U15.33 (D2)
unnamed: J37.3, U15.16 (O2), U15.32 (D3)
unnamed: J37.4, R100.2, R101.2, TP33.1, U15.36 (D0)
unnamed: R71.2, R72.1, U14.3 (+)
unnamed: R72.2, R79.1, R80.2
unnamed: R74.1, TP41.1, U10.11 (R1)
unnamed: R75.1, TP40.1, U10.12 (R2)
unnamed: R76.2, TP18.1, U10.2 (PC1)
unnamed: R77.2, TP20.1, U10.13 (PC2)
unnamed: R78.2, TP21.1, U10.1 (PCP)
unnamed: R81.1, TP24.1, U10.5 (Inh)
unnamed: R82.1, U5.11 (Reset)
unnamed: R83.1, TP25.1, U10.10 (DEM_OUT)
unnamed: R84.2, TP26.1, U10.15 (PC3)
unnamed: R85.2, R86.2, U10.14 (SigIn)
unnamed: R86.1, R88.1, R89.2, TP27.1, U14.1
unnamed: R87.1, R88.2, U14.4 (-)
unnamed: R94.2, U15.1 (OE1)
unnamed: R95.2, U15.24 (OE1)
unnamed: R97.1, TP35.1, U5.6 (Q2)
unnamed: R98.1, TP36.1, U5.3 (Q4)
unnamed: R98.2, R99.2, TP32.1, U15.25 (CP1)
unnamed: R99.1, TP30.1, U5.2 (Q5)
unnamed: R100.1, TP22.1, U5.4 (Q6)
unnamed: R101.1, TP37.1, U5.13 (Q7)
unnamed: R96.1, R102.2, TP31.1, U5.7 (Q1)
unnamed: R103.2, R104.1, TP28.1, U5.9 (Q0)
unnamed: R96.2, R97.2, R104.2, TP34.1, U15.48 (CP1)
unnamed: R105.1, R106.1, TP19.1, U10.9 (VCOin)
unnamed: R76.1, R77.1, R84.1, R105.2
unnamed: U5.10 (CLK), U10.4 (VCO_OUT)

Notes on the sheet:
PLL
CLK DIV
LAYOUT GUIDELINE: PHYSICILLY SEPARATE FROM SENSATIVE ANALOG COMPONENTS
NON-INVERTING INTEGRATOR
COMPARATOR
REF. SEL. MIDPOINT OR 1.65V
FREQUENCY SELECT
DNI
PHASE COMPARATOR SEL
VCO LOCK INDICATOR
DETERMINE VALUE
INPUT CONDITIONING BYPASS
HYSTERESIS FEEDBACK
DIGITAL DELAY DESIGN: COUNTER AT FREUQUENCY HIGHER THAN FMOD. SAY 32X (FCLK = 32 X FMOD) DELAYS BY N FCLK CYCLES -> DELAY BY N/32 FMOD CYCLES NEED +- 90 RANGE, 6-10 DEGREE RESOLUTION SINE(6) -> 10% THIS WILL PERMIT FULL RANGE (INCLUDING NEGATIVES) OF VALUES. NOTE THAT YOU HAVE HIGHER FREQUENCIES AV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
DELAY BY N * 90 DEG (N/4)
DELAY BY N/32
PROVIDES OPTION TO RUN VCO AT HIGHER RATE AND SHIFT A SMALLER RANGE AT HIGHER PRECISION
CENTER FREQUENCY OF 3MHZ LOCK RANGE OF 6 MHZ
PC2 SELECTED FOR DUTY CYCLE IMMUNITY
LOOP FILTER VALUES TBD

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
Board: 2 copper layers, 295 parts (26 on the bottom side), 156 nets, no tracks yet.
