JasMoH/Photoacoustic/lock_in_amplifier/instrumentation amp bob/inst_amp.kicad_pcb

## KiCad design lock_in_amplifier/instrumentation amp bob/inst_amp.kicad_pcb (2017-10-27)

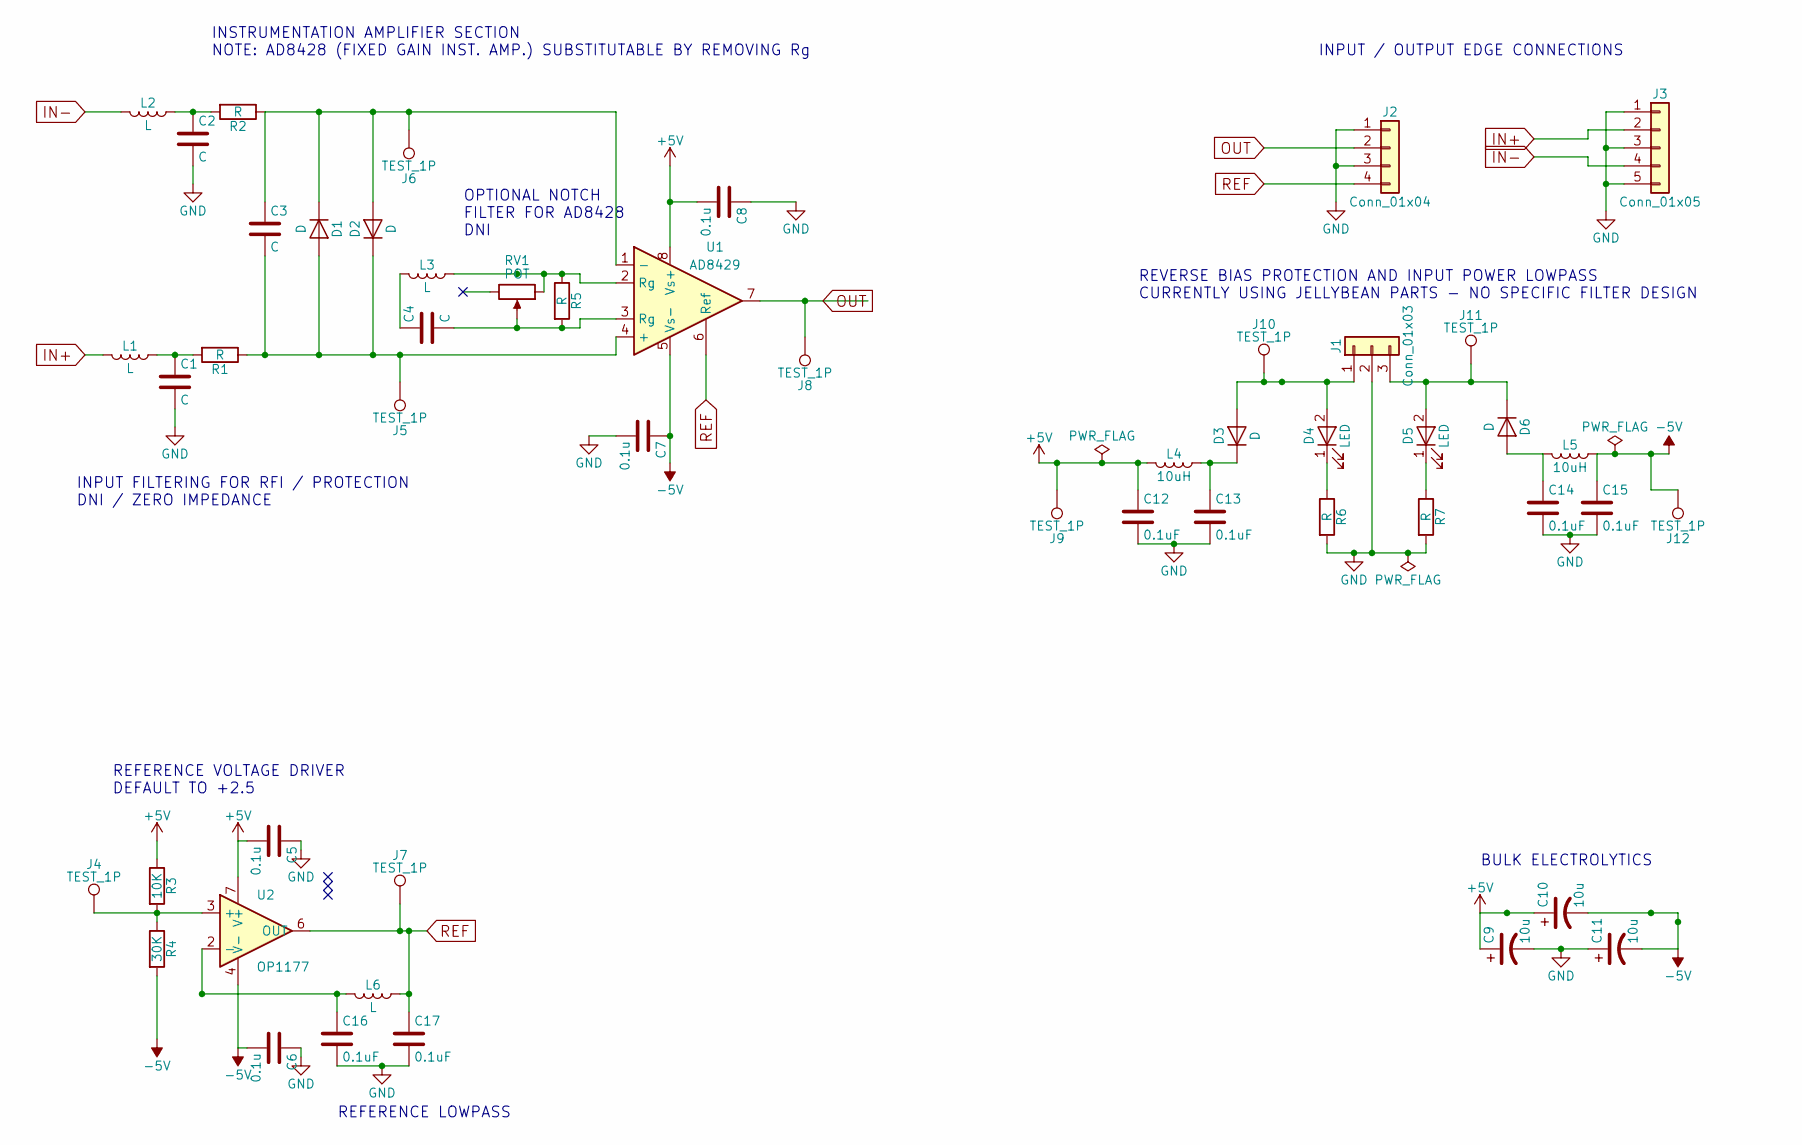
[picture p40: schematic inst_amp.sch, AD842X BREAKOUT BOARD]

Parts:
C1, C2, C3, C4: C; C_0805_HandSoldering
C5, C6, C7, C8: 0.1u; C_0805_HandSoldering
C9, C10, C11: 10u; CP_Radial_D5.0mm_P2.00mm
C12, C13, C14, C15, C16, C17: 0.1uF; C_0805_HandSoldering
D1, D2, D3, D6: D; D_0805
D4, D5: LED; D_0805
J1: Conn_01x03; Pin_Header_Angled_1x03_Pitch2.54mm
J2: Conn_01x04; Pin_Header_Angled_1x04_Pitch2.54mm
J3: Conn_01x05; Pin_Header_Angled_1x05_Pitch2.54mm
J4, J5, J6, J7, J8, J9, J10, J11, J12: TEST_1P; Measurement_Point_Round-SMD-Pad_Small
L1, L2, L3, L6: L; L_0805_HandSoldering
L4, L5: 10uH; L_0805_HandSoldering
R1, R2, R5, R6, R7: R; R_0805_HandSoldering
R3: 10K; R_0805_HandSoldering
R4: 30K; R_0805_HandSoldering
RV1: POT; Potentiometer_Trimmer_Bourns_PV36W
U1: AD8429; SOIC-8_3.9x4.9mm_Pitch1.27mm
U2: OP1177; MSOP-8-1EP_3x3mm_Pitch0.65mm

Connections:
+5V: C5.2, C8.2, C9.1, C10.1, C12.1, J9.1, L4.2, R3.1, U1.8 (Vs+), U2.7 (V+)
-5V: C6.2, C7.1, C10.2, C11.2, C15.1, J12.1, L5.1, R4.2, U1.5 (Vs-), U2.4 (V-)
GND: C1.2, C2.2, C5.1, C6.1, C7.2, C8.1, C9.2, C11.1, C12.2, C13.2, C14.2, C15.2, C16.2, C17.2, J1.2, J2.1, J2.3, J3.1, J3.3, J3.5, R6.2, R7.2
IN+: J3.2, L1.2
IN-: J3.4, L2.2
unnamed: C1.1, L1.1, R1.2
unnamed: C2.1, L2.1, R2.2
unnamed: C3.1, D1.1 (K), D2.2 (A), J6.1, R2.1, U1.1 (-)
unnamed: C3.2, D1.2 (A), D2.1 (K), J5.1, R1.1, U1.4 (+)
unnamed: C4.1, L3.2
unnamed: C4.2, R5.2, RV1.2, U1.3 (Rg)
unnamed: C13.1, D3.1 (K), L4.1
unnamed: C14.1, D6.2 (A), L5.2
unnamed: C16.1, L6.2, U2.2 (-)
unnamed: D3.2 (A), D4.2 (A), J1.1, J10.1
unnamed: D4.1 (K), R6.1
unnamed: D5.1 (K), R7.1
unnamed: D5.2 (A), D6.1 (K), J1.3, J11.1
unnamed: J4.1, R3.2, R4.1, U2.3 (+)
unnamed: L3.1, R5.1, RV1.1, U1.2 (Rg)
OUT: J2.2, J8.1, U1.7
REF: C17.1, J2.4, J7.1, L6.1, U1.6 (Ref), U2.6 (OUT)

Notes on the sheet:
REFERENCE VOLTAGE DRIVER DEFAULT TO +2.5
OPTIONAL NOTCH FILTER FOR AD8428 DNI
INPUT FILTERING FOR RFI / PROTECTION DNI / ZERO IMPEDANCE
INSTRUMENTATION AMPLIFIER SECTION NOTE: AD8428 (FIXED GAIN INST. AMP.) SUBSTITUTABLE BY REMOVING Rg
INPUT / OUTPUT EDGE CONNECTIONS
BULK ELECTROLYTICS
REVERSE BIAS PROTECTION AND INPUT POWER LOWPASS CURRENTLY USING JELLYBEAN PARTS - NO SPECIFIC FILTER DESIGN
REFERENCE LOWPASS

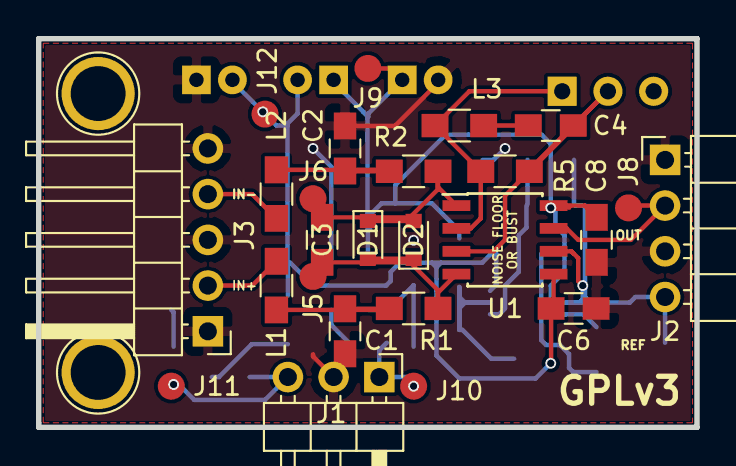
[picture p41: board inst_amp.kicad_pcb from above]

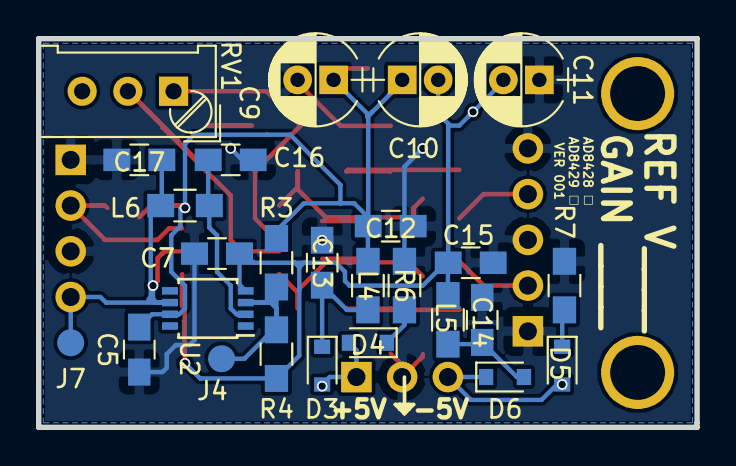
[picture p42: board inst_amp.kicad_pcb from below]

Board: 2 copper layers, 36.6 x 21.6 mm, 51 parts (26 on the bottom side), 22 nets.
