JasMoH/Photoacoustic/lock_in_amplifier/aaa/solder_test.kicad_pcb

## KiCad design lock_in_amplifier/aaa/solder_test.kicad_pcb (2017-12-29)

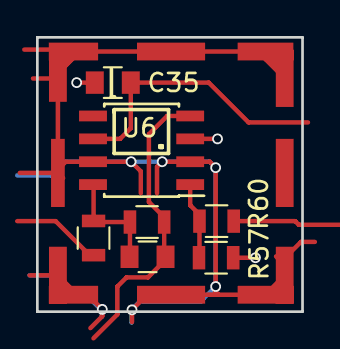
[picture p43: board solder_test.kicad_pcb from above]

Board: 2 copper layers, 14.7 x 15.2 mm, 8 parts (0 on the bottom side), 6 nets.

Parts:
C35: 0.1u; C_0805
C36: 10pF; C_0805
J17: RF_Shield_One_Piece; SMS-201
R55: 100M; R_0805
R57: 0; R_0805
R60: 10K; R_0805
R64: 100; R_0805
U6: lmp7721; SOIC-8_3.9x4.9mm_Pitch1.27mm

Connections:
/sheet5A330123/GUARD: J17.1, U6.2, U6.7
GND: C35.1, R57.1, U6.3
unnamed: C35.2, U6.6
unnamed: C36.1, R55.1, U6.4
unnamed: C36.2, R55.2, R64.1, U6.8
unnamed: R57.2, R60.2, U6.1
