JasMoH/Photoacoustic/(commit log)

2017-10-26 Add initial board for instrumentation amplifier
    [inst_amp.kicad_pcb, inst_amp.sch]
2017-10-27 incorporated schematic changes from peer review
    power PI filter
    test points
    reference voltage conector
    reference voltage LP filter
    power reverse bias protection
    power presense led
    gain pot
    [inst_amp.sch]
2017-10-27 selected pot footprint, fixed pot connection bug
    [inst_amp.sch]
2017-10-27 incorporated review comments to layout
    [inst_amp.kicad_pcb, inst_amp.sch]
2017-11-27 started creating final lock in amplifier
    [Demodulator.sch, LIA.kicad_pcb, LIA.sch, LNA.sch, Output_conditioning.sch, Power.sch, amplifiers.sch, file5A1C4292.sch]
2017-11-29 power supply, amp chain first pass
    [Demodulator.sch, LIA.sch, LNA.sch, Output_conditioning.sch, Power.sch, amplifiers.sch]
2017-12-01 initial transimpedance selection, lna refinement
    amp overload led
    switch comps added
    [Demodulator.sch, LIA.sch, LNA.sch, PLL.sch, Power.sch, amplifiers.sch]
2017-12-01 TIA, switch trades
2017-12-04 switch footprints, lm833 usage, pll investigation
    [Demodulator.sch, LIA.sch, LNA.sch, PLL.sch, Power.sch, amplifiers.sch]
2017-12-06 PLL initial implementation
    [Demodulator.sch, LIA.kicad_pcb, LIA.sch, LNA.sch, PLL.sch, Power.sch, amplifiers.sch]
2017-12-06 Added quadrature demod, phase shift to pll
    [Demodulator.sch, LIA.sch, LNA.sch, PLL.sch, Power.sch, amplifiers.sch]
2017-12-06 pll finalized - misc cleanup - review candidate
    [Demodulator.sch, LIA.sch, LNA.sch, PLL.sch, Power.sch, amplifiers.sch]
2017-12-11 initial layout of pll test board
    [PLL.sch, pll_test.kicad_pcb, pll_test.sch]
2017-12-14 manufacturing test for PLL
    [PLL.sch, pll_test.kicad_pcb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]
2017-12-15 started LNA test board.
    [Demodulator.sch, LIA.csv, LIA.kicad_pcb, LIA.sch, LNA.sch, LNA_test.kicad_pcb, LNA_test.sch, PLL.sch]
2017-12-15 initial lna and power floorplan finished.
    [LNA.sch, LNA_test.kicad_pcb, LNA_test.sch, Power.sch]
2017-12-18 initial LNA test layout
    everything connected - moving towards a manufacturability test.
    [LNA.sch, LNA_test.kicad_pcb, Power.sch]
2017-12-18 correct lmp7721 package - soic
    [LNA.sch, LNA_test.kicad_pcb]
2017-12-18 finished relayout of tia - soic
    [LNA_test.kicad_pcb]
2017-12-19 silkscreen readability changes
    [LNA_test.kicad_pcb]
2017-12-29 soldering manufacturing check
    [solder_test.kicad_pcb]
2018-01-04 adressing comments - fets
    [Demodulator.sch, LIA.sch, LNA.sch, PLL.sch, Power.sch, amplifiers.sch]
2018-01-04 misc debug
    [LNA_test.kicad_pcb, PLL.sch, pll_test.kicad_pcb]
2018-01-04 misc updates
    [SWTEST.kicad_pcb, SWTEST.sch]
2018-01-10 changed pin to static const
