JasMoH/Photoacoustic/(notices)

Notices in the files:
lock_in_amplifier/instrumentation amp bob/inst_amp.kicad_pcb:
LICENSE: GPLv3
GPLv3
lock_in_amplifier/LNA_test/LNA_test.kicad_pcb:
GPL V3.0
